YangQwQ/Stm32VisionSenseCar/Mobile-RemoteCtrl/res/bg.jpg

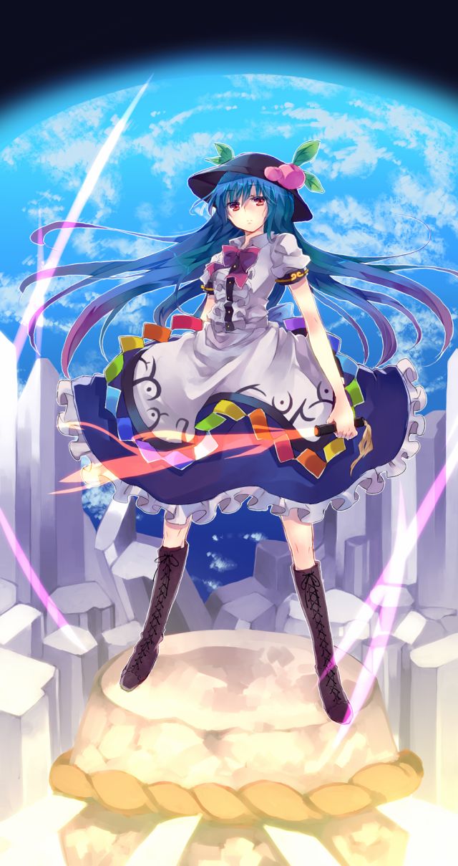
Mobile-RemoteCtrl/res/bg.jpg
