YangQwQ/Stm32VisionSenseCar/Stm32-Vision/src/exec/direct_exec.cpp

#include "src/exec/direct_exec.h"
#include "src/exec/nezha_direct.h"
#include "src/exec/bivar.h"
#include "src/core/board_log.h"   // blog::logf（临时调试 armdbg 用）
#include "Calibration.h"   // 集中式校准数据（舵机限位/移动表/标定点）
#include <math.h>
#include <string.h>

// 机械臂夹心坐标（车头系）：末端夹心 = f(移爪pwm, 抬落pwm)，两连杆+曲柄非线性，
// 用实测散点反距离加权插值(IDW)（数据在 Calibration.h 的 kArmPts），FK/IK 由 bivar 查插。

// 分段线性插值（查表），横轴需升序。仍被 move/spin 时长表复用。
static float plerp(const float* xs, const float* ys, int n, float x) {
  if (x <= xs[0]) return ys[0];
  for (int i = 1; i < n; i++) {
    if (x <= xs[i]) {
      float t = (x - xs[i-1]) / (xs[i] - xs[i-1]);
      return ys[i-1] + t * (ys[i] - ys[i-1]);
    }
  }
  return ys[n-1];
}

// 机械臂末夹心坐标（车头系：x=前方cm / h=离地cm）→ bivar 散点插值；失败时置 0，由调用方限位提示兜底。
static void arm_fk(int16_t reach_pwm, int16_t lift_pwm, float* x_out, float* h_out) {
  if (!bivar::arm_fk((float)reach_pwm, (float)lift_pwm, x_out, h_out)) { *x_out = 0; *h_out = 0; }
}

// ================= 内部状态 =================
// 当前各舵机 PWM（写板前跟踪，随指令/步进更新）
static int16_t s_steer = STEER_CENTER;
static int16_t s_reach = REACH_CENTER;
static int16_t s_lift  = LIFT_CENTER;
static int16_t s_grip  = GRIP_CENTER;
// 机械臂当前"姿态模式": 离散动作(low/raise/clip/grasp/release/fold)落地后记录, 移动臂位的动作
// (持续步进/pose/reset)清除回普通。给状态行/AI 明确"当前处于什么动作语义", 避免仅靠坐标/爪态猜。
enum { ARM_NONE = 0, ARM_LOW, ARM_RAISE, ARM_CLIP, ARM_GRASP, ARM_RELEASE, ARM_FOLD };
static uint8_t s_arm_mode = ARM_NONE;   // 是否处于折叠位: fold 置位, 移动臂位的动作清除

// 缓动分离：s_reach/s_lift = 目标(逻辑/状态读取用)，s_reach_w/s_lift_w = 实际写入板的 PWM。
// 离散定位(fold/arm_pose/reset/init)在 update_tick 里用 S 形曲线把 s_*_w 追向 s_*；
// 持续动作仍逐拍小步、不经缓动。t0 为缓动曲线行程锚点（新指令跳远时重置）。夹爪不参与。
static int16_t s_reach_w = REACH_CENTER;
static int16_t s_lift_w  = LIFT_CENTER;
static int32_t s_reach_t0 = 0;
static int32_t s_lift_t0  = 0;

// 小车行驶状态（本地合成用）：0 停 / 1 前 / 2 后
static int s_car_motion = 0;
static int s_spin = 0;        // 原地旋转：0 无 / 1 左进右退(右转/顺时针) / -1 左退右进(左转/逆时针)

// 夹心逻辑位置（车头系：x 前方cm / h 离地cm）。持续按钮在它之上步进后经 arm_pose 单点定位，
// 不再依赖 FK→微步→反解的连续闭环（散点 IDW 下该闭环会卡住）。由 每次臂指令 同步重置。
static float s_claw_x = 0, s_claw_h = 0;

// 最近一次 arm_pose 的位姿诊断：记录请求位姿与实际落点，供 read_state 反馈。
// 撞边界已被 arm_clamp 夹到盒内最近合法点并继续移动（reason=1），不再拒绝。
// 只在产生后 ARM_DIAG_FRESH_MS 内挂到状态行：诊断要跟着"刚下的那条指令"出现，过期就不再
// 重复挂（否则旧诊断会一轮轮粘在状态行上，让 AI 以为本轮的位姿又失败了）。
#define ARM_DIAG_FRESH_MS 8000
// 到位容差：正运动学回读的实际落点与请求相差超过它就认定"这个位姿做不到"。
// 可达域是条弯带而反查只按散点外接矩形判可达，弯带外的位姿会反解出"最接近"的 pwm、迭代
// 不收敛就停在半路（既不撞舵机限位也无报错），表现为"爪降不下去/卡住"——必须显式报出来。
#define ARM_POSE_TOL_CM 0.6f
static struct {
  bool armed;     // 本轮有诊断
  int  reason;    // 1=撞边界已夹紧到最近合法点 / 2=移爪越限 / 3=抬落越限 / 4=位姿没到位
  float x, h;     // 请求的目标夹心坐标（未夹紧前）
  float cx, ch;   // reason=1 时夹紧后的实际落点
  int rr, ll;     // 反解出的 target pwm
  float ax, ah;   // 正运动学回读的实际落点（reason=4 的判据与报数）
  unsigned long t_ms;   // 诊断产生时刻
} s_arm_rej = { false, -1, 0, 0, 0, 0, 0, 0, 0, 0, 0 };

// 灯状态记忆（供 get_state 查询同步手机按钮）：仅记录是否开，开关动作由 nezha::led 落地。
static bool s_light_front = false;
static bool s_light_vibe  = false;
static bool s_light_back  = false;

// 连续机械臂动作（联动模式）：axis=-1 表示无活跃动作。
// 前伸/缩回、抬/落都按"保持另一维"的末端位姿轨迹联动双舵机，而非单舵机步进。
static struct {
  int8_t axis;     // -1 无 / 0 联动前伸(x) / 1 联动抬落(h)
  int16_t dir;     // 每拍目标位姿增量方向（+/-）
  int16_t budget;  // 剩余拍数，0=持续
} s_active = { -1, 0, 0 };

// arm grasp 的第二步（合爪后自动抬臂）：时间到就发起定量的 lift_up。
// 拆成两拍是因为舵机合爪要时间 —— 同拍抬臂会在方块还没被夹住时就把它带飞。0=无待办。
static unsigned long s_grasp_lift_at = 0;
static int16_t s_grasp_lift_cm = (int16_t)GRASP_LIFT_CM;

// AI 持续 move 的行驶截止时刻（ms），0=不限时。到期 update_tick 里自动停轮，
// 兜底 AI 两次决策间的长时间盲走；任何新轮动作/手动接管会刷新或关闭它。
// volatile：worker 任务 / loop(update_tick) / 命令回调跨核读写，防寄存器缓存读到旧值。
static volatile unsigned long s_move_cap_until = 0;

static void drive_motors(int spd) {
  int16_t u = spd < 0 ? (uint16_t)-spd : (uint16_t)spd;
  bool rev = spd < 0;
  // 轮map：M1左后 M2右后 M3右前 M4左前；左轮 a 正前，右轮 b 正前。
  nezha::set_motor(1, rev ? 0u : u, rev ? u : 0u);
  nezha::set_motor(2, rev ? u : 0u, rev ? 0u : u);
  nezha::set_motor(3, rev ? u : 0u, rev ? 0u : u);
  nezha::set_motor(4, rev ? 0u : u, rev ? u : 0u);
}

static void set_steer_pwm(int16_t p);  // 前向声明：send_spin 在回正转向轮时会调用

// 原地旋转：目标角(deg) → 通电时长(ms)，查 SPIN_TBL_* 表线性插值（角升序，0 点隐含 (0,0)）。
// 实测曲线启动段与稳态每度 ms 差异大，单斜率公式拟合不了，查表才跟得上（见 Calibration.h）。
static long spin_ms_for(float deg) {
  if (deg <= 0) return 0;
  for (int i = 1; i < SPIN_TBL_N; i++) {
    if (deg <= SPIN_TBL_DEG[i]) {
      float t = (deg - SPIN_TBL_DEG[i-1]) / (SPIN_TBL_DEG[i] - SPIN_TBL_DEG[i-1]);
      return SPIN_TBL_MS[i-1] + (long)(t * (SPIN_TBL_MS[i] - SPIN_TBL_MS[i-1]));
    }
  }
  // 超出末点: 用末段斜率外推(大角度少见, 粗给即可)
  float k = (float)(SPIN_TBL_MS[SPIN_TBL_N-1] - SPIN_TBL_MS[SPIN_TBL_N-2]) /
            (SPIN_TBL_DEG[SPIN_TBL_N-1] - SPIN_TBL_DEG[SPIN_TBL_N-2]);
  return SPIN_TBL_MS[SPIN_TBL_N-1] + (long)((deg - SPIN_TBL_DEG[SPIN_TBL_N-1]) * k);
}

// 原地旋转（普通四轮滑移式，无需特殊轮子）：左/右侧轮反向拖胎绕中心旋转。
// dir=+1 左进右退=右转(顺时针) / -1 左退右进=左转(逆时针) / 0 停；speed=单车轮 pwm 0..1000。
// 车轮映射与 drive_motors 一致：左轮 a 正前、右轮 b 正前，故 dir>0 统一写 (a,0)、dir<0 统一写 (0,b)。
static void send_spin(const JsonObjectConst& p) {
  int dir = p["dir"] | 0;
  int spd = p["speed"] | 500;
  // 原地旋转前必须回正转向轮（前轮直行位），否则拖胎方向不纯、转不正（Bug6）。
  // dir=0（停车）不动舵机，避免每次停转都无谓地 reset 转向。
  if (dir != 0 && s_steer != STEER_CENTER) {
    set_steer_pwm(STEER_CENTER);
  }
  if (dir == 0) spd = 0;  // dir=0 = 停车，speed 必须连同归零，否则默认 500 会让轮子继续转
  if (spd < 0) spd = 0;
  if (spd > 1000) spd = 1000;
  if (dir != 0 && spd < SPIN_MIN_SPEED) spd = SPIN_MIN_SPEED;  // 低于拖得动线则抬升
  s_spin = dir == 0 ? 0 : (dir > 0 ? 1 : -1);
  uint16_t u = (uint16_t)spd;
  if (dir > 0) {
    nezha::set_motor(1, u, 0); nezha::set_motor(2, u, 0);
    nezha::set_motor(3, u, 0); nezha::set_motor(4, u, 0);
  } else {
    nezha::set_motor(1, 0, u); nezha::set_motor(2, 0, u);
    nezha::set_motor(3, 0, u); nezha::set_motor(4, 0, u);
  }
  s_car_motion = 0;  // 原地旋转不算前进/后退
  // 带 angle_deg = 定角微操：按时长近似自停（无里程计，不闭环）。
  int ang = p["angle_deg"] | 0;
  if (ang > 720) ang = 720;  // 粗钳防超长时限（手机/AI 已限 0..500，仅兜底裸前端）
  if (dir != 0) {
    // 显式 ms(调试/标定口)优先: 直接指定通电毫秒自停, 不做角度换算与滑行角补偿 —— 标定"真实每度ms"用。
    // angle_deg 可为 0(持续旋转口), 但带了 ms 就按定长精确到点自停, 不再落进"持续兜底"。
    long msv = p["ms"].is<int>() ? (long)(p["ms"] | 0) : 0;
    if (msv > 0) {
      exec::set_move_cap_ms((int)msv);
      return;
    }
  }
  if (dir != 0 && ang > 0) {
    // 目标角 → 通电时长：查表插值（见 spin_ms_for）。实测启动段与稳态速率差异大，查表最准。
    long ms = spin_ms_for((float)ang);
    exec::set_move_cap_ms(ms > 0 ? (int)ms : 1);
  } else if (dir != 0) {
    // 持续旋转（无 angle_deg / 无 ms）：摇杆 SpinMode 的主入口(捏杆转、松手 spin(0) 停)。
    // 不带任何"自动到点自停"的兜底: 一是它会骗人(用户以为只转一点、实际转 2.6s 半天)，
    // 二是持续旋转本就不累积车向底座(car_update_pose 只在带 angle_deg 时 +转角)，转了也不进入
    // 姿态基准，自动停毫无价值。靠显式 stop 或 spin(0) 收尾 —— 这是摇杆天然语义。
    // AI 侧 spin 一律带 angle_deg(见 ai_client 补默认角)，走的是上面定角分支，不会进这里。
  }
}

static void clear_active(void) { s_active.axis = -1; s_active.budget = 0; }

// 撤销"合爪后待抬臂"（任何新的臂指令/停车/回正都作废它，避免隔了几拍突然自己抬一下）。
static void clear_grasp_pending(void) { s_grasp_lift_at = 0; }

// 前置声明：grasp 的第二步（合爪后自动抬臂）在 update_tick 里发起，而定义在它之后。
static void setup_active(int8_t axis, int16_t dir, bool has_dist, int16_t dist);

// S 形缓动一步：把"已写 cur"平滑追向"目标 tgt"。速度按正弦分布（两端 0=缓出缓入、中段峰值），
// 目标显著跳远(新指令)会重新锚定行程并本拍不动作为缓入；到位直接落定，避免往返抖动。
static void advance_smooth(int16_t* cur, int16_t tgt, int32_t* t0) {
  int32_t gap = (int32_t)tgt - (int32_t)*cur;
  if (gap == 0) { *t0 = 0; return; }
  int32_t rem = gap < 0 ? -gap : gap;
  if (rem > *t0) { *t0 = rem; return; }             // 目标跳远 → 缓入起点，本拍不动
  float p = (float)(*t0 - rem) / (float)*t0;        // 已完成比例 0..1
  if (p > 1.0f) p = 1.0f;
  int16_t step = (int16_t)(ARM_SMOOTH_PEAK * sinf((float)PI * p) + 0.5f);
  if (step < 1) step = 1;                           // 保底，确保最终必到
  if (rem <= step) { *cur = tgt; *t0 = 0; return; }
  *cur += (gap > 0 ? step : -step);
}

static void write_steer(void) { nezha::set_servo(1, (uint16_t)s_steer); }
static void write_reach(void) { nezha::set_servo(2, (uint16_t)s_reach_w); }
static void write_grip(void)  { nezha::set_servo(3, (uint16_t)s_grip); }
static void write_lift(void)  { nezha::set_servo(4, (uint16_t)s_lift_w); }

static void set_steer_pwm(int16_t p) {
  if (p < STEER_LO) p = STEER_LO;
  if (p > STEER_HI) p = STEER_HI;
  s_steer = p; write_steer();
}

void exec::init(void) {
  // 惰性：nezha::init 幂等。回中四个舵机 + 电机 0。
  bivar::arm_init();   // 校验机械臂夹心标定散点并置 ready（setup 期调用一次，幂等）
  set_steer_pwm(STEER_CENTER);
  s_reach = REACH_CENTER;  write_reach();
  s_lift  = LIFT_CENTER;   write_lift();
  s_grip  = GRIP_CENTER;   write_grip();
  drive_motors(0);
  // 灯复位: 哪吒扩展板的灯由**它自己的硬件寄存器**保持(不经本 MCU GPIO), MCU 重启/重新烧录后,
  // 灯在上一次的状态里**仍然亮着**, 而本板 s_light_* 记忆在重启后是不会自己变 false 的 —— 于是"灯
  // 实际亮着、状态却记成灭", 手机/状态位跟灯对不上(烧录后发现灯亮着但状态不同步, 就是这个)。
  // 这里主动关三盏灯并清记忆: 重启/回正 = 回到"灯灭 + 状态灭"的一致初始态(清晰直观, 符合直觉)。
  nezha::led("front", false); nezha::led("vibe", false); nezha::led("back", false);
  s_light_front = false; s_light_vibe = false; s_light_back = false;
}

void exec::reset(void) {
  s_car_motion = 0;
  s_spin = 0;
  s_move_cap_until = 0;
  clear_active();
  clear_grasp_pending();
  s_arm_rej.armed = false;  // 回正清掉旧的"目标不可达"诊断，避免状态残留误导
  exec::init();
}

void exec::update_tick(void) {
  // AI 持续/微操动作的行驶时限兜底：到期自动停轮（转向/机械臂不干预），状态复位便于 AI 看到"停止"。
  if (s_move_cap_until != 0 && (long)(millis() - s_move_cap_until) >= 0) {
    s_move_cap_until = 0;
    drive_motors(0);
    s_car_motion = 0;
    s_spin = 0;  // 原地旋转定角到点也一并复位，避免状态误报"仍在原地转"
  }
  // arm grasp 第二步：合爪等够时间后自动定量抬臂（起点锚在舵机真实位置，见 setup_active）。
  if (s_grasp_lift_at != 0 && (long)(millis() - s_grasp_lift_at) >= 0) {
    s_grasp_lift_at = 0;
    setup_active(1, +1, true, s_grasp_lift_cm);
    blog::logf(blog::EXEC, "grasp: 合爪完成, 抬臂 %dcm", s_grasp_lift_cm);
  }
  if (s_active.axis < 0) {
    // 无活跃持续动作：离散定位（fold / arm_pose / reset / init）经 S 形缓动把已写值追向目标，
    // 避免一次性跳舵机把整车带震。夹爪不参与，仍即时到位。
    int16_t nr = s_reach_w, nl = s_lift_w;
    advance_smooth(&nr, s_reach, &s_reach_t0);
    advance_smooth(&nl, s_lift,  &s_lift_t0);
    if (nr != s_reach_w || nl != s_lift_w) { s_reach_w = nr; s_lift_w = nl; write_reach(); write_lift(); }
    return;
  }
  // 夹心持续平动：在逻辑位置 s_claw 上沿目标轴步进、保持另一维，再 arm_pose 单点定位。
  // 连续步进需节流帧率：伺服跟不上会产生滞后，FK 反馈读到滞后位置再回拽 → 极限环。
  // 约 50ms 落一步，伺服跟得上、反馈才稳。
  static uint32_t s_arm_step_ms = 0;
  uint32_t now_ms = millis();
  if (s_arm_step_ms != 0 && now_ms - s_arm_step_ms < 50) return;
  s_arm_step_ms = now_ms;
  if (s_claw_x < 1.f && s_claw_h < 1.f) {   // 逻辑位置未初始化（reset 后首动）：从当前舵机反算
    arm_fk(s_reach, s_lift, &s_claw_x, &s_claw_h);
  }
  float tx = s_claw_x, th = s_claw_h;
  if (s_active.axis == 0) tx += ARM_STEP_CM * s_active.dir;   // 前伸/缩回：x 变，h 不变
  else                    th += ARM_STEP_CM * s_active.dir;   // 抬/落：h 变，x 不变
  // 撞边界先夹到盒内合法点（继续移动，不拒绝）
  bivar::arm_clamp(&tx, &th);
  if (!exec::arm_pose(tx, th)) { clear_active(); return; }    // 夹紧后仍不可达（物理限位）：到边即停
  s_reach_w = s_reach; s_lift_w = s_lift; write_reach(); write_lift();
  // 回授协调：只把"被步进的轴"锚到真实 FK，保持轴维持命令值——避免 fk 噪声把保持轴带入
  // 极限环 / 按住后反向漂移。臂到真实物理极限时 FK 停进，s_claw 随之停，命令不再空推。
  float rxx = 0, rhh = 0;
  if (bivar::arm_fk((float)s_reach, (float)s_lift, &rxx, &rhh)) {
    if (s_active.axis == 0) { s_claw_x = rxx; s_claw_h = th; }   // 移爪：x 跟回授，h 保持命令
    else                    { s_claw_h = rhh; s_claw_x = tx; }   // 抬落：h 跟回授，x 保持命令
  } else {
    s_claw_x = tx; s_claw_h = th;     // 反算越数据范围读不到：回退用目标（夹紧后仍 push）
  }
  // 到边界即停：连续 N 拍"被步进的那一轴"FK 回读几乎不动，说明已顶到机械/可达域边界，再推只是让
  // arm_pose 反复重解同一个位姿 —— 最高位附近散点稀疏，IDW 会在两个解之间来回跳，舵机就嗡嗡抽搐
  // (实测只在抬到最高位时出现)。这里主动停，和"收到 stop(scope=arm)/新离散动作"是同一条清场路径。
  // ⚠️ 判定只看**被步进的那一轴**(抬升=这拍 s_claw_h 变 → 看 h；移爪=看 x)，**不看保持轴**：
  //   保持轴维持命令值、但 arm_pose 每次反解写入的 PWM 在可达域边界附近外插抖动会让 FK 回读跟着微动
  //   (实测 ±0.03~0.08cm)，若把两轴做成"且"关系，保持轴的噪声会把 stall 计数屡屡清零 → 到顶永远判不出来，
  //   持续步进就抽插。分轴判据让"动的那轴到位" 独立成立。
  {
    static float s_last_fk_x = -999, s_last_fk_h = -999;
    static int s_fk_stall = 0;
    bool moving_h = (s_active.axis == 1);   // 被步进的是抬落(h)轴(否则是移爪 x 轴)
    float dv = moving_h ? fabsf(rhh - s_last_fk_h) : fabsf(rxx - s_last_fk_x);
    if (dv < ARM_STALL_EPS_CM) {
      if (++s_fk_stall >= ARM_STEP_STALL_N) {
        blog::logf(blog::EXEC, "连续动作已到边界(FK 连续 %d 拍停在 (%.1f,%.1f)), 停止步进",
                   s_fk_stall, rxx, rhh);
        s_fk_stall = 0;
        clear_active();
        return;
      }
    } else {
      s_fk_stall = 0;
    }
    s_last_fk_x = rxx; s_last_fk_h = rhh;
  }
  if (s_active.budget > 0) {
    if (--s_active.budget <= 0) clear_active();
  }
}

static void setup_active(int8_t axis, int16_t dir, bool has_dist, int16_t dist) {
  s_active.axis = axis;
  s_active.dir = dir;
  s_active.budget = has_dist ? (int16_t)(dist * ARM_CNT_PER_CM) : 0;
  // 每次持续移动起点：把逻辑坐标重新锚到舵机真实当前位置（FK）。否则 reset/fold/离散
  // arm_pose 后残留旧逻辑值，首拍会从旧坐标起步、朝反方向先补一枪。
  float fx = 0, fh = 0;
  if (bivar::arm_fk((float)s_reach_w, (float)s_lift_w, &fx, &fh)) { s_claw_x = fx; s_claw_h = fh; }
}

static void send_arm(const JsonObjectConst& p) {
  // 每次手臂指令先清掉可能残留的旧联动步进（s_active）：防止上次持续动作因 button_up/限位
  // 等原因未清干净，导致本次新指令被上次残留干扰而"点了没反应"（回正=全清后即恢复）。
  clear_active();
  clear_grasp_pending();   // 新臂指令作废上一条 grasp 未执行的抬臂（grasp 分支自己会重新置上）
  const char* act_ = p["act"] | "";
  bool has_dist = p["dist_cm"].is<int>();
  int16_t dist = (int16_t)((int)(p["dist_cm"] | 0));

  if (!strcmp(act_, "lift_up") || !strcmp(act_, "lift_down")) {
    // 抬落（联动 h 轴）：lift_up = 末端升高（h+）；lift_down = 降低（h-），保持 x 不变。
    int16_t dir = !strcmp(act_, "lift_up") ? +1 : -1;
    s_arm_mode = ARM_NONE;   // 移动臂位即脱离固定姿态
    setup_active(1, dir, has_dist, dist);
  } else if (!strcmp(act_, "reach_forward") || !strcmp(act_, "reach_backward")) {
    // 移爪（联动 x 轴）：forward = 前伸（x+）；backward = 缩回（x-），保持高度 h 不变。
    int16_t dir = !strcmp(act_, "reach_forward") ? +1 : -1;
    s_arm_mode = ARM_NONE;
    setup_active(0, dir, has_dist, dist);
  } else if (!strcmp(act_, "low")) {
    // 低姿夹取准备位（一次性离散，落点见 Calibration.h ARM_LOW_*）：降到标定过的固定低姿，之后靠
    // 车的前后移动把目标送进两指之间。不夹爪、不动轮子。
    exec::arm_low();
  } else if (!strcmp(act_, "clip")) {
    clear_active();
    s_grip = GRIP_CLOSE; write_grip();
    s_arm_mode = ARM_CLIP;   // 已合上夹爪(未抬臂)
  } else if (!strcmp(act_, "grasp")) {
    // 夹取+抬臂组合（合爪 → 等舵机合到位 → 定量抬升）：一步到位省一轮云端往返。
    // 抬升量固定（GRASP_LIFT_CM），不会像持续 lift_up 那样顶到机械止点抽搐。
    clear_active();
    s_grip = GRIP_CLOSE; write_grip();
    s_arm_mode = ARM_GRASP;   // 合爪并已请求抬臂(抬升在 update_tick 异步完成, 被打断会清回普通)
    s_grasp_lift_cm = (int16_t)GRASP_LIFT_CM;
    s_grasp_lift_at = millis() + (unsigned long)GRASP_SETTLE_MS;
  } else if (!strcmp(act_, "release")) {
    clear_active();
    s_grip = GRIP_HI; write_grip();
    s_arm_mode = ARM_RELEASE;   // 已松开夹爪
  } else if (!strcmp(act_, "fold")) {
    // 收臂折叠回平台（一次性离散）：抬落 + 移爪都收到 130、夹爪回中；摄像头到最高位扩大视野、避开盲区。
    // 不动车轮（区别于 reset 的全停）。
    clear_active();
    s_lift  = FOLD_LIFT_PWM;  write_lift();
    s_reach = FOLD_REACH_PWM; write_reach();
    s_grip  = GRIP_CENTER;    write_grip();
    s_arm_mode = ARM_FOLD;
  }
}

// 定距指令的油门要**先于写电机**定下来，且写电机与算时长必须用**同一个**油门，否则模型不自洽。
// 为什么必须按距离降档：`plerp` 在首档以下整段钳位，而各档的起停余量 c 相差很大（0.5 档 c=3.45cm）。
// cm ≤ c(a) 时 target 被算成 0 ⇒ 脉冲塌成 MV_MIN_PULSE_MS 的**满油门一冲** —— 那已经不是"走 2cm"了，
// 而 AI 仍以为自己在做厘米级微调。降档后取 c 小于本次距离的最低已标定档，距离才真的对得上。
// 档位只在标定表内取；请求油门低于最低档（AI 偶发 0.1）时抬到最低档 —— 低于它的速度没有实测值，
// 照原样发等于把"指令走了、车没动"重新引入一遍（表外不外推）。
static float pick_throttle_for(float a, int cm) {
  for (int i = MV_N - 1; i >= 0; i--) {
    if (MV_SPEED_X[i] > a + 1e-4f) continue;   // 只降不升（除下面的兜底）
    if (MV_COAST_Y[i] < (float)cm) return MV_SPEED_X[i];
  }
  return MV_SPEED_X[0];
}

static void send_move(const JsonObjectConst& p) {
  float th = p["throttle"] | 0.0f;
  float st = p["steering"] | 0.0f;
  int cm = p["distance_cm"] | 0;

  float a = fabsf(th); if (a > 1.0f) a = 1.0f;
  if (cm > 0 && a > 0.001f) {
    a = pick_throttle_for(a, cm);
    th = th < 0 ? -a : a;   // 写回，使 PWM 与下面计时的油门是同一个值
  }

  if (fabsf(th) > 0.001f) {
    int16_t spd = (int16_t)(a * 1000.0f + 0.5f);
    if (th < 0) spd = -spd;
    drive_motors(spd);
    s_car_motion = th > 0 ? 1 : 2;
  } else {
    drive_motors(0);
    s_car_motion = 0;
  }
  if (fabsf(st) > 0.001f) {
    float s = st; if (s > 1.0f) s = 1.0f; if (s < -1.0f) s = -1.0f;
    set_steer_pwm((int16_t)(STEER_CENTER + s * 30.0f));
  } else {
    set_steer_pwm(STEER_CENTER);   // 直行时回正：上一次带转向的 move 若不回正, 之后所有 move 都在画弧
  }
  s_spin = 0;  // 常规行驶（move）接管后清除原地旋转
  // 带 distance_cm = 定距微操：本板无里程计，按时长近似自停。实测 actual≈v·(t−死区)+c，
  // v/c 随油门插值标定表，时长 = MV_START_MS + (cm−c)/v。
  // ⚠️ 两处都别省：v/c 表拟合自长脉冲，短脉冲会整段落在起步死区里 —— 车一动不动，而
  // car_update_pose 照样按 distance_cm 累加 → AI 记忆与实际分家（空夹的主要来路）。
  // 油门 a 已在上面按距离定过档，这里直接用同一个值。
  if (cm > 0 && a > 0.001f) {
    float v = plerp(MV_SPEED_X, MV_SPEED_Y, MV_N, a);
    float c = plerp(MV_COAST_X, MV_COAST_Y, MV_N, a);
    float target = cm > c ? cm - c : 0.0f;
    long ms = MV_START_MS + (long)(target / v * 1000.0f);
    if (ms < MV_MIN_PULSE_MS) ms = MV_MIN_PULSE_MS;
    exec::set_move_cap_ms((int)ms);
  }
}

static void send_stop(const JsonObjectConst& p) {
  const char* scope = p["scope"] | "all";
  if (!strcmp(scope, "arm")) {
    clear_active();
    clear_grasp_pending();
  } else {
    drive_motors(0);
    s_car_motion = 0;
    s_spin = 0;
  }
}

bool exec::set_servo(uint8_t logical, uint16_t pwm) {
  // 调试直驱：直接写原始 pwm（50..250），不过标定限位——用于探机械极限/标定。
  if (pwm < 50 || pwm > 250) return false;
  switch (logical) {
    case 0:  // 转向
      s_steer = (int16_t)pwm; write_steer();
      return true;
    case 1:  // 左 = 前后移爪
      s_reach = (int16_t)pwm; write_reach();
      return true;
    case 2:  // 右 = 抬落
      s_lift = (int16_t)pwm; write_lift();
      return true;
    case 3:  // 前 = 夹爪
      s_grip = (int16_t)pwm; write_grip();
      return true;
    default:
      return false;
  }
}

// 迭代反解：以 IDW 反查询为初值，用正演 FK 走牛顿迭代校正，使 FK(pwm)→目标精确，
// 消除 IDW FK∘IK 不互逆（否则持续相控时每步被 FK 打回 / 或边界空推）。到物理限位自动饱和停滞。
static bool ik_refine(float x, float h, float* r, float* l) {
  if (!bivar::arm_ik(x, h, r, l)) return false;   // 反查初值；越标定盒返回 false
  float rp = *r, lp = *l;
  for (int it = 0; it < 7; it++) {
    float fx, fh;
    if (!bivar::arm_fk(rp, lp, &fx, &fh)) break;             // 出标定数据区：没法校正，用当前值
    float ex = x - fx, eh = h - fh;
    if (fabsf(ex) < 0.02f && fabsf(eh) < 0.02f) break;        // 已收敛
    const float d = 1.0f;                                     // 数值雅可比：reach/lift 各偏 d
    float fxr, fhr, fxl, fhl;
    if (!bivar::arm_fk(rp + d, lp, &fxr, &fhr)) break;
    if (!bivar::arm_fk(rp, lp + d, &fxl, &fhl)) break;
    float J00 = (fxr - fx) / d, J01 = (fxl - fx) / d;
    float J10 = (fhr - fh) / d, J11 = (fhl - fh) / d;
    float det = J00 * J11 - J01 * J10;
    if (fabsf(det) < 1e-6f) break;                            // 奇异（饱和区雅可比退化）
    float dr = (ex * J11 - J01 * eh) / det;
    float dl = (-J10 * ex + J00 * eh) / det;
    dr = fmaxf(-6.f, fminf(6.f, dr));                         // 阻尼防发散
    dl = fmaxf(-6.f, fminf(6.f, dl));
    rp += dr; lp += dl;
    rp = fmaxf((float)REACH_LO, fminf((float)REACH_HI, rp));
    lp = fmaxf((float)LIFT_LO, fminf((float)LIFT_HI, lp));
  }
  *r = rp; *l = lp;
  return true;
}

bool exec::arm_pose(float x, float h) {
  // 给末端目标位姿：x=夹心车头前方 cm，h=夹心离地高度 cm。反解：IDW 反查初值 + FK 迭代校正
  // （使反解出的 PWM 的实际 FK 回读≈目标，收敛到物理饱和为止）。超出盒先夹到盒内最近的
  // 合法点再反解——不拒绝，移到最接近的合法位姿；反解落在物理舵机限位外也夹到限位继续。
  s_arm_rej.x = x; s_arm_rej.h = h;
  s_arm_rej.armed = false;   // 诊断只反映"最近这一次 arm_pose"：先清，下面按本轮结果重新置位
  s_arm_rej.reason = 0;      // 原因同清：否则下面判 armed 时会沿用上一轮的原因(如上次的 4)而误报
  bool clamped = bivar::arm_clamp(&x, &h);
  // 夹到盒内后戳地(h<0)已不可达（盒 h 最小>0），这里仅兜底负高度竖直挤压情形。
  float reach = 0, lift = 0;
  if (!ik_refine(x, h, &reach, &lift)) return false;  // 反查初值即出盒→不可达
  int rr = (int)roundf(reach), ll = (int)roundf(lift);     // 左=移爪 reach / 右=抬落 lift
  // 反解在稀疏角区外插可能越物理限位：夹到舵机限位继续执行而非拒绝，让标定盒内的位姿总能
  // 尽力移到组件物理边界（否则 IDW 一外插超限就被当"不可达"卡住）。撞物理限位也算夹紧记进诊断。
  bool phy_r = false, phy_l = false;
  if (rr < REACH_LO) { rr = REACH_LO; phy_r = true; }
  else if (rr > REACH_HI) { rr = REACH_HI; phy_r = true; }
  if (ll < LIFT_LO) { ll = LIFT_LO; phy_l = true; }
  else if (ll > LIFT_HI) { ll = LIFT_HI; phy_l = true; }
  // 联动：一次同时给左右两舵机目标。set_servo 内部会限 pwm 并同步状态。
  bool ok = set_servo(1, (uint16_t)rr) & set_servo(2, (uint16_t)ll);
  // 到位校验：反解只在物理限位处才会失败，弯带外的位姿则会"尽力挪一下"就停住（见 ARM_POSE_TOL_CM
  // 注释）。这里用正运动学回读实际落点，偏离请求即记为诊断，让 AI 知道"这条位姿做不到"而不是
  // 只看状态行的绝对位置、反复重发同一条够不着的指令。
  bivar::arm_fk((float)rr, (float)ll, &s_arm_rej.ax, &s_arm_rej.ah);
  s_arm_rej.rr = rr; s_arm_rej.ll = ll;
  s_arm_rej.t_ms = millis();
  // reason 必须与本轮 armed 一起判定（曾漏写：仅 phy 命中时不更新 reason，于是报告沿用上一次的
  // 原因甚至初值 -1，AI 拿到的是错误的解释）。
  if (clamped) { s_arm_rej.reason = 1; s_arm_rej.cx = x; s_arm_rej.ch = h; }
  else if (phy_r) s_arm_rej.reason = 2;
  else if (phy_l) s_arm_rej.reason = 3;
  else if (fabsf(s_arm_rej.ax - x) > ARM_POSE_TOL_CM || fabsf(s_arm_rej.ah - h) > ARM_POSE_TOL_CM)
    s_arm_rej.reason = 4;
  s_arm_rej.armed = clamped || phy_r || phy_l || s_arm_rej.reason == 4;
  return ok;
}

bool exec::arm_low(void) {
  // 低姿夹取准备位：固定落到标定过的低姿（Calibration.h ARM_LOW_*），不夹爪、不动轮子。
  // 存在意义：低处可达域很窄，让上层凭坐标猜 (x,h) 会猜到够不着的地方、空夹且无报错；改成一个
  // 保证够得着的固定位，再用车的前后移动把目标送进两指之间（机械臂不能左右移动）。
  clear_active();   // 与其它 arm 指令一致：先清残留持续步进，否则首拍会朝旧方向补一枪
  s_arm_mode = ARM_LOW;   // 已降入低姿夹取位(后续移动臂位/pose 会清回普通)
  bool ok = exec::arm_pose(ARM_LOW_X_CM, ARM_LOW_H_CM);
  // 逻辑坐标锚到实际落点（连续步进起点/后续 diagnose 的基准），别沿用上一动作的旧值。
  float rx = 0, rh = 0;
  if (exec::arm_pos(&rx, &rh)) { s_claw_x = rx; s_claw_h = rh; }
  else { s_claw_x = ARM_LOW_X_CM; s_claw_h = ARM_LOW_H_CM; }
  return ok;
}

bool exec::arm_raise(void) {
  // 固定抬臂位：一次离散定位到标定过的固定高位（Calibration.h ARM_RAISE_*）。
  // 与持续 lift_up 的区别：arm_pose 是单发目标（update_tick 里 S 形缓动追到位），
  // 不会像连续步进那样在边界 IDW 反解两解间来回跳、舵机抽搐。
  clear_active();   // 与其它臂指令一致：先清残留持续步进
  clear_grasp_pending();
  s_arm_mode = ARM_RAISE;   // 已抬到固定高位(后续移动臂位/pose 会清回普通)
  bool ok = exec::arm_pose(ARM_RAISE_X_CM, ARM_RAISE_H_CM);
  float rx = 0, rh = 0;
  if (exec::arm_pos(&rx, &rh)) { s_claw_x = rx; s_claw_h = rh; }
  else { s_claw_x = ARM_RAISE_X_CM; s_claw_h = ARM_RAISE_H_CM; }
  return ok;
}

bool exec::arm_pos(float* x, float* h) {
  // 与 read_state 同源：报"当前命令的 pwm"的 FK（不是缓动途中的中间值），上层据此判"爪是否真的
  // 停在目标身上"时，看到的和自己读状态行是同一个数。标定未就绪返回 false（调用方按未知处理）。
  float fx = 0, fh = 0;
  if (!bivar::arm_fk((float)s_reach, (float)s_lift, &fx, &fh)) return false;
  if (x) *x = fx < 0 ? 0.0f : fx;
  if (h) *h = fh;
  return true;
}

bool exec::act(const char* type, const JsonObjectConst& params) {
  // 任何显式轮子/原地旋转指令都刷新或关闭 AI 的 move 时限，避免旧兜底在新指令后误停。
  if (!strcmp(type, "move") || !strcmp(type, "spin") || !strcmp(type, "stop")) s_move_cap_until = 0;
  if (!strcmp(type, "move"))   { send_move(params); return true; }
  if (!strcmp(type, "spin"))   { send_spin(params); return true; }
  if (!strcmp(type, "stop"))   { send_stop(params); return true; }
  if (!strcmp(type, "arm"))    { send_arm(params);  return true; }
  if (!strcmp(type, "arm_pose")) {
    // AI/手动指定位姿：x=夹心车头前方 cm，h=夹心离地高度 cm；不可达返回 false（不动）。
    s_arm_mode = ARM_NONE;   // 指定位姿脱离固定姿态(通用定位, 不再表达 low/raise/夹取等语义)
    clear_grasp_pending();
    return arm_pose(params["x"] | 0.0f, params["h"] | 0.0f);
  }
  if (!strcmp(type, "light")) {
    const char* kind = params["kind"] | "";
    bool on = params["on"] | false;
    bool ok = nezha::led(kind, on);
    if (ok) {
      if (!strcmp(kind, "front")) s_light_front = on;
      else if (!strcmp(kind, "vibe")) s_light_vibe = on;
      else if (!strcmp(kind, "back")) s_light_back = on;
    }
    return ok;
  }
  if (!strcmp(type, "reset"))  { exec::reset(); s_arm_mode = ARM_NONE; return true; }
  return false;
}

bool exec::is_continuous(const char* type, const JsonObjectConst& p) {
  if (!strcmp(type, "move")) {
    float th = p["throttle"] | 0.0f;
    float st = p["steering"] | 0.0f;
    return (fabsf(th) > 0.001f && !p["distance_cm"].is<int>()) ||
           (fabsf(st) > 0.001f && !p["angle_deg"].is<int>());
  }
  if (!strcmp(type, "spin")) {
    int d = p["dir"] | 0;
    return d != 0 && !p["angle_deg"].is<int>();  // 带 angle 的定角=有界，不需持续收尾
  }
  if (!strcmp(type, "arm")) {
    const char* act_ = p["act"] | "";
    bool cont = !strcmp(act_, "lift_up") || !strcmp(act_, "lift_down") ||
                !strcmp(act_, "reach_forward") || !strcmp(act_, "reach_backward");
    return cont && !p["dist_cm"].is<int>();
  }
  return false;
}

bool exec::wheels_moving() { return s_car_motion != 0 || s_spin != 0; }

bool exec::arm_moving() {
  // 机械臂还在动的情形有三类，各自与 wheels_moving()（只盯轮子 PWM）完全无关，缺一不可：
  // ① s_active.axis >= 0：持续步进（lift_up/down、reach_fwd/bwd）进行中，逐拍 arm_pose 定位。
  // ② s_grasp_lift_at != 0：grasp 合爪后正等待定时抬臂（第二步还没发起），画面仍在"夹起过程"中。
  // ③ S 形缓动未收敛：离散定位（fold/arm_pose/reset/init）在 update_tick 里把已写值 s_reach_w /
  //    s_lift_w 缓动追向目标 s_reach / s_lift，未追到就说明臂还没停。grasp 第二步的 lift 也走这路。
  // 只要有一类存在，臂就在动 —— AI 出帧若不等它会拍到"夹起过程"的中间态画面。
  if (s_active.axis >= 0) return true;
  if (s_grasp_lift_at != 0) return true;
  return (s_reach_w != s_reach) || (s_lift_w != s_lift);
}

bool exec::grip_closing() { return s_grip == GRIP_CLOSE; }

void exec::set_move_cap_ms(int ms) {
  s_move_cap_until = ms > 0 ? millis() + (unsigned long)ms : 0;
}

bool exec::light_on(const char* kind) {
  if (!strcmp(kind, "front")) return s_light_front;
  if (!strcmp(kind, "vibe"))  return s_light_vibe;
  if (!strcmp(kind, "back"))  return s_light_back;
  return false;
}

bool exec::read_state(char* buf, size_t cap) {
  const char* car = s_spin != 0 ? (s_spin > 0 ? "原地右转" : "原地左转")
                                : (s_car_motion == 1 ? "前进" : (s_car_motion == 2 ? "后退" : "停止"));
  const char* grip = s_grip <= GRIP_CLOSE + 5 ? "clip" : "release";
  // 机械臂到限位提示：告诉 AI 继续同向动作不会再有变化（需反向或调整姿态）。
  const char* reach_lim = s_reach >= REACH_HI - 2 ? " 已伸最远"
                        : (s_reach <= REACH_LO + 2 ? " 已缩最近" : "");
  const char* lift_lim  = s_lift >= LIFT_HI - 2 ? " 已触底"
                        : (s_lift <= LIFT_LO + 2 ? " 已触顶" : "");
  // 末端前端坐标（前向运动学）：让 AI 知道夹爪现在伸到多前、多高，判断还能往哪移/当前高度。
  // 括号内为左右舵机 PWM（Servo2=移爪 s_reach / Servo4=抬落 s_lift），供 exec_log 校准机械臂坐标。
  float fk_x = 0, fk_h = 0;
  arm_fk(s_reach, s_lift, &fk_x, &fk_h);
  if (fk_x < 0) fk_x = 0;
  // 臂态语义：当前处于哪个固定姿态（low/raise/grasp/fold），移动臂位的动作后回到"自由"。
  // 给 AI 明确反馈，避免"已折叠仍反复 fold / 已夹取却不知处于何态"。爪态(开/合)单独看 s_grip。
  const char* arm_stat = "自由";
  switch (s_arm_mode) {
    case ARM_LOW:     arm_stat = "low"; break;
    case ARM_RAISE:   arm_stat = "raise"; break;
    case ARM_GRASP:   arm_stat = "grasp"; break;
    case ARM_FOLD:    arm_stat = "fold"; break;
    default: break;
  }
  // 调试时才使用带pwm的
  // snprintf(buf, cap, "小车: %s | 夹爪: %s 姿态: %s 位置: (%.0f, %.0f)(%d,%d) %s%s", car, grip, arm_stat, fk_x, fk_h, (int)s_reach, (int)s_lift, reach_lim, lift_lim);
  snprintf(buf, cap, "小车: %s | 夹爪: %s 姿态: %s 位置: (%.0f, %.0f)%s%s",
           car, grip, arm_stat, fk_x, fk_h, reach_lim, lift_lim);
  // 撞边界/不可达诊断：反馈"想去哪、实际落到哪/反解成多少"，帮用户/AI 判断机械臂边界
  // （exec_log 推给手机）。reason=1 表示撞边界但已夹到最近合法点继续移动，非错误。
  // 只在诊断新鲜时挂（见 ARM_DIAG_FRESH_MS）：它是"刚下的那条指令的结果"，过期的别重复报。
  if (s_arm_rej.armed && millis() - s_arm_rej.t_ms <= ARM_DIAG_FRESH_MS) {
    char d[160];
    if (s_arm_rej.reason == 1) {
      snprintf(d, sizeof(d), " | 撞边界[已移至最近点(%.1f,%.1f)]", s_arm_rej.cx, s_arm_rej.ch);
    } else if (s_arm_rej.reason == 4) {
      snprintf(d, sizeof(d), " | 位姿没到位[请求(%.1f,%.1f)只到(%.1f,%.1f): 该位姿够不着, 换位姿或挪车]",
               s_arm_rej.x, s_arm_rej.h, s_arm_rej.ax, s_arm_rej.ah);
    } else {
      const char* rc = s_arm_rej.reason == 2 ? "移爪越限" : "抬落越限";
      snprintf(d, sizeof(d), " | 目标(%.1f,%.1f)不可达[%s] 反解reach=%d lift=%d",
        s_arm_rej.x, s_arm_rej.h, rc, s_arm_rej.rr, s_arm_rej.ll);
    }
    if (strlen(buf) + strlen(d) + 1 < cap) strcat(buf, d);
  }
  return buf[0] != '\0';
}
