YangQwQ/Stm32VisionSenseCar/Stm32-Vision/ai_client.cpp

#include "ai_client.h"
#include "config.h"
#include "camera.h"
#include "direct_exec.h"
#include "wifi_net.h"
#include "ground_proj.h"
#include "board_log.h"

#include <WiFi.h>
#include <WiFiClientSecure.h>
#include <HTTPClient.h>   // 统一处理 TLS/content-length/chunked，替代手写 http_exchange
#include <esp_timer.h>
#include <stdlib.h>  // malloc/free/strtol
#include <math.h>    // fabsf
#include "freertos/FreeRTOS.h"
#include "freertos/task.h"
#include "freertos/queue.h"
#include "freertos/semphr.h"
#include <ArduinoJson.h>
#include <esp_heap_caps.h>  // MALLOC_CAP_SPIRAM
#include <mbedtls/platform.h>  // mbedtls_platform_set_calloc_free（TLS 内存搬到 PSRAM）
#include <string.h>         // memset/strncpy（空间记忆表）
#include <stdarg.h>         // vsnprintf（ai::logf）

// 决策频率 / 步数上限
#define AI_INTERVAL_MS 1500
#define AI_MAX_STEPS_PER_GOAL 120
#define AI_EDITED_IMG_MAX (128 * 1024)
#define AI_EDITED_IMG_TTL_MS 60000
#define AI_CONNECT_TIMEOUT_MS 10000
#define AI_HTTP_TIMEOUT_MS 30000
#define AI_WAIT_FB_MIN_MS 10000   // wait 反馈节流：同一动作少于此间隔只回一条
#define AI_MOVE_CAP_MS 2000       // AI 持续 move 单次行驶时限（无里程计兜底，防决策间隔内盲走撞墙）
#define AI_MAX_NET_FAIL 4         // 连续"无有效输出"轮数上限：超过即中止任务并回报（防云端持续无响应时无限空转）
#define AI_HIST_N 8               // 历史环条数（AI 决策 + 插话共用，满员淘汰最旧）

// 本地巡航（approach / /move to）参数：定距段长、初对齐阈值、单次转向上限等。
#define AI_APPROACH_STOP_CM 15   // AI 自动靠近的到位距离（之后交给 AI 微操）
#define NAV_STOP_CM_GOTO 6       // /move to 的到位容差 cm（无里程计开环，留一点松量）
#define NAV_ALIGN_DEG 25         // 目标偏角超过此值先原地转向对齐，否则直行推进
#define NAV_MAX_SPIN_DEG 60      // 单次原地转向的角度上限（分步收敛）
#define NAV_MAX_SEG_CM 25        // 单次定距推进上限 cm（分步收敛、防冲）
#define NAV_MAX_ITERS 200        // 巡航最大迭代步数（防死循环）
#define NAV_WAIT_LOOPS 120       // 每段等待轮子停下的检测循环数（约 50ms 一拍）

// ArduinoJson 内存池改用 PSRAM，避免其小分配每轮在内部堆上反复申请/释放，
// 与 TLS 缓冲交错把内部堆切成碎块（导致握手 -17040/-32512 失败）。
struct PsramAllocator : public ArduinoJson::Allocator {
  void* allocate(size_t n) override { return heap_caps_malloc(n, MALLOC_CAP_SPIRAM); }
  void deallocate(void* p) override { if (p) heap_caps_free(p); }
  void* reallocate(void* p, size_t n) override { return heap_caps_realloc(p, n, MALLOC_CAP_SPIRAM); }
};
static PsramAllocator g_js_alloc;

// ---------------- worker / 槽 / 队列 ----------------

struct TaskLocal {
  char* text = nullptr;   // 目标文本（堆）
  char* ann = nullptr;    // 标注 JSON 或 {x,y,w,h,label}（堆）
  bool use_image = false;
  bool one_shot = false;  // 单轮模式：只执行一轮决策即收尾（/ai oneshot）
  long id = 0;            // 对应 ai_goal 的词表 id（回填 ai_result）
  unsigned long generation = 0;
  cmd::ReplyFn fn = nullptr;
  void* ctx = nullptr;    // 任务期 sink ctx（WS=堆 int*，BLE=nullptr）
  bool active = false;    // 槽是否已被 set_goal 激活
  float nav_x = 0, nav_y = 0;  // goto_target 目标坐标 / frame
  bool nav = false;             // 纯导航任务（/move to），不走 AI 闭环
  bool nav_global = false;      // true=沿用全局系；false=以当前车位姿为新原点
};

// 结果队列项：每项独立持有消息文本与恢复用的（fn, 本次堆拷贝 ctx）。
struct ResultItem {
  char* text = nullptr;
  cmd::ReplyFn fn = nullptr;
  void* ctx = nullptr;    // 每次入队新建的 int*（WS）；BLE nullptr
};

static TaskLocal g_slot;
static SemaphoreHandle_t g_mtx = nullptr;   // 保护 g_slot / m_generation
static SemaphoreHandle_t g_notify = nullptr; // 唤醒 worker 的二进制信号量
static QueueHandle_t g_result_q = nullptr;
static volatile unsigned long m_generation = 0;  // 代际号：每次 set_goal/cancel 自增
static volatile bool m_busy = false;
static TaskHandle_t g_worker = nullptr;

// 编辑图暂存（PSRAM）+ 时间戳；worker 内只读快照由 set_edited_image/取图互斥。
static uint8_t* g_edited = nullptr;
static size_t g_edited_len = 0;
static uint64_t g_edited_ts = 0;
static SemaphoreHandle_t g_img_mtx = nullptr;

// AI 任务进行中"插话"缓冲（ai_chat 写入、worker 每轮消费一次，受 g_mtx 保护）。
// 一次性消费：喂进下一轮 prompt 后清空，避免重复塞给 AI。
static char g_chat[256] = {0};
static bool g_chat_has = false;

// TLS 客户端（worker 唯一实例）：cancel/set_goal 可从其他任务 stop() 中止在途请求。
static WiFiClientSecure g_client;

// 最近一次响应的 HTTP 状态码（HTTPClient 写入，供上层 4xx 快速失败判定；0=未知）。
static int g_last_status = 0;

// ============ 全局坐标系 + 物体记忆（空间记忆） ============
// 车自身位姿：全局坐标 (x,y) cm + 车向角 heading。坐标系：任务开始车位置=原点，
// 初始车头=Y 正方向=0°，逆时针为正（x 向右）；右转(顺时针) heading 减小。
// 无里程计，位姿靠 move 定距 / spin 定角标定近似累积；AI 每次视觉观测会刷新物体
// 坐标，故里程漂移只在两次观测之间短暂存在，不累积误导。
static float s_car_x = 0, s_car_y = 0;
static int16_t s_car_heading = 0;

// 物体记忆表（通用：AI 觉得值得记的都记）。程序存全局坐标，喂给 AI 时一律换算成
// "当前车头局部系"（相对车头角度+距离），AI 零换算。stale=每轮未观测+1（过期不清空）。
// 每条保留最近 AI_OBS_N 次观测，取中位数融合——DeepSeek 单次报的像素/角度方差大
// （轮间跳变、reason 与 observe 字段不一致），中位数对单次离谱值鲁棒，防记忆被污染。
#define AI_MEM_MAX 8
#define AI_OBS_N 5
static struct {
  char name[16];
  float gx, gy;        // 全局坐标 cm（由观测中位数合成）
  uint32_t t_ms;       // 最近观测时刻
  int16_t stale;       // 0=新鲜；每轮未观测 +1；>20 时不再喂回
  bool valid;
  float hx[AI_OBS_N], hy[AI_OBS_N];  // 各次观测的全局坐标环形缓冲（入表时已按当时车位姿转换）
  uint8_t hn, hi;                    // 已存数量 / 写指针
} g_mem[AI_MEM_MAX];
static const float AI_PI = 3.14159265358979f;

// 角度归一化到 (-180,180]（方向计算统一口径）。
static float wrap180f(float a) {
  a = fmodf(a, 360.0f);
  if (a > 180.0f) a -= 360.0f;
  else if (a < -180.0f) a += 360.0f;
  return a;
}

// 取数组前 n 个元素的中位数（n≤AI_OBS_N，插入排序后取中间，仅用于观测融合）
static float median_n(const float* a, int n) {
  float t[AI_OBS_N];
  memcpy(t, a, n * sizeof(float));
  for (int i = 1; i < n; i++) {
    float v = t[i]; int j = i - 1;
    while (j >= 0 && t[j] > v) { t[j + 1] = t[j]; j--; }
    t[j + 1] = v;
  }
  return t[n / 2];
}

// 最近一条下发执行板的是否持续型（sink：stop 兜底判定）。任务起点复位。
static volatile bool g_last_continuous = false;

// 最近一条持续指令的类型（0=无/1=move/2=arm）。兜底 stop 时 Wheels 模式只适用于轮子残留。
static volatile int g_last_cont_type = 0;

// 本轮任务终结时的兜底 stop 模式，由打断方写入；worker 出口统一解析一次。
static volatile int g_stop_mode = (int)ai::StopMode::All;
static volatile uint64_t g_last_wait_fb_ms = 0;  // wait 反馈节流时间戳

static void enqueue_result(const char* text, cmd::ReplyFn fn, void* ctx);

// ---------------- 结果队列（worker → loop） ----------------

// 就地把一条 WS 文本转为合法 UTF-8（RFC6455 文本帧必须为 UTF-8）。
// 云端 AI 响应/日志偶发混入残缺 UTF-8 序列或非法字节，若原样塞进 WS TEXT 帧，
// 手机 Godot 会以关闭码 1007（Invalid frame payload data）断链。此时整条链路
// 的中文保持不变，仅把控制字符与非法/残缺序列替换为 '?'（1:1，不扩容）。
static void sanitize_ws_utf8(char* s) {
  char* w = s;
  const unsigned char* p = (const unsigned char*)s;
  while (*p) {
    unsigned char c = *p;
    int need = 0;
    if (c < 0x20 || c == 0x7f) { *w++ = '?'; p++; continue; }   // 控制字符
    if (c < 0x80) { *w++ = (char)c; p++; continue; }             // 合法 ASCII
    if (c >= 0xC2 && c <= 0xDF) need = 1;
    else if (c >= 0xE0 && c <= 0xEF) need = 2;
    else if (c >= 0xF0 && c <= 0xF4) need = 3;                   // 其余字节非法
    bool ok = need > 0;
    for (int i = 1; ok && i <= need; i++) {
      unsigned char cc = p[i];
      if (!cc || !(cc >= 0x80 && cc <= 0xBF)) ok = false;        // continuation 缺失/越界（含被截断的串尾）
    }
    if (ok) { for (int i = 0; i <= need; i++) *w++ = (char)p[i]; p += need + 1; }
    else { *w++ = '?'; p += 1; }                                 // 非法首字节/残缺序列：单字节替换
  }
  *w = 0;
}

void enqueue_result(const char* text, cmd::ReplyFn fn, void* ctx) {
  ResultItem* it = (ResultItem*)malloc(sizeof(ResultItem));
  if (!it) return;
  size_t n = strlen(text);
  it->text = (char*)malloc(n + 1);
  if (!it->text) { free(it); return; }
  memcpy(it->text, text, n + 1);
  sanitize_ws_utf8(it->text);   // 统一 WS 文本消毒：任何 enqueue 出口都走这里，防 1007 断链
  // WS：为本次结果单独堆拷贝 fd（loop 发送后释放）；BLE ctx 已为 nullptr。
  it->fn = fn;
  it->ctx = ctx ? new int(*(int*)ctx) : nullptr;
  if (xQueueSend(g_result_q, &it, 0) != pdTRUE) { free(it->text); free(it->ctx); free(it); }
}

// AI 调试日志：经 board_log（blog::AI）统一输出；/log ai（或 all）时转发手机。
void ai::logf(const char* fmt, ...) {
  char buf[256];
  va_list ap;
  va_start(ap, fmt);
  vsnprintf(buf, sizeof(buf), fmt, ap);
  buf[sizeof(buf) - 1] = 0;  // 截断防越界
  va_end(ap);
  // 统一走板端日志模块：始终写串口（带 [ai] 前缀）；/log ai on 时经日志队列转发手机。
  blog::logf(blog::AI, "%s", buf);
}

void ai::update() {
  ResultItem* it = nullptr;
  while (g_result_q && xQueueReceive(g_result_q, &it, 0) == pdTRUE) {
    if (it) {
      if (it->fn) it->fn(it->ctx, it->text);
      free(it->text);
      if (it->ctx) delete (int*)it->ctx;
      free(it);
    }
  }
}

// ---------------- 编辑图暂存 ----------------

void ai::set_edited_image(const uint8_t* data, size_t len) {
  if (!data || len == 0 || len > AI_EDITED_IMG_MAX) return;
  xSemaphoreTake(g_img_mtx, portMAX_DELAY);
  if (!g_edited) g_edited = (uint8_t*)heap_caps_malloc(AI_EDITED_IMG_MAX, MALLOC_CAP_SPIRAM);
  if (g_edited) {
    memcpy(g_edited, data, len);
    g_edited_len = len;
    g_edited_ts = esp_timer_get_time();
  }
  xSemaphoreGive(g_img_mtx);
  blog::logf(blog::AI, "收到编辑图 %u B", (unsigned)len);
}

static bool take_edited(uint8_t* buf, size_t cap, size_t* out_len) {
  bool ok = false;
  xSemaphoreTake(g_img_mtx, portMAX_DELAY);
  if (g_edited && g_edited_len > 0 &&
      (esp_timer_get_time() - g_edited_ts) < (uint64_t)AI_EDITED_IMG_TTL_MS * 1000 &&
      g_edited_len <= cap) {
    memcpy(buf, g_edited, g_edited_len);
    *out_len = g_edited_len;
    ok = true;
  }
  xSemaphoreGive(g_img_mtx);
  return ok;
}

// ---------------- PSRAM 增长缓冲 ----------------

struct PsaBuf {
  char* p = nullptr;
  size_t len = 0, cap = 0;
  bool ok = true;
  ~PsaBuf() { if (p) free(p); }
  bool ensure(size_t need) {
    if (len + need + 1 <= cap) return true;
    size_t nc = cap ? cap * 2 : 1024 * 1024;
    while (nc < len + need + 1) nc *= 2;
    char* np = (char*)heap_caps_realloc(p, nc, MALLOC_CAP_SPIRAM);
    if (!np) { ok = false; return false; }
    p = np; cap = nc; return true;
  }
  void put(const char* s) { if (!ok || !ensure(strlen(s)) ) { ok = false; return; } memcpy(p + len, s, strlen(s)); len += strlen(s); p[len] = 0; }
  void put(char c) { if (!ok || !ensure(1)) { ok = false; return; } p[len++] = c; p[len] = 0; }
};

// JSON 字符串转义：引号/反斜杠 + 控制字符（\n \r \t 等）。模型 reason 可能含换行，裸发会让云端
// 400 "invalid unicode/character"；中文等多字节字节序原样透传（UTF-8 合法）。
static void esc_append(PsaBuf& b, const char* s) {
  b.put('"');
  for (const char* c = s; *c; c++) {
    unsigned char ch = (unsigned char)*c;
    if (ch == '"' || ch == '\\') { b.put('\\'); b.put((char)ch); }
    else if (ch == '\n') { b.put('\\'); b.put('n'); }
    else if (ch == '\r') { b.put('\\'); b.put('r'); }
    else if (ch == '\t') { b.put('\\'); b.put('t'); }
    else if (ch < 0x20) { char h[7]; snprintf(h, sizeof(h), "\\u%04X", ch); b.put(h); }
    else b.put((char)ch);
  }
  b.put('"');
}

// 裁剪字符串尾部的残缺 UTF-8 序列：固定缓冲截断常切在汉字中间，残留半个字节会让云端判
// "invalid unicode code point" 400。原地修改；合法 UTF-8 输入不受影响。
static void utf8_clamp_tail(char* buf) {
  size_t n = strlen(buf), e = n, ncont = 0;
  while (e > 0) {
    unsigned char ch = (unsigned char)buf[e - 1];
    if ((ch & 0xC0) == 0x80) { e--; ncont++; continue; }        // 续字节：继续回退
    int need;
    if (ch < 0x80) break;                                       // ASCII 结尾：完整
    else if ((ch & 0xE0) == 0xC0) need = 1;
    else if ((ch & 0xF0) == 0xE0) need = 2;
    else if ((ch & 0xF8) == 0xF0) need = 3;
    else break;                                                 // 非法引导字节：不动
    if (ncont < need) e--;                                      // 续字节不足：连同引导字节一起删
    break;
  }
  if (e != n) buf[e] = 0;
}

static void b64_append(PsaBuf& b, const uint8_t* in, size_t inlen) {
  static const char T[] = "ABCDEFGHIJKLMNOPQRSTUVWXYZabcdefghijklmnopqrstuvwxyz0123456789+/";
  size_t i = 0;
  while (i + 2 < inlen) {
    uint32_t v = (in[i] << 16) | (in[i+1] << 8) | in[i+2];
    b.put(T[(v >> 18) & 63]); b.put(T[(v >> 12) & 63]); b.put(T[(v >> 6) & 63]); b.put(T[v & 63]);
    i += 3;
  }
  if (i + 1 == inlen) {
    uint32_t v = in[i] << 16;
    b.put(T[(v >> 18) & 63]); b.put(T[(v >> 12) & 63]); b.put('='); b.put('=');
  } else if (i + 2 == inlen) {
    uint32_t v = (in[i] << 16) | (in[i+1] << 8);
    b.put(T[(v >> 18) & 63]); b.put(T[(v >> 12) & 63]); b.put(T[(v >> 6) & 63]); b.put('=');
  }
}

// ---------------- AI 请求构建 ----------------

static void img_block(PsaBuf& b, const uint8_t* data, size_t len) {
  b.put("{\"type\":\"image_url\",\"image_url\":{\"url\":\"data:image/jpeg;base64,");
  b64_append(b, data, len);
  b.put("\",\"detail\":\"medium\"}}");
}

// 屏幕像素 → 地面坐标（单应投影）由独立模块 ground_proj 负责：ground::screen_to_world。

// ============ 空间记忆辅助（全局位姿 + 物体记忆表） ============
// AI 每步执行 move/spin 后调用：按定距/定角近似累积车姿态。持续(无定距/定角)移动
// 位移未知，不改姿态（记忆会随每轮 stale++ 表不可靠）。
static void car_update_pose(const char* type, const JsonObjectConst& p) {
  if (!strcmp(type, "move")) {
    float th = p["throttle"] | 0.0f;
    int cm = p["distance_cm"] | 0;
    if (cm > 0 && fabsf(th) > 0.001f) {
      float d = cm * (th < 0 ? -1.0f : 1.0f);        // 后退反向
      float h = s_car_heading * AI_PI / 180.0f;
      s_car_x += sinf(h) * d;                        // heading=0 → 朝 Y+
      s_car_y += cosf(h) * d;
      ai::logf("[ai] 车位置(%.0f,%.0f) 车向%d°", s_car_x, s_car_y, (int)s_car_heading);
    }
  } else if (!strcmp(type, "spin")) {
    int dir = p["dir"] | 0;
    int ang = p["angle_deg"] | 0;
    if (dir != 0 && ang > 0) {
      int d = dir > 0 ? -ang : ang;                  // 右转=顺时针=heading 减小
      s_car_heading += d;
      if (s_car_heading > 180) s_car_heading -= 360;
      else if (s_car_heading < -180) s_car_heading += 360;
      ai::logf("[ai] 车向%d°", (int)s_car_heading);
    }
  }
}

// 同一物体判定：精确同名，或首字相同且长度差≤3。
static bool name_same_obj(const char* a, const char* b) {
  int la = (int)strlen(a), lb = (int)strlen(b);
  if (la == 0 || lb == 0) return false;
  if (!strcmp(a, b)) return true;
  return a[0] == b[0] && abs(la - lb) <= 3;
}
// 把一次"车头系坐标"观测写入物体记忆表：入表时立即用**观测时刻**的车位姿转成全局坐标，
// 历史观测各自已是全局坐标，融合直接取中位数。不再依赖"当前"车位姿，避免随车移动漂移。
static void mem_store(const char* name, float wx, float wy) {
  int slot = -1, oldest = 0;
  for (int i = 0; i < AI_MEM_MAX; i++) {
    if (g_mem[i].valid && g_mem[i].name[0] && name_same_obj(g_mem[i].name, name)) { slot = i; break; }
    if (!g_mem[i].valid) { slot = i; break; }
    if (g_mem[i].t_ms < g_mem[oldest].t_ms) oldest = i;
  }
  if (slot < 0) slot = oldest;                        // 满：覆盖最旧
  strncpy(g_mem[slot].name, name, 15); g_mem[slot].name[15] = 0;
  // 车头系 (wx右+, wy前+) → 全局：heading 逆时针正（左转+），前=(-sin,cos)、右=(cos,sin)
  float h = s_car_heading * AI_PI / 180.0f, ch = cosf(h), sh = sinf(h);
  float gx0 = s_car_x + wx * ch - wy * sh;
  float gy0 = s_car_y + wx * sh + wy * ch;
  // 压入本次观测（全局坐标）
  g_mem[slot].hx[g_mem[slot].hi] = gx0;
  g_mem[slot].hy[g_mem[slot].hi] = gy0;
  g_mem[slot].hi = (g_mem[slot].hi + 1) % AI_OBS_N;
  if (g_mem[slot].hn < AI_OBS_N) g_mem[slot].hn++;
  // 历史观测（已是全局）直接取中位数
  float gxl[AI_OBS_N], gyl[AI_OBS_N];
  for (int i = 0; i < g_mem[slot].hn; i++) {
    int idx = (g_mem[slot].hi - g_mem[slot].hn + i + AI_OBS_N) % AI_OBS_N;  // 最旧→最新
    gxl[i] = g_mem[slot].hx[idx];
    gyl[i] = g_mem[slot].hy[idx];
  }
  g_mem[slot].gx = median_n(gxl, g_mem[slot].hn);
  g_mem[slot].gy = median_n(gyl, g_mem[slot].hn);
  g_mem[slot].t_ms = millis();
  g_mem[slot].stale = 0;
  g_mem[slot].valid = true;
  ai::logf("[ai] 观测 %s 车头系(%.0f,%.0f) 融合n=%d → 全局(%.0f,%.0f)", name, wx, wy,
           g_mem[slot].hn, g_mem[slot].gx, g_mem[slot].gy);
}

// AI 观测（rel_deg 相对车头，正=右、负=左）：换算车头系后入表。
static void mem_observe(const char* name, bool visible, float rel_deg, float dist_cm) {
  if (!visible || !name[0] || dist_cm <= 0) {   // 未见：由 mem_tick_stale 每轮 +1
    if (name[0]) ai::logf("[ai] 观测 %s 不可见", name);
    return;
  }
  float r = rel_deg * AI_PI / 180.0f;
  mem_store(name, sinf(r) * dist_cm, cosf(r) * dist_cm);   // rel 正=右 → wx 右+
}

// AI 观测（屏幕归一化像素 px,py）：单应解算车头系坐标后入表（精度远高于目测距离）。
// 返回 false = 像素越界/解算失败，调用方应回退 rel_deg 路径。
static bool mem_observe_xy(const char* name, bool visible, float px, float py) {
  if (!visible || !name[0]) {   // 未见：由 mem_tick_stale 每轮 +1
    if (name[0]) ai::logf("[ai] 观测 %s 不可见", name);
    return true;
  }
  float wx, wy;
  if (!ground::screen_to_world(px, py, &wx, &wy)) {
    ai::logf("[ai] 观测 %s 像素(%.2f,%.2f) 越界/解算失败", name, px, py);
    return false;
  }
  mem_store(name, wx, wy);
  return true;
}

// 每轮结束：所有物体未观测则过期轮数 +1（过期不清空，仅标记）。
static void mem_tick_stale(void) {
  for (int i = 0; i < AI_MEM_MAX; i++)
    if (g_mem[i].valid) g_mem[i].stale++;
}

// 生成喂给 AI 的空间记忆文本：一律当前车头局部系（相对角度+距离），AI 零换算。
static void mem_feed(char* buf, size_t cap) {
  int n = snprintf(buf, cap, "车向:%d°", (int)s_car_heading);
  for (int i = 0; i < AI_MEM_MAX && n < (int)cap - 64; i++) {
    if (!g_mem[i].valid || g_mem[i].stale > 20) continue;   // 太久(>20轮)才不喂，避免环视中记忆过早消失
    float dx = g_mem[i].gx - s_car_x, dy = g_mem[i].gy - s_car_y;
    float dist = sqrtf(dx * dx + dy * dy);
    float thg = atan2f(dx, dy) * 180.0f / AI_PI;      // 目标方位（相对 Y+，右转正）
    int rel = (int)roundf(s_car_heading + thg);        // heading 逆时针正(左转+)；rel 正=右
    rel = (rel + 540) % 360 - 180;                     // wrap -180..180
    n += snprintf(buf + n, cap - n, "；%s %s%u°约%.0fcm",
                  g_mem[i].name, rel >= 0 ? "右偏" : "左偏", (unsigned)abs(rel), dist);
    if (g_mem[i].stale > 0)
      n += snprintf(buf + n, cap - n, "（%d轮前）", (int)g_mem[i].stale);
  }
  ai::logf("[ai] 记忆 %s", buf);   // 喂回内容同步到 ai_log，便于观察 AI 看到的物体位置理解
}

// 在物体记忆表里定位目标全局坐标：name 非空=精确/近似名匹配（找不到返回 false）；
// name 空=取当前最近的合法记忆。均跳过过期(>20轮)。
static bool mem_find(const char* name, float* tx, float* ty) {
  int best = -1; float bd = 0.0f;
  for (int i = 0; i < AI_MEM_MAX; i++) {
    if (!g_mem[i].valid || g_mem[i].stale > 20) continue;
    if (name && name[0]) {
      if (name_same_obj(g_mem[i].name, name)) { *tx = g_mem[i].gx; *ty = g_mem[i].gy; return true; }
      continue;
    }
    float dx = g_mem[i].gx - s_car_x, dy = g_mem[i].gy - s_car_y;
    float d = dx * dx + dy * dy;
    if (best < 0 || d < bd) { bd = d; best = i; }
  }
  if (name && name[0]) return false;   // 指定的名字不在记忆里
  if (best < 0) return false;          // 无任何可用记忆
  *tx = g_mem[best].gx; *ty = g_mem[best].gy;
  return true;
}

// 等待本轮定距/定角到段自停（loop 的 update_tick 会按时长停轮）；中断或超时即退出。
static void wait_wheels(unsigned long gen) {
  for (int i = 0; i < NAV_WAIT_LOOPS; i++) {
    if (gen != m_generation) return;
    if (!exec::wheels_moving()) return;
    vTaskDelay(pdMS_TO_TICKS(50));
  }
}

// 本地巡航核心（纯本地，不调云端）：把车从当前位姿导航到全局目标 (tx,ty)，距目标 ≤stop_cm 停。
// 无里程计：按定距/定角时长近似 + 姿态累积做开环死航；到位后剩余误差交给 AI 视觉微操兜底。
// 返回 Reached（到位）/ Interrupted（被新任务/手动打断）/ TimedOut（迭代超限收敛）。
enum class NavR : uint8_t { Reached, Interrupted, TimedOut };
static NavR navigate_to(unsigned long gen, float tx, float ty, float stop_cm) {
  const float throttle = 0.5f;   // 巡航推进油门（中速）
  for (int it = 0; it < NAV_MAX_ITERS; it++) {
    if (gen != m_generation) return NavR::Interrupted;
    float dx = tx - s_car_x, dy = ty - s_car_y;
    float dist = sqrtf(dx * dx + dy * dy);
    if (dist <= stop_cm) { JsonDocument s(&g_js_alloc); s["scope"] = "all"; exec::act("stop", s.as<JsonObjectConst>()); return NavR::Reached; }
    float thg = atan2f(dx, dy) * 180.0f / AI_PI;        // 目标全局方位（heading=0 时朝 Y+）
    float rel = wrap180f(s_car_heading + thg);          // 目标相对车头偏角，正=右
    if (fabsf(rel) > NAV_ALIGN_DEG) {                   // 偏太多先原地转向对齐
      int ang = (int)fminf(fabsf(rel), (float)NAV_MAX_SPIN_DEG);
      JsonDocument p(&g_js_alloc); p["dir"] = rel > 0 ? 1 : -1; p["speed"] = 850; p["angle_deg"] = ang;
      exec::act("spin", p.as<JsonObjectConst>()); car_update_pose("spin", p.as<JsonObjectConst>());
      wait_wheels(gen);
    } else {                                            // 否则定距直行一段（分步收敛）
      float seg = fminf(dist - stop_cm, (float)NAV_MAX_SEG_CM);
      if (seg < 1.0f) seg = 1.0f;
      JsonDocument p(&g_js_alloc); p["throttle"] = throttle; p["steering"] = 0; p["distance_cm"] = (int)seg;
      exec::act("move", p.as<JsonObjectConst>()); car_update_pose("move", p.as<JsonObjectConst>());
      wait_wheels(gen);
    }
  }
  JsonDocument s(&g_js_alloc); s["scope"] = "all"; exec::act("stop", s.as<JsonObjectConst>());   // 迭代超限：停稳收敛
  return NavR::TimedOut;
}

// 构建请求 body 的结构说明：
// goal 当前任务目标（可被插话/ task_goal 热替换）；hrole/htext/hn = 历史环条目（角色+文本，
// 同时含 assistant=AI 决策 与 user=插话），逐条作为独立消息回喂，构成真多轮对话记录；
// exec_state 执行板状态一行文本（无数据为空串）及"距上次执行"秒数喂当前 user。
// 系统提示词？（角色+规则+JSON格式+标定，不含目标）+ 独立 user(目标) 消息先组进 PSRAM。
// 图预算 ≤2：carry_prev 双帧优先（放弃参考图），否则 参考图(首轮)+当前帧。
static void build_body(PsaBuf& b, const char* goal, const char* ann, const char* hint,
                       const char* const* hrole, const char* const* htext, int hn,
                       const char* exec_state, unsigned last_age_s,
                       const char* note, const char* prog,
                       const uint8_t* frame, size_t frame_len,
                       const uint8_t* prev, size_t prev_len,
                       bool use_prev, bool use_edited, const uint8_t* edited, size_t edited_len) {
  PsaBuf sys;
  sys.put("你是「小车+机械臂」视觉控制大脑。画面中若有红色标注（方框/圆圈）需根据要求优先遵循。");
  sys.put("每次只输出一个合法 JSON：");
  sys.put("{\"type\":\"move\",\"params\":{\"throttle\":0.3,\"steering\":0,\"distance_cm\":30},\"reason\":\"..\"} 移动/转向：离目标距离明确时务必加 distance_cm 定距，幅度宜小防过冲；低速优先 throttle/steering≤0.5；");
  sys.put("或 {\"type\":\"spin\",\"params\":{\"dir\":1,\"angle_deg\":90},\"reason\":\"..\"} 原地旋转(dir: +1右转(顺时针)/-1左转(逆时针)/0停)：保持车头朝向不变原地转动视角，是观察环境/环视四周的推荐转弯方式，须配合前轮保持直行；可选 angle_deg 定角转指定度数，小幅微调或转够观察角度用；");
  sys.put("或 {\"type\":\"arm\",\"params\":{\"act\":\"lift_up\",\"dist_cm\":15},\"reason\":\"..\"} act 取 lift_up/lift_down/reach_forward/reach_backward/clip/release/home（home=收臂折叠回平台，避免遮挡小型物体）");
  sys.put("或 {\"type\":\"arm_pose\",\"params\":{\"x\":10,\"h\":4},\"reason\":\"..\"} 直接把夹爪末端移动到指定位姿：x=车头前方 cm（可达约4..15），h=夹爪中心离地高度 cm（越高夹爪越抬、越低越贴近地面）。夹取前最推荐用它把夹爪调到与目标高度匹配；不可达时不会移动，请改 x/h 重试；");
  sys.put("或 {\"type\":\"stop\",\"params\":{\"scope\":\"all\"},\"reason\":\"..\",\"done\":true} 立即停车并结束当前任务：任务完成/目标达成/需完全收手时带 done:true；仅临时停车继续观察则不带 done：");
  sys.put("或 {\"type\":\"wait\",\"reason\":\"..\"} 空操作，用于不执行移动操作跳过本轮，不会停止正在进行的移动；");
  sys.put("或 {\"type\":\"approach\",\"params\":{\"target\":\"对象名或空\"},\"reason\":\"..\"} 自动靠近已锁定目标到约15cm再交还你微操：target=已用 observe 记下的对象名（空=就近目标）；只有确定记忆里那物且需长距离直行时才用，否则仍用 move/spin 自行逼近；目标不在记忆里时不要用，先 observe 或直接靠近；");
  sys.put("可选附加字段（可加在任意指令 JSON 里）：\"carry_prev\":true（下轮带上本帧做前后对比，用于锁定/追踪）；\"task_goal\":\"新目标文字\"（把插话/新意图提升为当前任务目标，程序会把该文字更新到目标位置并每轮喂回）；\"observe\":{\"name\":\"物体名字\",\"px\":0.36,\"py\":0.62,\"visible\":true} 记录物体位置：name=物体名（同一物体务必保持同名），px/py=物体在画面上的归一化坐标 左上(0,0)右下(1,1)，visible=false=当前不在画面；优先用 px/py（坐标口径见规则12），无法给出像素时用 \"rel_deg\":-20,\"dist_cm\":25 兜底；\"task_note\":\"目标外观/备注\"（任务开始写一次，程序每轮喂回）；\"tasks\":[{\"name\":\"出门\",\"done\":true},{\"name\":\"右转\",\"done\":false}]（新建/重写整个任务列表，低频）；\"task_done\":{\"index\":1,\"done\":true}（标记第N项完成/未完成，index从1起，高频轻量、不用重写列表）；");
  sys.put("规则: \
	1. 只输出 JSON, 每次只规划一步，若任务不要求实际行动可以 stop; 回复务必简短——思考放在 reason。\
	2. reason 一句中文简要解释, 需包含目标方位: 相对小车的左/中/右 + 是否已贴近/被夹爪遮挡; 若目标消失, 写明最后已知方位与推断(如“最后在偏左处, 现在应在车头右前方, 右转找回”), 供下轮决定转向或后退, 避免走过头后盲目环视。\
	3. 旋转时使用 原地旋转(spin) ，需要观察环境/还没锁定目标时优先用小幅环视探索视角。\
	4. 若有障碍物挡路或有明显高低差的区域则尝试绕行，若绕行多轮仍无进展或人持续挡在车前, 做出示意停止的手势，则可以 stop 并说明原因。\
	5. 记录物体位置用 observe (格式见上方指令区): 同一物体务必保持同名, 看到就刷新、看不到报 visible=fals; 记忆仅供参考, 画面所见永远为准——画面与记忆不符说明物体被移动或车已转向, 一律以画面为准更新。目标不在画面时, 用记忆里的位置结合当前车向推断方位。\
	6. 目标先前可见且在近处、随后画面中消失(尤其上一步是前进靠近)。可以尝试回退操作或根据空间记忆转向找回目标，若空间记忆推断目标方位十分接近, 可能被阻挡，则应选择先前的移动，确认方位后再靠近。当确认目标被机械臂本体遮挡可用 收臂 home。\
	7. 画面右下角为小车的夹爪，其朝向为小车朝向。状态里“抓手:前Xcm 高Ycm”是夹爪中心与离地高度, 画面不好判断时据此判断能否夹住及抓手高度是否合适; 继续朝受限方向动作不再改变位置时(到顶/缩到底), 应换方向或调整姿态。\
	8. 发现目标在左前方/右前方时, 先原地转向对准目标, 正对目标且距离小于10时可以尝试使用arm_pose控制夹子移动到目标距离和高度尝试夹取, 高度应选择目标高度的一半或者明显适合夹取的高度, 无法确认合适高度时选择较低的高度, 夹爪松开时宽度3cm, 可以用来大致推测长度\
	9. 夹爪是两片平行夹板, 装机在高位侧俯视时可看到夹爪; “爪:合”只代表夹爪伺服已闭合到位, 绝不代表夹住了物体。判断是否夹住必须执行 arm lift_up 抬臂, 检查目标是否随夹爪抬起; 目标仍在地面或夹爪空合则未夹住, 应 release 后调整高度或重新对准。\
	10. 需要下一轮同时收到本轮画面做前后对比时，输出额外字段 \"carry_prev\":true。例如发现目标、或即将移动担心目标进盲区需要对比判定时。下轮你会同时收到上一帧与当前帧, 据此判断目标是否移动/进入盲区。\
	11. 多步任务用 tasks 新建/重写任务列表、task_done 标记第N项完成(index从1起, 完成后及时标记, 不必重写列表); task_note 记录目标外观/备注（低频）。程序每轮喂回当前任务列表与笔记, 据此推进下一步即可, 勿重复推断进度。若操作者插话构成新任务/需改目标，用 task_goal 更新当前任务目标即可。\
	12. 坐标系与距离口径(统一约定, 沿用此说法):以小车为基准, 前方=画面中心方向、屏幕越往下越近、右/左=小车右/左; observe 的 px/py 由程序换算成车头局部系喂回（形如\"车向:35°; 沙漏 右偏20°约25cm\", 车向 0°=任务开始车头方向、右正左负; 无像素时 rel_deg 兜底), 你只需相对小车判断方位、距离以程序喂回值为准。该标定只在目标与小车同处水平地面时成立, 若目标与小车不在同一水平地面, 勿依靠此功能。近距夹取时夹爪高低以抓手状态为准。");

  b.put("{\"model\":");
  esc_append(b, cfg::ai_model().c_str());
  b.put(",\"messages\":[{\"role\":\"system\",\"content\":");
  esc_append(b, sys.p ? sys.p : "");
  // user(目标)：独立持久消息；目标被 task_goal 热替换时只换这条、不碰 system（保前缀缓存）
  b.put("},{\"role\":\"user\",\"content\":");
  {
    PsaBuf gt;
    gt.put("任务目标："); gt.put(goal ? goal : "");
    if (ann && ann[0]) { gt.put("（操作者标注："); gt.put(ann); gt.put("）"); }
    esc_append(b, gt.p ? gt.p : "");
  }
  b.put("}");
  // 历史环：逐条独立消息（assistant=自己之前的决策 / user=操作者插话），构成真多轮对话记录。
  // 角色交替保护：若末条是 user 插话，把它并入当前 user 文本，避免"连续两条 user"被严格端点拒。
  const char* merge_tail = (hn > 0 && !strcmp(hrole[hn - 1], "user")) ? htext[hn - 1] : nullptr;
  int hn_out = merge_tail ? hn - 1 : hn;
  for (int i = 0; i < hn_out; i++) {
    b.put(",{\"role\":");
    esc_append(b, hrole[i]);
    b.put(",\"content\":");
    esc_append(b, htext[i]);
    b.put("}");
  }
  // 当前 user：状态 + 画面（整体转义一次），作为本轮模型的输入
  b.put(",{\"role\":\"user\",\"content\":[{\"type\":\"text\",\"text\":");
  PsaBuf ut;
  if (exec_state && exec_state[0]) { ut.put(exec_state); ut.put("；"); }
  if (last_age_s > 0) {
    char age[32]; snprintf(age, sizeof(age), "上一指令约%us前执行；", last_age_s);
    ut.put(age);
  }
  if (merge_tail) { ut.put("（操作者前一条插话：" ); ut.put(merge_tail); ut.put("）"); }
  // 任务笔记/任务列表：AI 自己写入并持续喂回（目标外观/计划/各任务状态），无需每轮重新推断。
  if (note && note[0]) { ut.put("任务笔记："); ut.put(note); ut.put("；"); }
  if (prog && prog[0]) { ut.put(prog); ut.put("；"); }  // prog 为已渲染的"任务列表：..."文本
  if (hint && hint[0]) { ut.put("注意："); ut.put(hint); ut.put("。"); }
  { // 空间记忆喂回（车向 + 已记物体，当前车头局部系）
    char mem_s[192];
    mem_feed(mem_s, sizeof(mem_s));
    if (mem_s[0]) { ut.put(mem_s); ut.put("；"); }
  }
  if (frame) {
    if (use_prev && prev && prev_len > 0) {
      ut.put("下面按顺序给出：上一帧、当前帧。请对比两帧，判断画面中移动的人手/物体大致朝哪个方向移动；若上一步动作已让目标消失，据两帧差异推断目标方位与盲区。");
    } else if (use_edited && edited) {
      ut.put("下面按顺序给出：操作者参考图、当前帧。参考图用于辨识目标外观/位置，请在当前帧中寻找匹配的目标。");
    } else {
      ut.put("当前画面如下：");
    }
  } else {
    // 无摄像头降级：不让 AI 编造画面，只凭目标与状态规划保守指令
    ut.put("注意：摄像头不可用，当前无实时画面可分析，请勿假设或编造画面内容。只依据上述目标与执行板状态，稳妥地规划一步指令（优先短距离 move 或直接 stop）。");
  }
  esc_append(b, ut.p ? ut.p : "");
  b.put("}");
  if (frame) {
    // 图片块间需逗号分隔；首个（text 之后）不加。修 multi-image 缺逗号导致的 400。
    b.put(",");
    bool first = true;
    auto img = [&](const uint8_t* d, size_t n) {
      if (!first) b.put(',');
      img_block(b, d, n);
      first = false;
    };
    // 图预算 ≤2：carry_prev 双帧优先（此时放弃参考图）；否则 参考图(首轮)+当前帧
    if (use_prev && prev && prev_len > 0) img(prev, prev_len);
    else if (use_edited && edited) img(edited, edited_len);
    img(frame, frame_len);
  }
  b.put("]}],\"temperature\":0.3,\"max_tokens\":8192,\"reasoning_effort\":\"low\",\"response_format\":{\"type\":\"json_object\"}}");
}

// 指令短描述（供"上一步已下发"拼接与死循环判定；含运动数值，便于识别"相同指令"）。
static void fmt_last(char* buf, size_t cap, const char* type, const JsonObjectConst& p) {
  if (!strcmp(type, "move")) {
    float th = p["throttle"] | 0.0f;
    float st = p["steering"] | 0.0f;
    int dc = p["distance_cm"] | 0;
    int ad = p["angle_deg"] | 0;
    if (dc) snprintf(buf, cap, "move %dcm th=%.1f", dc, th);
    else if (ad) snprintf(buf, cap, "move %d度 th=%.1f", ad, th);
    else snprintf(buf, cap, "move 持续 th=%.1f st=%.1f", th, st);
  } else if (!strcmp(type, "arm")) {
    const char* act = p["act"] | "";
    int pd = p["dist_cm"] | 0;
    if (pd) snprintf(buf, cap, "arm %s %dcm", act, pd);
    else snprintf(buf, cap, "arm %s 持续", act);
  } else if (!strcmp(type, "arm_pose")) {
    float px = p["x"] | 0.0f;
    float ph = p["h"] | 0.0f;
    snprintf(buf, cap, "arm_pose x=%.0f h=%.0f", px, ph);
  } else if (!strcmp(type, "spin")) {
    int dd = p["dir"] | 0;
    snprintf(buf, cap, "spin %d", dd);
  } else {
    snprintf(buf, cap, "stop");
  }
}

// ---------------- 输出校验（防误动作） ----------------
// 校验并规范化 AI 输出到 out{type,params,reason}。返回 nullptr 通过；否则返回错误字符串。
static const char* validate_cmd(const char* content, JsonDocument& out, char* err_buf, size_t err_cap) {
  // 剥代码块/首尾空白（Arduino String 无 find/left，用 indexOf/substring）
  String c = content;
  c.trim();
  if (c.startsWith("```")) {
    int e = c.indexOf('\n');
    if (e >= 0) c = c.substring(e + 1);
    c.trim();
    if (c.endsWith("```")) c = c.substring(0, c.length() - 3);
    c.trim();
  }

  JsonDocument doc(&g_js_alloc);  // PSRAM 池，避免内部堆碎片
  if (deserializeJson(doc, c)) {
    snprintf(err_buf, err_cap, "AI 返回非 JSON：%s", c.substring(0, 80).c_str());
    return err_buf;
  }
  const char* type = doc["type"] | "";
  if (strcmp(type, "move") && strcmp(type, "stop") && strcmp(type, "arm") &&
      strcmp(type, "wait") && strcmp(type, "spin") && strcmp(type, "arm_pose") &&
      strcmp(type, "approach")) {
    return "AI 输出非法 type";
  }
  if (!doc["params"].is<JsonObject>() && strcmp(type, "stop") && strcmp(type, "wait") &&
      strcmp(type, "approach")) {
    return "AI 输出缺 params";
  }
  if (!strcmp(type, "arm")) {
    const char* act = doc["params"]["act"] | "";
    static const char* acts[] = {"lift_up","lift_down","reach_forward","reach_backward","clip","release","fold", nullptr};
    bool good = false;
    for (int i = 0; acts[i]; i++) if (!strcmp(act, acts[i])) { good = true; break; }
    if (!good) { snprintf(err_buf, err_cap, "AI arm 非法 act=%s", act); return err_buf; }
  }

  out["type"] = type;
  JsonObject p = out["params"].to<JsonObject>();
  if (doc["params"].is<JsonObject>()) {
    JsonVariantConst src = doc["params"];
    // 数值钳制
    float th = doc["params"]["throttle"] | 0.0f;
    float st = doc["params"]["steering"] | 0.0f;
    p["throttle"] = constrain(th, -1.0f, 1.0f);
    p["steering"] = constrain(st, -1.0f, 1.0f);
    int dc = doc["params"]["distance_cm"] | 0;
    int ad = doc["params"]["angle_deg"] | 0;
    int pd = doc["params"]["dist_cm"] | 0;
    if (src["distance_cm"].is<int>() && dc) p["distance_cm"] = constrain(dc, 0, 500);
    if (src["angle_deg"].is<int>() && ad) p["angle_deg"] = constrain(ad, 0, 500);
    if (src["dist_cm"].is<int>() && pd) p["dist_cm"] = constrain(pd, 0, 500);
    int sd = doc["params"]["dir"] | 0;
    int ss = doc["params"]["speed"] | 900;  // 原地旋转默认转速（实测 <700 拖不动，须给足）
    int sa = doc["params"]["angle_deg"] | 0;
    p["dir"] = constrain(sd, -1, 1);     // 原地旋转方向：±1/0
    p["speed"] = constrain(ss, 0, 1000); // 原地旋转单轮 pwm
    if (src["angle_deg"].is<int>() && sa) p["angle_deg"] = constrain(sa, 0, 500); // 定角微操
    const char* act = doc["params"]["act"] | "";
    if (act[0]) p["act"] = act;
    const char* scope = doc["params"]["scope"] | "all";
    p["scope"] = !strcmp(scope, "wheels") ? "wheels" : (!strcmp(scope, "arm") ? "arm" : "all");
    // arm_pose 指定位姿：x=轴前方 cm（可达 4..15），h=夹爪中心离地高度 cm。arm_pose 内部还有可达域检查。
    float px = doc["params"]["x"] | 0.0f;
    float ph = doc["params"]["h"] | 0.0f;
    if (src["x"].is<float>() || src["x"].is<int>()) p["x"] = constrain(px, 0.0f, 20.0f);
    if (src["h"].is<float>() || src["h"].is<int>()) p["h"] = constrain(ph, -2.0f, 25.0f);
    const char* tgt = doc["params"]["target"] | "";
    if (tgt[0]) p["target"] = tgt;
  }
  const char* reason = doc["reason"] | "";
  if (reason[0]) out["reason"] = reason;
  const char* tg = doc["task_goal"] | "";
  if (tg[0]) out["task_goal"] = tg;   // 选项：把插话/新意图提升为当前任务目标（AI 显式标记）
  if (doc["done"].is<bool>() && doc["done"].as<bool>()) out["done"] = true;  // 任务完结标记
  // carry_prev:true = 下一轮希望同时收到本轮画面做对比（目标锁定/追踪、判断移动后目标方位）。
  // 本字段不进 params，仅作 worker 决策是否带 prev 的信号。
  if (doc["carry_prev"].is<bool>() && doc["carry_prev"].as<bool>()) out["carry_prev"] = true;
  // observe:true = AI 的空间观测（name/rel_deg/dist_cm/visible），透传给 worker 更新物体记忆表。
  if (doc["observe"].is<JsonObject>()) out["observe"] = doc["observe"].as<JsonObjectConst>();
  return nullptr;
}

// ---------------- HTTPS POST（keep-alive 复用连接） ----------------
// 直接走 TLS socket 裸写 HTTP/1.1，绕开 HTTPClient 库——其 cookie/Date 解析
// 会引入 libc time/gmtime/mktime/strptime 等函数（被链接脚本强制放 IRAM，
// 实测导致 iram0 溢出）。DeepSeek 边缘响应为 chunked（无 Content-Length），
// 见下方按 CL / chunked 两种分支读取。
// 连接策略：同一 host 复用 TLS 连接（Connection: keep-alive），省掉每轮 ~500ms
// 握手；复用连接被服务端空闲断开/半开时，http_post 检测后重建一次立即重发。
// 响应按块严格消费（chunked 终止块后吞 trailer 到空行），保证流干净可复用。

#if 0  // 手写传输层已废弃：其 chunked 投机容错曾把响应体读错位成散文。改用 HTTPClient（见 http_post）。
// 单次请求-响应交换（连接须已就绪）。成功返回 true 且保持连接供下次复用；
// 任何协议/IO 异常返回 false（http_post 决定重建或弃连）。
static bool http_exchange(const String& host_s, const char* key, const char* path_s,
                          const char* body, String& resp, bool* reusable) {
  resp = "";
  *reusable = true;   // 默认可复用；响应头明确 Connection: close 则置 false（下轮直接新建）
  g_last_status = 0;  // 每次交换重置，避免沿用上次状态
  g_client.printf("POST %s HTTP/1.1\r\n", path_s);
  g_client.printf("Host: %s\r\n", host_s.c_str());
  g_client.printf("Authorization: Bearer %s\r\n", key);
  g_client.print("Content-Type: application/json\r\n");
  g_client.print("Accept: application/json\r\n");
  g_client.print("User-Agent: VisionS3/1.0\r\n");
  g_client.printf("Content-Length: %d\r\n", (int)strlen(body));
  g_client.print("Connection: keep-alive\r\n\r\n");

  // 诊断：body 可能达数十 KB，一次 write 成败难定位。分段发，打印每段进度与耗时。
  size_t blen = strlen(body);
  ai::logf("[ai] body %u B", (unsigned)blen);
  const uint8_t* bp = (const uint8_t*)body;
  const size_t SEG = 4096;
  size_t sent = 0;
  unsigned long t_start = millis();
  size_t seg = 0;
  unsigned long t_last_write = millis();  // 连续无进展起点（防复用死连接傻等 30s）
  while (sent < blen) {
    size_t n = (blen - sent < SEG) ? (blen - sent) : SEG;
    unsigned long ts = millis();
    size_t w = g_client.write(bp + sent, n);
    unsigned long dt = millis() - ts;
    if (w > 0) { seg++; sent += w; t_last_write = millis(); if (dt > 100) blog::logf(blog::AI, "seg %u sent=%u ~%u ms", seg, (unsigned)sent, (unsigned)dt); continue; }
    // 返回 0 或负：发送卡住/失败。连续 3s 无进展即视为连接已死，弃连让上层重建。
    if (millis() - t_last_write > 3000) {
      blog::logf(blog::AI, "发送停滞 sent=%u/%u，弃连", (unsigned)sent, (unsigned)blen);
      return false;
    }
    if (millis() - t_start > AI_HTTP_TIMEOUT_MS) break;
    delay(10);
  }
  ai::logf("[ai] body 发送完成 %u/%u ~%u ms", (unsigned)sent, (unsigned)blen,
                (unsigned)(millis() - t_start));
  if (sent < blen) return false;

  // 读响应头（上限 4KB；复用连接被服务端关闭时 connected()=false，快速失败）
  String hdr;
  unsigned long t0 = millis();
  while (hdr.length() < 4096 && millis() - t0 < AI_HTTP_TIMEOUT_MS) {
    while (g_client.available()) {
      int c = g_client.read();
      if (c < 0) break;
      hdr += (char)c;
      if (hdr.endsWith("\r\n\r\n")) break;
    }
    if (hdr.endsWith("\r\n\r\n")) break;
    if (!g_client.connected()) { ai::logf("[ai] 响应头读取中连接关闭（云端主动断开）"); return false; }
    delay(5);
  }
  if (!hdr.endsWith("\r\n\r\n")) { ai::logf("[ai] HTTP 响应头超时/不完整"); return false; }
  // 去掉状态行前残留的空白（前一响应/复用连接遗留的换行），保证 startsWith 判断准确
  while (hdr.length() > 0 && (hdr[0] == '\r' || hdr[0] == '\n')) hdr = hdr.substring(1);
  // 记录状态码，供上层 4xx 快速失败（400 重试无意义）
  int st_sp = hdr.indexOf(' ');
  if (st_sp >= 0 && hdr.length() >= st_sp + 4) g_last_status = hdr.substring(st_sp + 1, st_sp + 4).toInt();
  // 服务端明确 Connection: close（大小写不敏感）：本连接不可复用，下轮直接新建
  String hlc = hdr; hlc.toLowerCase();
  if (hlc.indexOf("connection: close") >= 0) *reusable = false;
  // 提前解析 Content-Length / 传输编码 / 内容类型，按实际帧格式读取响应体
  int cl = 0;
  int idx = hdr.indexOf("Content-Length:");
  if (idx >= 0) { String v = hdr.substring(idx + 15); v.trim(); cl = v.toInt(); }
  bool chunked = hlc.indexOf("transfer-encoding: chunked") >= 0;
  bool sse = hlc.indexOf("content-type: text/event-stream") >= 0;
  if (!hdr.startsWith("HTTP/1.1 200") && !hdr.startsWith("HTTP/1.0 200")) {
    // 非 2xx：把状态行与错误响应体（前 100B）推到手机，便于定位 429 限流 / 400 参数等
    String errbody;
    int want = cl > 0 ? (cl < 512 ? cl : 512) : 0;
    long te = millis();
    while (want > 0 && (int)errbody.length() < want && millis() - te < 2000) {
      while (want > 0 && g_client.available() && (int)errbody.length() < want) errbody += (char)g_client.read();
      delay(3);
    }
    int cr = hdr.indexOf('\r');
    String status = cr > 0 ? hdr.substring(0, cr) : hdr;
    ai::logf("[ai] HTTP 非200 %s 响应体:%.100s", status.c_str(), errbody.c_str());
    blog::logf(blog::AI, "HTTP %s body=%s", hdr.c_str(), errbody.c_str());
    return false;
  }
  // 响应体用 PsaBuf（PSRAM）累积，避免逐字符 String grow 在内部堆反复 realloc 制造碎片。
  PsaBuf pb;
  if (cl > 0) {
    unsigned long tr = millis();
    while ((int)pb.len < cl && millis() - tr < AI_HTTP_TIMEOUT_MS) {
      while (g_client.available() && (int)pb.len < cl) {
        int c = g_client.read();
        if (c < 0) break;
        pb.put((char)c);
      }
      if ((int)pb.len >= cl) break;
      if (!g_client.connected()) break;  // 服务端提前关连接
      delay(5);
    }
    if ((int)pb.len < cl) { blog::logf(blog::AI, "HTTP body 未读完 got=%d cl=%d", (int)pb.len, cl); return false; }
  } else if (chunked) {
    // chunked 解码（严格、无投机）：每个字节/行按独立空闲超时读取，逐字节精确计数。
    // 上一版用「全局 30s 时钟 + 块尾字节压回(pend) + size 行前向重同步」做容错，但这些
    // 投机在大响应慢流时会误读块边界——只吞到半截 size 行、按错误块长读取，导致响应体被
    // 裁剪/错位成散文（`{"id":xxx` 后接错位文本），deserializeJson 必然失败。这里改为：
    // 严格按块边界逐字节计数，块尾必须 \r\n（或 \n），任何不完整一律判失败并返回 false，
    // 由上层丢弃该连接、换新连接重试。宁可多次失败重试，也绝不再产出错位响应体。
    const unsigned long idle_ms = 2500;   // 单个读操作空闲超时：无新字节即判断流
    auto read_byte_idle = [&]() -> int {
      unsigned long t0 = millis();
      while (millis() - t0 < idle_ms) {
        if (g_client.available() > 0) { int c = g_client.read(); if (c >= 0) return c; }
        if (!g_client.connected()) return -1;
        delay(1);
      }
      return -1;
    };
    // 读一行（忽略 \r，遇 \n 停并消费）。返回 0=正常、-1=超时/断流；超时绝不返回半截。
    auto read_line_strict = [&](String& out, size_t cap) -> int {
      out = "";
      for (;;) {
        int c = read_byte_idle();
        if (c < 0) return -1;
        if (c == '\r') continue;
        if (c == '\n') return 0;
        if (out.length() < cap) out += (char)c;
      }
    };
    // 严格十六进制 chunk-size 解析（支持 ";ext" 扩展与首尾空白；垃圾行直接报错）
    auto parse_size = [](String line, int* out) -> bool {
      line.trim();
      int semi = line.indexOf(';');          // chunk 扩展：忽略其后内容
      if (semi >= 0) line = line.substring(0, semi);
      if (line.length() == 0 || line.length() > 8) return false;
      long v = 0;
      for (int i = 0; i < (int)line.length(); i++) {
        char c = line[i];
        int d;
        if (c >= '0' && c <= '9') d = c - '0';
        else if (c >= 'a' && c <= 'f') d = c - 'a' + 10;
        else if (c >= 'A' && c <= 'F') d = c - 'A' + 10;
        else return false;
        v = (v << 4) | d;
      }
      *out = (int)v;
      return true;
    };
    for (;;) {                        // 循环解析各块
      String line;
      if (read_line_strict(line, 64) < 0) { blog::logf(blog::AI, "chunked size 行读取失败"); return false; }
      int sz = 0;
      if (!parse_size(line, &sz)) {
        blog::logf(blog::AI, "chunked size 行异常: '%.32s'", line.c_str());
        return false;
      }
      if (sz == 0) {
        // 终止块 0：吞 trailer 到空行（单请求后即重建连接，清不清流都无碍）
        for (;;) { String t; if (read_line_strict(t, 256) < 0) break; if (t.length() == 0) break; }
        break;
      }
      if (sz < 0 || sz > 262144) { blog::logf(blog::AI, "chunked 块过大"); return false; }
      for (int i = 0; i < sz; i++) {        // 逐字节精确读块数据，缺一字节即失败
        int c = read_byte_idle();
        if (c < 0) { blog::logf(blog::AI, "HTTP chunked 中断 got=%d", (int)pb.len); return false; }
        pb.put((char)c);
      }
      // 块尾：严格 \r\n（或仅 \n）。不完整即失败，不猜字节、不压回。
      int t1 = read_byte_idle();
      if (t1 < 0) { blog::logf(blog::AI, "chunked 块尾缺失"); return false; }
      if (t1 == '\r') {
        int t2 = read_byte_idle();
        if (t2 < 0 || t2 != '\n') { blog::logf(blog::AI, "chunked 块尾缺失"); return false; }
      } else if (t1 != '\n') {
        blog::logf(blog::AI, "chunked 块尾错位"); return false;
      }
    }
    ai::logf("[ai] HTTP chunked 解码 %d B", (int)pb.len);
  } else if (sse) {
    // SSE（text/event-stream，未走 chunked 帧）：按行读，累积 data: 负载；
    // [DONE] 事件或连接关闭即结束。产物为拼接后的 JSON 文本，交 extract_content 解析。
    unsigned long ts2 = millis();
    String ln;
    bool sse_end = false;
    while (!sse_end && millis() - ts2 < AI_HTTP_TIMEOUT_MS && g_client.connected()) {
      while (g_client.available() && !sse_end) {
        int c = g_client.read();
        if (c < 0) break;
        if (c == '\n') {
          String d = ln; ln = "";
          d.trim();
          if (d.startsWith("data:")) {
            String payload = d.substring(5); payload.trim();
            if (payload == "[DONE]") { sse_end = true; break; }
            pb.put(payload.c_str());
            pb.put('\n');   // 多条 data 负载间保留换行，便于 JSON 拼接/调试
          }
        } else if (c != '\r') {
          ln += (char)c;
        }
      }
      if (!g_client.connected()) break;
      delay(2);
    }
    ai::logf("[ai] SSE 解码 %d B", (int)pb.len);
  } else {
    // 无 CL、无 chunked、无 SSE：裸读直到连接关闭或超时（10s 封顶），尽量救回响应体。
    unsigned long tr3 = millis();
    while (millis() - tr3 < 10000) {
      while (g_client.available()) {
        int c = g_client.read();
        if (c < 0) break;
        pb.put((char)c);
      }
      if (!g_client.connected()) break;
      delay(5);
    }
    blog::logf(blog::AI, "原始读取 %d B", (int)pb.len);
  }
  resp = pb.p ? pb.p : "";
  return pb.len > 0;
}
#endif  // http_exchange 已废弃，改用 HTTPClient

// 手动读取 chunked 响应体。HTTPClient 的 chunked 解码在 TLS 明文空窗期（响应跨多个 TCP 段、
// 段间隙数据未到）会因 readBytes 遇 read()==-1 立即判死 → READ_TIMEOUT → 断连，实测正文只
// 剩一个 TCP 段（1448B）被截断。这里改用"读不到就短延时重试"直到超时/连接关闭，根除截断。
static bool read_chunked_body(WiFiClientSecure& c, String& body, unsigned long timeout_ms) {
  unsigned long t0 = millis();
  auto rd = [&]() -> int {                    // 读 1 字节；无明文则等待（-1 = 超时/断连）
    while (millis() - t0 < timeout_ms) {
      if (c.available()) {
        int b = c.read();
        if (b >= 0) return b;
      }
      if (!c.connected()) return -1;
      delay(2);
    }
    return -1;
  };
  for (;;) {
    String hdr;                               // chunk size 行（可能带 ";扩展"）
    int ch;
    while ((ch = rd()) >= 0 && ch != '\n') hdr += (char)ch;
    if (ch < 0) return false;
    hdr.trim();
    long sz = strtol(hdr.c_str(), nullptr, 16);
    if (sz <= 0) return true;                 // 末块；忽略可能存在的 trailer
    for (long i = 0; i < sz; i++) {
      ch = rd();
      if (ch < 0) return false;
      body += (char)ch;
    }
    if (rd() < 0 || rd() < 0) return false;   // 块尾 \r\n
  }
}

static bool http_post(const char* url, const char* key, const char* body, String& resp,
                      unsigned long gen) {
  (void)gen;  // 代际/中断判断由调用方（worker 循环）负责；cancel 走 g_client.stop()
  g_last_status = 0;  // 入口重置，避免沿用上一轮 4xx/429 误判
//   ai::logf("[ai] TLS前 freeHeap=%u maxBlock=%u freePsram=%u",
//            ESP.getFreeHeap(), ESP.getMaxAllocHeap(), ESP.getFreePsram());
  unsigned long t0 = millis();
  // 连接策略：尽量复用同一条 TLS 连接（省握手、降延迟）。复用的风险是上一次成功响应在
  // ssl_ctx/HTTPClient 留下未读尽的残留，或连接在决策间隙被服务端/半开关掉，导致下一次
  // mbedtls_ssl_write 报 -0x7100 BAD_INPUT_DATA（→-3）。处理：pass0 直接复用当前 g_client；
  // 一旦发送失败立刻 stop 掉，pass1 用全新握手重发同一 body（只多这一轮），把多轮 -3 阵发
  // 收敛成"一次复用失败 + 一次新握手成功"。success 时保留连接供下轮复用。
  static bool s_tls_cfg = false;
  if (!s_tls_cfg) {
    g_client.setInsecure();                 // 开发期信任自签；上线建议改 CA 校验
    g_client.setConnectionTimeout(AI_CONNECT_TIMEOUT_MS);
    g_client.setTimeout(AI_HTTP_TIMEOUT_MS);
    s_tls_cfg = true;
  }
  for (int pass = 0; pass < 2; pass++) {
    resp = "";                                              // 清残留：失败重试时防上次部分字节叠加
    if (pass == 1 && g_client.connected()) { g_client.stop(); }  // 复用失败：彻底断开，全新握手
    HTTPClient http;
    http.setReuse(true);                    // 成功即保留连接供下轮复用
    http.collectAllHeaders(true);           // 保存响应头，供判断 Transfer-Encoding（默认不收集）
    if (!http.begin(g_client, url)) { blog::logf(blog::AI, "HTTPClient begin 失败"); return false; }
    http.addHeader("Content-Type", "application/json");
    http.addHeader("Authorization", String("Bearer ") + String(key));
    int code = http.POST(body);             // body 为 PSRAM C 串；流式发送、不整体拷内部堆
    g_last_status = code;
    // ai::logf("[ai] POST 完成 code=%d ~%u ms rssi=%d", code, (unsigned)(millis() - t0), (int)WiFi.RSSI());
    if (code <= 0) {
      ai::logf("[ai] HTTP POST 失败 code=%d pass%d rssi=%d", code, pass + 1, (int)WiFi.RSSI());
      if (pass == 0) { g_client.stop(); http.end(); continue; }   // 复用失败：断开，pass1 全新握手
      g_client.stop(); http.end();
      return false;
    }
    if (code != 200) {
      String eb = http.getString();
      if (eb.length() > 128) eb = eb.substring(0, 128);
      ai::logf("[ai] HTTP 非200 %d 响应体:%.100s", code, eb.c_str());
      http.end();
      return false;
    }
    // 读响应体：chunked 走手动解码（规避上述 TLS 明文空窗截断）；Content-Length 路径
    // writeToStreamDataBlock 外层循环会重试短读，getString 安全。
    if (http.header("Transfer-Encoding").indexOf("chunked") >= 0) {
      if (!read_chunked_body(g_client, resp, AI_HTTP_TIMEOUT_MS)) {
        g_client.stop();                      // 截断/超时：弃用复用连接
        http.end();
        if (pass == 0) continue;              // pass1 全新握手重发同 body
        return false;
      }
    } else {
      resp = http.getString();                // CL 路径：模型简短，落堆可接受
    }
    http.end();                               // 成功即保留连接，下轮复用
    return resp.length() > 0;
  }
  return false;
}

// 从响应提取 choices[0].message.content；同时打印 reasoning_content（思考过程，截断防刷屏）。
// broken: 解析失败时置 true（多半是传输层截断/复用残留，调用方应弃用复用连接）
static bool extract_content(const String& resp, String& content, bool* broken = nullptr) {
  // 若响应是 SSE 文本（chunked-SSE 解码产物）：按行取 data: 负载拼成最终 JSON
  String payload = resp;
  if (resp.startsWith("data:") || resp.indexOf("\ndata:") >= 0) {
    payload = "";
    int i = 0, n = resp.length();
    while (i <= n) {
      int j = resp.indexOf('\n', i);
      if (j < 0) j = n;
      String ln = resp.substring(i, j);
      i = j + 1;
      ln.trim();
      if (ln.startsWith("data:")) {
        String d = ln.substring(5); d.trim();
        if (d == "[DONE]") break;
        payload += d;
      }
    }
  }
  // 剥离开头泄漏的 chunked size 行（形如 "XX\r\n{" / "XX\n{"，XX 为 1-8 位十六进制长度）。
  // 复用连接偶发把某次响应的 size 行错位拼进下一条响应体顶部，deserializeJson 直接失败；
  // JSON 响应永远以 '{' 起始、永不始于 hex，故只在"hex+换行+{" 时剥离，绝不误伤正文。
  {
    auto ishex = [](char c){ return (c>='0'&&c<='9')||(c>='a'&&c<='f')||(c>='A'&&c<='F'); };
    for (int s = 0; s < 4; s++) {              // 最多剥 4 段（防多块错位叠加）
      const char* q = payload.c_str();
      int i = 0;
      while (i < 8 && ishex(q[i])) i++;        // 扫描十六进制前缀
      if (i == 0) break;                       // 开头非 hex，非泄漏
      int j = i;
      if (q[j] == '\r') j++;
      if (q[j] == '\n') j++;
      if (q[j] != '{') break;                  // 后随非 '{'，按正文处理
      payload = payload.substring(j);          // 剥掉这段 size 行
    }
  }
  JsonDocument doc(&g_js_alloc);
  if (deserializeJson(doc, payload)) {
    if (broken) *broken = true;  // 解析失败即视为连接可疑：截断/残留污染，调用方弃用复用连接
    // 解析失败诊断：打印完整 payload + 结构判据（判断是状体被拼断/chunked 泄漏/SSE 多段拼接）。
    auto sanitize = [](String s) {
      for (int i = 0; i < s.length(); i++) {
        unsigned char ch = (unsigned char)s[i];
        if (ch < 0x20 || ch == '\x7f') s[i] = '?';
      }
      return s;
    };
    // 结构判据：是否含 "\ndata:"(SSE 多帧)、是否含多个 "{"id"..."}(多 JSON 拼接)、是否含 chunk 大小泄漏前缀。
    bool sse = payload.indexOf("\ndata:") >= 0 || payload.startsWith("data:");
    int multi_json = 0;
    for (int i = payload.indexOf("{\"id\""); i >= 0 && i < payload.length(); i = payload.indexOf("{\"id\"", i + 1)) multi_json++;
    String full = sanitize(payload);
    ai::logf("[ai] JSON失败 len=%d sse=%d 多json=%d 截断=%d 全文:%s",
             (int)payload.length(), sse ? 1 : 0, multi_json,
             (payload.length() > 0 && payload[payload.length() - 1] != '}' && payload[payload.length() - 1] != ']') ? 1 : 0,
             full.c_str());
    return false;
  }
  const char* rc = doc["choices"][0]["message"]["reasoning_content"] | "";
  if (rc[0]) {
    String r = rc;
    if (r.length() > 120) r = r.substring(0, 120);
    ai::logf("[ai] 思考: %s", r.c_str());   // 仅调试展示，不回投（决策由完整 reason 承接）
  }
  const char* c = doc["choices"][0]["message"]["content"] | "";
  // 注意：content 为空但 reasoning 有值 = 模型只给了思考没给正式回答（安全终止/条件触达）
  if (!c[0] && rc[0]) {
    String rr = rc;
    if (rr.length() > 120) rr = rr.substring(0, 120);
    ai::logf("[ai] content为空但reasoning有值(%u字节): %s", (unsigned)strlen(rc), rr.c_str());
  }
  content = c;
  return content.length() > 0;
}

// ---------------- 结果文本构建 ----------------

static String build_feedback(unsigned long id, const JsonDocument& cmd) {
  JsonDocument out(&g_js_alloc);
  out["type"] = "ai_result";
  if (id) out["id"] = (long)id;
  JsonObject p = out["params"].to<JsonObject>();
  const char* reason = cmd["reason"] | "";
  p["reason"] = reason;
  if (cmd["error"]) p["error"] = cmd["error"].as<const char*>();
  if (cmd["done"].is<bool>()) p["done"] = cmd["done"].as<bool>();
  // 内嵌词表指令（供 Godot 显示）
  if (cmd["type"] ) {
    JsonObject inner = p["command"].to<JsonObject>();
    inner["type"] = cmd["type"].as<const char*>();
    if (cmd["params"].is<JsonObject>()) inner["params"] = cmd["params"].as<JsonObjectConst>();
    const char* rs = cmd["reason"] | "";
    if (rs[0]) inner["reason"] = rs;
  }
  String s;
  serializeJson(out, s);
  return s;
}

// ---------------- worker 任务 ----------------

static void ai_worker(void*) {
  for (;;) {
    xSemaphoreTake(g_notify, portMAX_DELAY);

    TaskLocal t;
    xSemaphoreTake(g_mtx, portMAX_DELAY);
    if (g_slot.active) {
      t = g_slot;
      g_slot.text = nullptr; g_slot.ann = nullptr; g_slot.ctx = nullptr; g_slot.active = false;
    }
    xSemaphoreGive(g_mtx);
    if (!t.text && !t.nav) continue;

    // 纯导航任务（/move to）：不调云端，直接本地巡航到目标坐标即回报。
    if (t.nav) {
      m_busy = true;
      if (!t.nav_global) { s_car_x = 0; s_car_y = 0; s_car_heading = 0; }  // local=以当前位姿为新原点
      NavR r = navigate_to(t.generation, t.nav_x, t.nav_y, NAV_STOP_CM_GOTO);
      JsonDocument f(&g_js_alloc);
      f["type"] = "ai_result";
      if (t.id) f["id"] = (long)t.id;
      f["params"]["reason"] = r == NavR::Reached ? "已到达目标坐标" : "导航被中断";
      f["params"]["done"] = (r == NavR::Reached);
      String s; serializeJson(f, s);
      enqueue_result(s.c_str(), t.fn, t.ctx);
      blog::logf(blog::AI, "导航结束 rel=%d", (int)r);
      if (t.ctx) delete (int*)t.ctx;
      m_busy = false;
      continue;
    }

    g_last_continuous = false;  // 本任务尚未下发过持续指令（防上一任务残留标志误判）
    g_last_cont_type = 0;
    m_busy = true;
    // 新任务 = 新坐标系：车位置=原点、初始车头=0°，清空上一任务的空间记忆。
    s_car_x = 0; s_car_y = 0; s_car_heading = 0;
    memset(g_mem, 0, sizeof(g_mem));
    // 摄像头可用性在任务起点判定（init 后即定）：不可用则整轮走无画面降级
    bool cam_ok = cam::available();
    ai::logf("[ai] 任务开始 gen=%lu text=%s%s", t.generation, t.text, cam_ok ? "" : "（无摄像头→无画面模式）");
    // 单应状态诊断：若未就绪，所有 px/py 观测都会被拒，直接可看出问题
    if (!ground::ready()) ai::logf("[ai] 警告：单应未就绪（像素观测将全部被拒绝）");
    else {
      float ex, ey;
      ground::screen_to_world(0.5f, 0.5f, &ex, &ey);
      ai::logf("[ai] 单应OK 中心→(%.0f,%.0f)", ex, ey);
    }
    // 打印实际端点/模型，便于排查 404/401 等云端拒绝（配错路径是常见原因）
    ai::logf("[ai] 端点=%s 模型=%s key=%s", cfg::ai_url().c_str(), cfg::ai_model().c_str(),
                  cfg::ai_key().isEmpty() ? "空" : "已配置");

    unsigned long steps = 0;
    bool done = false;
    bool sent_done = false;      // 是否已确报过终态 done（正常/单轮/超步数/超连续失败）
    bool interrupted = false;    // 是否因新目标/手动中断退出（代际变更），此时不发补发 done
    const char* fail = nullptr;
    char err_buf[160];
    // 死循环防线状态：上一步指令短描述 / 连续相同指令计数 / 已注入引导标记。
    char last_cmd[48] = {0}, cur_cmd[48] = {0};
    unsigned long last_act_ms = 0;  // 上次真正下执行/微操指令的时刻（ms），供给 AI 算"距上次决策多久"
    int net_fail = 0;           // 连续"无有效输出"轮数（网络/解析失败），用于退避与上限收尾
    int stall = 0;
    bool stall_hint = false;
    bool want_prev = false;     // AI 上轮 carry_prev=true → 本轮带上 prev 帧做对比
    char task_note[192] = {0};  // AI 写入的任务笔记（目标外观/计划），每轮喂回
    struct { char name[48]; bool done; } s_tasks[8] = {{0}};  // AI 维护的任务列表（JSON 更新）
    int s_task_n = 0;
    // 当前任务目标（独立 user 消息展示；可被 task_goal 热替换）
    char goal_now[256];
    snprintf(goal_now, sizeof(goal_now), "%s", t.text ? t.text : "");
    // 历史环（PSRAM 动态分配）：AI 决策(assistant) + 插话(user) 共用一条管理，满员淘汰最旧。
    char* hist_text[AI_HIST_N] = {nullptr};
    const char* hist_role[AI_HIST_N] = {nullptr};   // "assistant" / "user"
    int hist_n = 0;
    char task_remind[160] = {0};  // 插话即将被冲掉前的提醒（提示补 task_goal 更新目标），一次性消费
    auto ps_dup = [](const char* s) -> char* {   // 拷贝到 PSRAM（供历史条用）
      size_t n = strlen(s);
      char* p = (char*)heap_caps_malloc(n + 1, MALLOC_CAP_SPIRAM);
      if (p) memcpy(p, s, n + 1);
      return p;
    };
    auto hist_add = [&](const char* role, const char* text) {   // 推入历史环（满则冲掉最旧）
      char* dup = ps_dup(text);
      if (!dup) return;
      if (hist_n < AI_HIST_N) { hist_role[hist_n] = role; hist_text[hist_n] = dup; hist_n++; }
      else {
        if (hist_role[0] && !strcmp(hist_role[0], "user"))   // 被冲掉的恰是插话：提醒先 task_goal 更新目标
          snprintf(task_remind, sizeof(task_remind),
                   "较早的一条操作者插话即将被历史丢弃；若它表达了新任务/新目标而你还未用 task_goal 更新，请现在更新。");
        free(hist_text[0]);
        memmove(hist_text, hist_text + 1, (AI_HIST_N - 1) * sizeof(hist_text[0]));
        memmove(hist_role, hist_role + 1, (AI_HIST_N - 1) * sizeof(hist_role[0]));
        hist_text[AI_HIST_N - 1] = dup; hist_role[AI_HIST_N - 1] = role;
      }
    };

    // 编辑图一次性取快照（供整轮任务复用，避免中途被覆盖）。
    uint8_t* edited = nullptr; size_t edited_len = 0;
    if (t.use_image) {
      edited = (uint8_t*)heap_caps_malloc(AI_EDITED_IMG_MAX, MALLOC_CAP_SPIRAM);
      if (edited && !take_edited(edited, AI_EDITED_IMG_MAX, &edited_len)) { free(edited); edited = nullptr; }
    }
    // 本轮帧的 PSRAM 副本（任务期复用）：抓帧后立即把字节拷进来并归还相机缓冲，
    // 避免 AI 在做慢速 TLS 请求期间长时间占用 fb_count=2 的缓冲池把推流饿死。
    uint8_t* cur = nullptr; size_t cur_len = 0;
    // 上一帧 PSRAM 副本（周期性双帧运动对比用；任务期复用）。
    uint8_t* prev = nullptr; size_t prev_len = 0;

    // 兜底 stop（任务终结出口统一解析一次）。g_stop_mode 由打断方写入：
    // None=手动 move/stop 接管（用户指令已覆盖，不补停）；Wheels=手动 arm（只停轮子）；All=其余。
    // 仅当存在持续指令残留才补。
    auto resolve_stop = [&]() {
      if (g_stop_mode == (int)ai::StopMode::None) return;
      if (!g_last_continuous) return;
      // Wheels 模式只对轮子持续残留停轮子；臂持续残留（或未知）必须全停。
      const char* scope = (g_stop_mode == (int)ai::StopMode::Wheels && g_last_cont_type == 1) ? "wheels" : "all";
      JsonDocument d; d["scope"] = scope;   // d 即 stop 的 params 对象
      exec::act("stop", d.as<JsonObjectConst>());
      blog::logf(blog::AI, "兜底 stop scope=%s", scope);
      g_last_continuous = false;
    };

    while (!done) {
      uint64_t step_ts = esp_timer_get_time();  // 本轮起点（周期控制基准）
      fail = nullptr;  // 每轮重置，避免沿用上轮错误文本误导日志/回报
      // 中止检查（代际号变化即本任务作废）；兜底停统一在任务出口解析。
      if (t.generation != m_generation) { blog::logf(blog::AI, "被新目标/手动中断"); interrupted = true; break; }
      if (!net::is_connected()) { snprintf(err_buf, sizeof(err_buf), "WiFi 掉线"); fail = err_buf; break; }
      if (cfg::ai_key().isEmpty()) { snprintf(err_buf, sizeof(err_buf), "未配置 AI Key"); fail = err_buf; break; }

      // 取当前帧（失败重试，避免推流占缓冲时一次失败即判死）；无摄像头则跳过，走无画面降级
      camera_fb_t* fb = nullptr;
      if (cam_ok) {
        for (int fr = 0; fr < 3 && !fb; fr++) {
          fb = cam::grab();
          if (!fb && fr < 2) vTaskDelay(pdMS_TO_TICKS(50));
        }
        if (!fb) { snprintf(err_buf, sizeof(err_buf), "取帧失败"); fail = err_buf; break; }
      }
      const uint8_t* frame = fb ? fb->buf : nullptr;
      size_t frame_len = fb ? fb->len : 0;

      // 抓帧后立即拷入 PSRAM 副本并归还相机缓冲：AI 的 HTTPS（TLS 握手+请求）
      // 慢则数秒，期间一直占着 fb 会把 fb_count=2 的缓冲池耗尽，饿死并行推流。
      // 帧数据后续（body 组装）一律用这份副本。
      if (fb && frame_len > 0 && frame_len <= AI_EDITED_IMG_MAX) {
        if (!cur) cur = (uint8_t*)heap_caps_malloc(AI_EDITED_IMG_MAX, MALLOC_CAP_SPIRAM);
        if (cur) { memcpy(cur, frame, frame_len); cur_len = frame_len; }
        else cur_len = 0;
      }
      cam::return_frame(fb);
      // 副本就绪才认本帧（fb 已归还，直接指向裸 fb->buf 即为悬垂）：过大或拷入失败则按无画面处理。
      if (cur_len > 0) { frame = cur; frame_len = cur_len; }
      else { frame = nullptr; frame_len = 0; }

      bool got = false;
      for (int attempt = 0; attempt < 2 && !done; attempt++) {
        // 引导语：重试纠正 / 死循环打断（连续多轮相同指令，带重复指令名便于 AI 自我纠正）
        char hint_buf[192];
        const char* hint;
        if (attempt) {
          hint = "上次输出非法，请只输出合法 JSON 词表指令。";
        } else if (stall_hint) {
          snprintf(hint_buf, sizeof(hint_buf),
                   "连续多轮重复「%s」无进展：先改变观察角度重新确认目标（抬/落机械臂、后退或环视），若夹爪已夹紧或无法达成则输出 stop。", last_cmd);
          hint = hint_buf;
        } else {
          hint = "";
        }
        PsaBuf body;
        char st[192];  // exec 状态缓冲（含不可达诊断，需足量避免截断）
        const char* stp = exec::read_state(st, sizeof(st)) ? st : "";  // 本地直驱状态（无执行板，状态本地合成）
        // 每轮取一次插话（一次性消费，读完清空）：推入历史环作 user 消息，随环一起保留/冲掉。
        char chat_now[256] = {0};
        xSemaphoreTake(g_mtx, portMAX_DELAY);
        if (g_chat_has) { strncpy(chat_now, g_chat, sizeof(chat_now) - 1); utf8_clamp_tail(chat_now); g_chat_has = false; }
        xSemaphoreGive(g_mtx);
        if (chat_now[0]) { hist_add("user", chat_now); }   // 插话进入共享历史（操作者话语）
        // 上一帧是否带上：仅由 AI 上轮 carry_prev=true 决定（锁定/追踪意图），其余保持单帧省开销。
        bool use_prev = want_prev && prev_len > 0;
        // 操作者参考图：仅首轮带一次（初始目标外观参考）；之后不续带（已去掉 carry_user）。
        bool use_edited_now = (steps == 0) && edited != nullptr;
        // 渲染任务列表喂回：任务列表：1.出门[完成] 2.右转[未完成] ...
        char task_s[320] = {0};
        if (s_task_n > 0) {
          int tp2 = snprintf(task_s, sizeof(task_s), "任务列表：");
          for (int ti = 0; ti < s_task_n && tp2 < (int)sizeof(task_s) - 48; ti++)
            tp2 += snprintf(task_s + tp2, sizeof(task_s) - tp2, "%d.%s[%s] ",
                            ti + 1, s_tasks[ti].name, s_tasks[ti].done ? "完成" : "未完成");
        }
        // 合并本轮提示（在插话 hist_add 之后构建，确保其触发的 task_remind 本轮可见）：
        // 一次性提醒（插话将冲掉→提示补 task_goal）在前，死循环引导在后
        char hint_cb[384] = {0};
        if (task_remind[0]) { snprintf(hint_cb, sizeof(hint_cb), "%s", task_remind); task_remind[0] = 0; }
        if (hint && hint[0]) {
          size_t hl = strlen(hint_cb);
          if (hl) hint_cb[hl++] = '；';
          snprintf(hint_cb + hl, sizeof(hint_cb) - hl, "%s", hint);
        }
        // 历史环逐条喂给 build_body（assistant=AI决策 / user=插话，真多轮对话）
        build_body(body, goal_now, t.ann, hint_cb,
                   (const char* const*)hist_role, (const char* const*)hist_text, hist_n,
                   stp,
                   last_act_ms ? (unsigned)((esp_timer_get_time() / 1000 - last_act_ms) / 1000) : 0u,
                   task_note, task_s,
                   frame, frame_len, prev, use_prev ? prev_len : 0,
                   use_prev, use_edited_now, edited, edited_len);
        if (!body.ok) { fail = "组装请求 body 失败"; break; }

        String resp;
        bool http_ok = false;
        for (int nr = 0; nr < 3 && !http_ok; nr++) {   // 网络失败指数退避重试（任务串行，代价可控）
          if (http_post(cfg::ai_url().c_str(), cfg::ai_key().c_str(), body.p, resp, t.generation)) { http_ok = true; break; }
          if (t.generation != m_generation) { done = true; interrupted = true; break; }  // 被中止，静默作废
          if (g_last_status >= 400 && g_last_status < 500) {  // 4xx 重发同 body 必然再拒，快速失败
            fail = "云端拒绝(4xx)，疑似参数或限流";
            break;
          }
          if (nr < 2) { vTaskDelay(pdMS_TO_TICKS(500 << nr)); blog::logf(blog::AI, "网络失败重试 %d", nr + 1); }
        }
        if (done) break;
        if (!http_ok) { if (!fail) fail = "AI 请求失败"; break; }
        if (t.generation != m_generation) { done = true; interrupted = true; break; }  // 在途结果作废

        String content;
        bool body_broken = false;
        if (!extract_content(resp, content, &body_broken)) {
          // 解码成功但无有效内容（瞬态错误体/空 content 等）：打印原始片段便于定位
          blog::logf(blog::AI, "响应无内容，原始(前120B): %s", resp.substring(0, 120).c_str());
          fail = "AI 响应无内容";
          if (body_broken) g_client.stop();  // 传输层截断/残留：弃用复用连接，下次全新握手防污染
          continue;  // 空内容→重试，不终止
        }

        JsonDocument cmdD(&g_js_alloc);  // PSRAM 池：避免每轮在内部堆分配/释放制造碎片（freeHeap 泄漏嫌疑）
        const char* verr = validate_cmd(content.c_str(), cmdD, err_buf, sizeof(err_buf));
        if (!verr) {
          const char* type = cmdD["type"] | "";
          JsonObjectConst params = cmdD["params"].as<JsonObjectConst>();
          if (!strcmp(type, "approach")) {
            // 本地自动靠近：不点云端，直接按记忆目标巡航到近距，交还 AI 继续微操。
            const char* tgt = params["target"] | "";
            float tx, ty;
            bool found = mem_find(tgt[0] ? tgt : nullptr, &tx, &ty);
            const char* why = nullptr;
            bool arrived = false;
            if (!found) {
              why = tgt[0] ? "approach 目标不在记忆里，请先 observe 锁定" : "approach 无可用目标记忆，请先 observe";
            } else {
              NavR r = navigate_to(t.generation, tx, ty, AI_APPROACH_STOP_CM);
              if (r == NavR::Interrupted) { interrupted = true; done = true; break; }   // 被接管：本任务作废
              arrived = (r == NavR::Reached);
              why = arrived ? "已自动靠近目标，交还你微操" : "靠近收敛结束，由你继续";
              last_act_ms = (unsigned long)(esp_timer_get_time() / 1000);
            }
            JsonDocument cmdF(&g_js_alloc);
            cmdF["type"] = "approach";
            cmdF["reason"] = why;
            cmdF["params"]["target"] = tgt[0] ? tgt : "(最近)";
            String fb = build_feedback(t.id, cmdF);
            enqueue_result(fb.c_str(), t.fn, t.ctx);
            stall = 0; stall_hint = false;    // 本地巡航视为有意推进，不复位死循环判据
            got = true;
            net_fail = 0;
            break;
          }
          if (!strcmp(type, "wait")) {
            // wait=空操作：不下发执行板，保持当前动作，任务继续观察。
            // 视为有意进展：复位死循环计数，避免"等待"被当成无进展注入引导。
            stall = 0; stall_hint = false;
            uint64_t now = (uint64_t)(esp_timer_get_time() / 1000);
            if (now - g_last_wait_fb_ms >= AI_WAIT_FB_MIN_MS) {  // 反馈节流，防每轮刷屏
              g_last_wait_fb_ms = now;
              String fb = build_feedback(t.id, cmdD);
              enqueue_result(fb.c_str(), t.fn, t.ctx);
            }
            got = true;
            break;
          }
          // 校验通过 → 执行 move/arm/stop（本板直驱，不再经执行板），记录时刻供时间感知。
          exec::act(type, params);
          last_act_ms = (unsigned long)(esp_timer_get_time() / 1000);
          // 空间记忆：先解析 AI observe（用**动作前**的车位姿把观测转全局），再按 move/spin 更新车姿态。
          if (cmdD["observe"].is<JsonObject>()) {
            JsonObjectConst ob = cmdD["observe"].as<JsonObjectConst>();
            const char* nm = ob["name"] | "";
            bool vis = ob["visible"] | true;
            if (nm[0]) {
              // 优先用屏幕像素 px/py（单应解算，精度高）；越界/解算失败或没报像素则回退 rel_deg/dist。
              bool has_px = ob["px"].is<float>() || ob["px"].is<int>();
              bool has_py = ob["py"].is<float>() || ob["py"].is<int>();
              if (has_px && has_py) {
                if (!mem_observe_xy(nm, vis, ob["px"] | 0.0f, ob["py"] | 0.0f))
                  mem_observe(nm, vis, ob["rel_deg"] | 0.0f, ob["dist_cm"] | 0.0f);
              } else {
                mem_observe(nm, vis, ob["rel_deg"] | 0.0f, ob["dist_cm"] | 0.0f);
              }
            }
          }
          car_update_pose(type, params);
          // 无里程计兜底：AI 无定距的持续 move 单次最多行驶 AI_MOVE_CAP_MS，到期由 exec 自动停轮；
          // 带 distance_cm 的定距 move 已在 send_move 按时长近似自停，不叠加持续兜底。
          if (!strcmp(type, "move") && !params["distance_cm"].is<int>() &&
              fabsf(params["throttle"] | 0.0f) > 0.001f)
            exec::set_move_cap_ms(AI_MOVE_CAP_MS);
          g_last_continuous = exec::is_continuous(type, params);
          g_last_cont_type = g_last_continuous ? (!strcmp(type, "move") ? 1 : 2) : 0;
          ai::logf("[ai] 执行 %s%s", type, g_last_continuous ? "（持续）" : "");
          String fb = build_feedback(t.id, cmdD);
          enqueue_result(fb.c_str(), t.fn, t.ctx);
          // 死循环防线：连续多轮下发相同指令 → 下轮注入引导语让 AI 主动变化
          fmt_last(cur_cmd, sizeof(cur_cmd), type, params);
          if (strcmp(cur_cmd, last_cmd)) { stall = 0; stall_hint = false; }
          else if (++stall >= 3 && !stall_hint) { stall_hint = true; blog::logf(blog::AI, "多轮无进展，注入引导"); }
          snprintf(last_cmd, sizeof(last_cmd), "%s", cur_cmd);
          // AI 显式要求保留上一帧（锁定/追踪）：下轮带上 prev；否则按兜底节奏走
          want_prev = cmdD["carry_prev"].is<bool>() && cmdD["carry_prev"].as<bool>();
          // 任务笔记/进度：AI 写入并持续喂回（目标外观/计划/进行到哪）
          const char* tn = cmdD["task_note"] | "";
          if (tn[0] && strcmp(tn, task_note)) {
            strncpy(task_note, tn, sizeof(task_note) - 1); task_note[sizeof(task_note) - 1] = 0;
            ai::logf("[ai] 任务笔记: %s", task_note);
          }
          // 任务列表：全量重写（新建/重组时用，低频）；AI 每轮只看到当前状态喂回。
          if (cmdD["tasks"].is<JsonArray>()) {
            JsonArrayConst ta = cmdD["tasks"].as<JsonArrayConst>();
            int n = 0;
            for (JsonObjectConst it : ta) {
              if (n >= 8) break;
              const char* nm = it["name"] | "";
              if (!nm[0]) continue;
              strncpy(s_tasks[n].name, nm, 47); s_tasks[n].name[47] = 0;
              s_tasks[n].done = it["done"] | false;
              n++;
            }
            if (n > 0 || s_task_n > 0) { s_task_n = n; ai::logf("[ai] 任务列表更新(%d项)", s_task_n); }
          }
          // 任务状态标记：增量（第 N 项完成/未完成，index 从 1 起）
          if (cmdD["task_done"].is<JsonObject>()) {
            int idx = (cmdD["task_done"]["index"] | 0) - 1;
            if (idx >= 0 && idx < s_task_n) {
              s_tasks[idx].done = cmdD["task_done"]["done"] | false;
              ai::logf("[ai] 任务%d → %s", idx + 1, s_tasks[idx].done ? "完成" : "未完成");
            }
          }
          // 发给 AI 的"上一步已下发"：指令 + 完整 reason（含目标方位），替代双帧供跨轮衔接。
          // 末尾整字符钳制（utf8_clamp_tail）防半个中文字节被云端判 400，但不做长度截断。
          const char* r = cmdD["reason"] | "";
          {
            PsaBuf ld;   // 指令+完整 reason
            ld.put(cur_cmd); ld.put("，原因："); ld.put(r);
            utf8_clamp_tail(ld.p);
            // AI 决策(assistant) 直接滚入历史环（省去中转拷贝一次）；ld.p 作用域末自动释放
            if (ld.len) hist_add("assistant", ld.p);
          }
          // AI 显式 task_goal：把插话/新意图提升为目标（只替换目标 message，不碰 system → 保缓存）
          const char* tg = cmdD["task_goal"] | "";
          if (tg[0] && strcmp(tg, goal_now)) {
            snprintf(goal_now, sizeof(goal_now), "%s", tg);
            utf8_clamp_tail(goal_now);
            ai::logf("[ai] 目标更新: %s", goal_now);
          }
          // stop + done:true = AI 自判任务完成：停车并结束任务（build_feedback 已带 done 上报手机端）；
          // 不带 done 的 stop 仅临时停车观察，任务继续下一轮。严格按 bool 判定，防模型输出字符串 "true"。
          if (!strcmp(type, "stop") && cmdD["done"].is<bool>() && cmdD["done"].as<bool>()) {
            done = true;
            sent_done = true;   // 已向手机确报终态，任务出口不再补发
            blog::logf(blog::AI, "AI 判定任务完成（stop+done）");
          }
          got = true;
          break;
        } else {
          blog::logf(blog::AI, "校验: %s", verr);
          fail = verr;  // 重试一次前暂存
        }
      }
      if (done) break;
      // 单轮模式（/ai oneshot）：一轮决策即收尾。本轮无有效输出（网络/解码/校验失败）
      // 时把原因作为 error 回报，不跳 3s 继续观察；持续指令残留由任务出口 resolve_stop 补停。
      if (t.one_shot) {
        if (!got && fail) {
          JsonDocument e(&g_js_alloc);
          e["error"] = fail;
          String s = build_feedback(t.id, e);
          enqueue_result(s.c_str(), t.fn, t.ctx);
        }
        // 单轮收尾：补一条带 done 的完成通知，让手机端复位「发送」并显示任务结束。
        JsonDocument e(&g_js_alloc);
        e["done"] = true;
        String s = build_feedback(t.id, e);
        enqueue_result(s.c_str(), t.fn, t.ctx);
        sent_done = true;   // 单轮已确报终态
        done = true;
        break;
      }
      if (!got) {
        // 网络/解析持续失败：逐轮指数退避（3s→6s→12s→24s 封顶），避免每轮狂建连接把云端打得更紧；
        // 429 限流给更长喘息（30s）再继续；失败原因同步推手机。
        if (++net_fail >= AI_MAX_NET_FAIL) {
          const char* reason = "云端持续无响应（疑似限流），任务已中止，请稍后重试";
          JsonDocument e(&g_js_alloc);
          e["error"] = reason;
          e["done"] = true;   // Bug1：终结必带 done，让手机端把「中止」复位为「发送」
          sent_done = true;
          String s = build_feedback(t.id, e);
          enqueue_result(s.c_str(), t.fn, t.ctx);
          blog::logf(blog::AI, "连续网络失败超限，任务中止");
          break;
        }
        int wait = g_last_status == 429 ? 30000 : (3000 << (net_fail > 3 ? 3 : net_fail - 1));
        ai::logf("[ai] 本轮无有效输出（%s），%ds 后重试", fail ? fail : "未知", wait / 1000);
        vTaskDelay(pdMS_TO_TICKS(wait));
      } else {
        net_fail = 0;
      }
      mem_tick_stale();   // 每轮结束：未观测的物体过期轮数 +1

      // 滚动缓存上一帧：仅当 AI 下一轮 carry_prev=true 时才发送作对比（锁定/追踪场景），
      // 其余单帧以节省云端处理开销。AI 不要求即永不发送此帧。
      if (frame) {
        if (!prev) prev = (uint8_t*)heap_caps_malloc(AI_EDITED_IMG_MAX, MALLOC_CAP_SPIRAM);
        if (prev && frame_len <= AI_EDITED_IMG_MAX) { memcpy(prev, frame, frame_len); prev_len = frame_len; }
        else prev_len = 0;
      }

      if (++steps >= AI_MAX_STEPS_PER_GOAL) {
        JsonDocument e(&g_js_alloc); e["done"] = true; String s = build_feedback(t.id, e); enqueue_result(s.c_str(), t.fn, t.ctx);
        sent_done = true;
        break;
      }
      // 周期控制：以 AI_INTERVAL_MS 为下限节奏，扣掉本轮已耗时（含抓帧/HTTP/校验），
      // 服务端快（单帧 ~2s）时立即进入下一轮，慢时由服务端耗时主导。
      uint64_t el = esp_timer_get_time() - step_ts;
      long rem = (long)AI_INTERVAL_MS - (long)(el / 1000);
      if (rem > 0) vTaskDelay(pdMS_TO_TICKS(rem));
    }

    // 任务终结补发 done：覆盖失败/掉线等"只报 error 不带 done"的终态（Bug1），
    // 让手机端把「中止」复位为「发送」。被新目标/手动中断（interrupted）时跳过，
    // 避免把下一任务的按钮状态误复位。正常 stop+done / 单轮 / 超步数已置 sent_done，不再补发。
    if (!interrupted && !sent_done) {
      JsonDocument e(&g_js_alloc);
      e["done"] = true;
      if (fail) e["error"] = fail;
      String s = build_feedback(t.id, e);
      enqueue_result(s.c_str(), t.fn, t.ctx);
    }

    if (edited) free(edited);
    if (cur) free(cur);          // 本轮帧 PSRAM 副本
    if (prev) free(prev);        // 上一帧 PSRAM 副本
    for (int i = 0; i < AI_HIST_N; i++) free(hist_text[i]);   // 历史环 PSRAM
    if (t.ctx) delete (int*)t.ctx;  // 任务期 sink fd
    ai::logf("[ai] 任务结束 gen=%lu", t.generation);
    free(t.text); free(t.ann);
    resolve_stop();   // 统一兜底：持续指令残留即补停
    m_busy = false;
  }
}

// ---------------- 对外 ----------------

// mbedTLS 内存搬到 PSRAM：TLS 握手/传输要连续分配 in+out 缓冲（各 16KB）和 context，
// 内部堆碎片化时（maxBlock<12K 日志频繁 code=-1/-3/-11）握手必败。把 mbedTLS 内部所有
// 分配改为优先 PSRAM（8MB 充足），内部堆只留少量连续块即可握手。PSRAM 满则回退内部堆。
static void* ai_tls_calloc(size_t n, size_t s) {
  void* p = heap_caps_calloc(n, s, MALLOC_CAP_SPIRAM);
  if (!p) p = heap_caps_calloc(n, s, MALLOC_CAP_INTERNAL);
  return p;
}
static void ai_tls_free(void* p) { heap_caps_free(p); }

void ai::init() {
  if (g_worker) return;
  blog::logf(blog::AI, "build=hwaes_int8192_v4  （TLS: 硬件AES/INTERNAL/8192；ws_stream/ping_svc 栈已调大）");
  ground::init();   // 屏幕→地面单应拟合 + 诊断日志（见 ground_proj）
  g_mtx = xSemaphoreCreateMutex();
  g_notify = xSemaphoreCreateBinary();
  g_img_mtx = xSemaphoreCreateMutex();
  g_result_q = xQueueCreate(8, sizeof(ResultItem*));
  xTaskCreatePinnedToCore(ai_worker, "ai_worker", 16384, nullptr, 2, &g_worker, 1);
  blog::logf(blog::AI, "worker 就绪");
}

void ai::set_goal(const char* text, bool use_image, const char* annotation, long id,
                  cmd::ReplyFn reply, void* reply_ctx, bool one_shot) {
  xSemaphoreTake(g_mtx, portMAX_DELAY);
  ++m_generation;
  g_chat_has = false;   // 新目标清除上一任务的残留插话，避免串任务
  // 替换旧槽（旧字符串为空因 worker 已取走；残余则释放）
  if (g_slot.text) free(g_slot.text);
  if (g_slot.ann) free(g_slot.ann);
  if (g_slot.ctx) delete (int*)g_slot.ctx;
  g_slot.text = strdup(text ? text : "");
  g_slot.ann = (annotation && annotation[0]) ? strdup(annotation) : nullptr;
  g_slot.use_image = use_image;
  g_slot.one_shot = one_shot;
  g_slot.id = id;
  g_slot.generation = m_generation;
  g_slot.fn = reply;
  g_slot.ctx = reply_ctx;   // WS: 堆 int*；BLE: nullptr
  g_slot.nav = false;       // 新 AI 目标覆盖可能的纯导航残留
  g_slot.active = true;
  xSemaphoreGive(g_mtx);
  // 尝试掐断在途请求，让 worker 尽快回到循环取新槽
  g_client.stop();
  g_stop_mode = (int)StopMode::All;   // 新目标打断旧任务：残留持续指令在旧任务出口补停
  xSemaphoreGive(g_notify);
}

// /move to x y：板端本地巡航到坐标（不调 AI）。local=以当前位姿为新原点；
// global=沿用当前全局系（可与 AI/历史导航共用坐标系）。手动接管类：打断在途任务。
void ai::goto_target(float x, float y, bool frame_global, long id, cmd::ReplyFn reply, void* reply_ctx) {
  xSemaphoreTake(g_mtx, portMAX_DELAY);
  ++m_generation;               // 新导航接管：在途 AI/导航作废
  g_chat_has = false;           // 清上一任务残留插话
  if (g_slot.text) free(g_slot.text);
  if (g_slot.ann) free(g_slot.ann);
  if (g_slot.ctx) delete (int*)g_slot.ctx;
  g_slot.nav = true;
  g_slot.nav_x = x; g_slot.nav_y = y;
  g_slot.nav_global = frame_global;
  g_slot.text = nullptr; g_slot.ann = nullptr;
  g_slot.use_image = false; g_slot.one_shot = false;
  g_slot.id = id;
  g_slot.generation = m_generation;
  g_slot.fn = reply;
  g_slot.ctx = reply_ctx;   // 直接接管 command.cpp 预建的堆 fd（对齐 set_goal），由 nav 分支释放
  g_slot.active = true;
  xSemaphoreGive(g_mtx);
  g_client.stop();              // 掐断在途 AI 请求，worker 尽快回到循环取导航槽
  g_stop_mode = (int)StopMode::All;
  xSemaphoreGive(g_notify);
}

void ai::cancel(StopMode m) {
  xSemaphoreTake(g_mtx, portMAX_DELAY);
  bool was_active = g_slot.active;  // 仅当确有任务在跑才上报，避免手动指令刷屏
  ++m_generation;         // 使在途结果作废
  if (g_slot.text) { free(g_slot.text); g_slot.text = nullptr; }
  if (g_slot.ann) { free(g_slot.ann); g_slot.ann = nullptr; }
  if (g_slot.ctx) { delete (int*)g_slot.ctx; g_slot.ctx = nullptr; }
  g_slot.nav = false;
  g_slot.active = false;
  xSemaphoreGive(g_mtx);
  g_client.stop();
  g_stop_mode = (int)m;   // 手动 move/stop 接管=None（不补停）；arm=Wheels；ai_cancel=All
  if (was_active) blog::logf(blog::AI, "cancel");
}

bool ai::busy() { return m_busy; }

bool ai::append_chat(const char* text) {
  if (!text || !text[0]) return false;
  xSemaphoreTake(g_mtx, portMAX_DELAY);
  bool fed = m_busy;  // 仅当有任务在跑才接收插话
  if (fed) {
    strncpy(g_chat, text, sizeof(g_chat) - 1);
    g_chat[sizeof(g_chat) - 1] = 0;
    g_chat_has = true;
    blog::logf(blog::AI, "插话入队: %s", text);
  }
  xSemaphoreGive(g_mtx);
  return fed;
}
