YangQwQ/Stm32VisionSenseCar/Stm32-Vision/command.cpp

#include "command.h"
#include "config.h"
#include "wifi_net.h"
#include "ai_client.h"
#include "direct_exec.h"
#include "ping_svc.h"
#include "nezha_direct.h"
#include "board_log.h"

// 应答格式遵循架构 §5.1：板 → 手机文本 = {type:status/pong, params:{...}, id:<回填>}。
// move/stop/arm 是高频手动指令，只在 UART 层记录，不回文本（避免刷屏）。

static bool g_streaming = false;         // 图传开关全局状态（WS 推流任务读取）

static bool has_id(const JsonDocument& doc) {
  return doc["id"].is<int>() || doc["id"].is<long>();
}

// 合成板端状态位字节，供 get_state 与 reply_status 统一附带，手机端按位解析同步按钮。
// bit 布局与 Mobile-RemoteCtrl/Main.gd（_apply_state_bits）逐位 mirror，改一侧必改另一侧：
//   bit0 前灯 / bit1 震灯 / bit2 背灯 / bit3 夹爪夹紧 / bit4 AI busy；bit5-7 留空。
static uint8_t make_state_bits() {
  uint8_t b = 0;
  if (exec::light_on("front")) b |= 1u << 0;
  if (exec::light_on("vibe"))  b |= 1u << 1;
  if (exec::light_on("back"))  b |= 1u << 2;
  if (exec::grip_closing())    b |= 1u << 3;
  if (ai::busy())              b |= 1u << 4;
  return b;
}

// 组一段带原 id 的应答文本并发出（reply 可空）。
static void reply_status(JsonDocument& src, cmd::ReplyFn reply, void* ctx,
                         const char* reason) {
  if (!reply) {
    blog::logf(blog::CMD, "(无回复通道) %s", reason);
    return;
  }
  JsonDocument out;
  out["type"] = "status";
  JsonObject params = out["params"].to<JsonObject>();
  params["reason"] = reason;
  params["bits"] = make_state_bits();  // 附带状态位，让"会触发动作重置"的回执驱动手机端自动同步按钮
  if (has_id(src)) out["id"] = src["id"].as<long>();
  String s;
  serializeJson(out, s);
  reply(ctx, s.c_str());
}

// 与手机 /ping 对齐：回 {type:pong}（手机 WSCarClient 对 pong 直接读文本）。
static void reply_pong(JsonDocument& src, cmd::ReplyFn reply, void* ctx) {
  if (!reply) return;
  JsonDocument out;
  out["type"] = "pong";
  if (has_id(src)) out["id"] = src["id"].as<long>();
  String s;
  serializeJson(out, s);
  reply(ctx, s.c_str());
}

// 手动指令串口日志：只有指令类型切换时才打一行当作"确认收到"；
// 同一类型连续重复（摇杆高频帧）完全不输出，避免刷屏、也避免拖慢后续指令处理。
static void log_manual_throttled(const char* type) {
  static String s_last;
  if (s_last != type) {
    s_last = type;
    blog::logf(blog::CMD, "收到手动指令 %s", type);
  }
}

void cmd::handle(const char* json, bool has_frames, ReplyFn reply, void* reply_ctx) {
  JsonDocument doc;
  if (deserializeJson(doc, json)) {
    blog::logf(blog::CMD, "bad json: %s", json);
    return;
  }
  const char* type = doc["type"] | "";
  JsonObject params = doc["params"].as<JsonObject>();
  // 手动接管类型：move/stop/arm 之外，摇杆/直控面板的直接驱动指令（drive/spin/servo/motor/
  // arm_pose/reset）同样会接管小车运动，必须打断板载 AI 闭环，否则 AI 与手动抢控制权。
  bool manual = !strcmp(type, "move") || !strcmp(type, "stop") || !strcmp(type, "arm") ||
                !strcmp(type, "drive") || !strcmp(type, "spin") || !strcmp(type, "servo") ||
                !strcmp(type, "motor") || !strcmp(type, "arm_pose") || !strcmp(type, "reset");
  if (manual) {
    // 手动高频指令：先立即打断 AI 闭环并直接驱动哪吒扩展板（电机控制优先），
    // 串口日志只在类型切换时打一行，绝不让日志阻塞控制时序。
    // move/stop/arm 由本板直驱，不再经执行板。arm/arm_pose 打断只停轮子（机械臂指令即接管）。
    ai::cancel(!strcmp(type, "arm") || !strcmp(type, "arm_pose") ? ai::StopMode::Wheels : ai::StopMode::None);
    log_manual_throttled(type);
    if (!strcmp(type, "move") || !strcmp(type, "stop") || !strcmp(type, "arm")) {
      exec::act(type, params);
      return;
    }
    // drive/spin/servo/motor/arm_pose/reset 继续走下方各自分支（取消后落各自直驱逻辑）。
  } else {
    blog::logf(blog::CMD, "type=%s has_frames=%u", type, has_frames);
  }

  if (!strcmp(type, "config")) {
    // 配网（BLE 或 WS 同结构）：落 NVS → 在线重建 STA（不重启，BLE 保活）→ 上线后 BLE 上报 IP
    const char* ssid = params["ssid"] | "";
    const char* pass = params["password"] | "";
    if (!ssid[0]) {
      reply_status(doc, reply, reply_ctx, "config: SSID 为空");
      return;
    }
    if (!cfg::set_wifi(ssid, pass)) {
      reply_status(doc, reply, reply_ctx, "WiFi 配置未变化，跳过");
      return;
    }
    apply_network();
    reply_status(doc, reply, reply_ctx, "WiFi 配置已保存，正在连接…");
    return;
  }

  if (!strcmp(type, "ping")) {
    // 无 target = 测小车连通性（回 pong）；带 target（IP/域名）= 板子去 ping 并回报延迟。
    const char* target = params["target"] | "";
    if (target[0]) {
      ping::start(target, 5, reply, reply_ctx);
      String tip = "正在 ping " + String(target) + "…";
      reply_status(doc, reply, reply_ctx, tip.c_str());
    } else {
      reply_pong(doc, reply, reply_ctx);
    }
    return;
  }

  if (!strcmp(type, "pong")) {
    return;  // 板子 WS 活体探测的应答：仅当上行续活用，静默不回复
  }

  if (!strcmp(type, "stream")) {
    // 图传开关：更新全局状态，WS 推流任务读取。BLE 无帧通道也能开/关图传。
    bool on = params["on"] | false;
    set_streaming(on);
    reply_status(doc, reply, reply_ctx, on ? "图传已开启" : "图传已关闭");
    return;
  }

  if (!strcmp(type, "log")) {
    // 统一日志转发开关：/log <exec|ai|all> on|off。
    // 默认全关；exec = 直驱执行日志+周期状态推送，ai = AI 调试日志，
    // all = 板端串口所有输出全部转发手机（经统一日志队列）。
    const char* cat = params["cat"] | "";
    bool on = params["on"] | false;
    const char* cfg = nullptr;
    if (!strcmp(cat, "all")) { blog::set_all(on); cfg = on ? "全部日志转发已开启" : "全部日志转发已关闭"; }
    else if (!strcmp(cat, "exec")) { blog::enable(blog::EXEC, on); cfg = on ? "执行日志转发已开启" : "执行日志转发已关闭"; }
    else if (!strcmp(cat, "ai")) { blog::enable(blog::AI, on); cfg = on ? "AI日志转发已开启" : "AI日志转发已关闭"; }
    else { cfg = "log: cat 需 exec|ai|all"; }
    reply_status(doc, reply, reply_ctx, cfg);
    return;
  }

  if (!strcmp(type, "nz_read")) {
    // I2C 诊断（只读，不下发指令）：探测哪吒从机是否在线。写地址 ACK=从机活着且总线可用；
    // 两项皆无 = 总线/从机掉电或拉死（常见硬件故障，此时回正与控制全无响应）。
    uint8_t lb = 0;
    uint8_t st = nezha::probe(&lb);
    char buf[120];
    const char* core = (st & 1u) ? ((st & 2u) ? "哪吒在线(写ACK✓ 读ACK✓)" : "哪吒在位 读应答✗")
                                 : "哪吒无响应(写地址无ACK)";
    if ((st & 3u) == 3u) snprintf(buf, sizeof(buf), "%s 首字节=0x%02X -> I2C/从机正常", core, lb);
    else snprintf(buf, sizeof(buf), "%s -> 检查I2C连线/从机供电/总线是否被拉死", core);
    reply_status(doc, reply, reply_ctx, buf);
    return;
  }

  if (!strcmp(type, "get_state")) {
    // 主动查询当前状态（供手机重连后同步控制按钮）：回状态位字节，手机端按位解析灯/夹爪/AI 运行态。
    JsonDocument out;
    out["type"] = "state";
    JsonObject params = out["params"].to<JsonObject>();
    params["bits"] = make_state_bits();
    if (has_id(doc)) out["id"] = doc["id"].as<long>();
    String s;
    serializeJson(out, s);
    if (reply) { reply(reply_ctx, s.c_str()); }
    return;
  }

  if (!strcmp(type, "light")) {
    // 直驱灯光（绕过执行板）：/light <front|vibe|back> <0|1>。
    bool on = params["on"] | false;
    if (exec::act("light", params)) {
      reply_status(doc, reply, reply_ctx, on ? "灯已开" : "灯已关");
    } else {
      reply_status(doc, reply, reply_ctx, "light: kind 需 front|vibe|back");
    }
    return;
  }

  if (!strcmp(type, "reset")) {
    // 回正：机械臂四舵机回中 + 电机停（绕过执行板，直驱）。
    exec::reset();
    reply_status(doc, reply, reply_ctx, "已回正");
    return;
  }

  if (!strcmp(type, "ai_goal") || !strcmp(type, "ai_oneshot")) {
    // DIRECT：手机下发目标 → 板载 ai_client 调 AI。ai_goal=迭代闭环；ai_oneshot=只执行一轮收尾。
    if (cfg::ai_key().isEmpty()) {
      reply_status(doc, reply, reply_ctx, "AI 未配置（ai_key 为空），未调用云端");
      return;
    }
    const char* msg = params["message"] | "";
    bool use_image = params["use_image"] | false;
    bool one_shot = !strcmp(type, "ai_oneshot");

    // 组标注字符串（供 AI 观察近似意图区域）
    String ann;
    if (params["annotation"].is<JsonObject>()) {
      serializeJson(params["annotation"].as<JsonObjectConst>(), ann);
    }

    // WS 异步回复需堆拷贝 fd（ai_client 任务结束时释放）；BLE 传 nullptr。
    void* actx = nullptr;
    if (reply_ctx) actx = new int(*(int*)reply_ctx);
    long id = has_id(doc) ? doc["id"].as<long>() : 0;
    ai::set_goal(msg, use_image, ann.length() ? ann.c_str() : nullptr, id, reply, actx, one_shot);
    reply_status(doc, reply, reply_ctx, one_shot ? "已收到单轮 AI 目标" : "已收到目标，AI 处理中");
    return;
  }

  if (!strcmp(type, "ai_cancel")) {
    // 显式取消 AI 任务：残留持续指令会在任务出口补停（≠强制停车）。
    ai::cancel(ai::StopMode::All);
    reply_status(doc, reply, reply_ctx, "AI 任务已取消");
    return;
  }

  if (!strcmp(type, "ai_chat")) {
    // AI 任务进行中"插话"：把用户补充喂给当前任务，不打断（区别于 ai_goal/ai_cancel）。
    // 无任务在跑时忽略，仅回执提示——不当作新目标接管。
    const char* msg = params["message"] | "";
    if (!msg[0]) {
      reply_status(doc, reply, reply_ctx, "ai_chat: message 为空");
      return;
    }
    bool fed = ai::append_chat(msg);
    reply_status(doc, reply, reply_ctx, fed ? "已补充给 AI（任务继续）" : "当前无进行中的 AI 任务，补充被忽略");
    return;
  }

  if (!strcmp(type, "goto")) {
    // /move to x y [global|local]：板端本地巡航到坐标（不调 AI，手动接管类）。
    // 需 x,y；frame=local（默认，原点=当前位姿，y向前 x向右）/global（沿用全局系）。
    bool has_x = params["x"].is<float>() || params["x"].is<int>();
    bool has_y = params["y"].is<float>() || params["y"].is<int>();
    if (!has_x || !has_y) {
      reply_status(doc, reply, reply_ctx, "goto: 需 x,y 坐标（local 原点=当前位姿，y向前 x向右；frame=global 沿用全局系）");
      return;
    }
    float x = params["x"] | 0.f;
    float y = params["y"] | 0.f;
    bool global = !strcmp((const char*)(params["frame"] | "local"), "global");
    void* actx = reply_ctx ? new int(*(int*)reply_ctx) : nullptr;
    long id = has_id(doc) ? doc["id"].as<long>() : 0;
    ai::goto_target(x, y, global, id, reply, actx);
    reply_status(doc, reply, reply_ctx, "开始导航到坐标");
    return;
  }

  if (!strcmp(type, "servo")) {
    // 调试直驱：绕过执行板，本板软件 I2C 直接驱动哪吒舵机（逻辑通道 n=0转向/1左(前后)/2右(抬落)/3前(夹爪)）。
    // 直接写原始 pwm（50..250），不过标定限位，用于探机械极限/标定；走 exec::set_servo 同步内部状态。
    int n = params["n"] | -1;
    int p = params["pwm"] | -1;
    if (n >= 0 && n <= 3 && p >= 50 && p <= 250) {
      exec::set_move_cap_ms(0);  // 手动接管轮子/转向：先清 AI move 兜底，防旧时限在写入窗口误停
      exec::set_servo((uint8_t)n, (uint16_t)p);
      // 成功不回执：摇杆/按钮高频下发，状态看 exec_log 即知。
    } else {
      reply_status(doc, reply, reply_ctx, "servo: n=0转向/1左/2右/3前 pwm=50..250(可超标定限位)");
    }
    return;
  }

  if (!strcmp(type, "arm_pose")) {
    // 二连杆 IK：给末端位姿(x=车头系前方cm, h=离地高度cm)，联动算左右两舵机 pwm 一并下发。
    // 校准用：不限制数值范围（可为负/超界），不可达由 exec::arm_pose 可达域检查拦截并回执。
    bool has_x = params["x"].is<float>() || params["x"].is<int>();
    bool has_h = params["h"].is<float>() || params["h"].is<int>();
    if (has_x && has_h) {
      float x = params["x"] | 0.f;
      float h = params["h"] | 0.f;
      exec::set_move_cap_ms(0);  // 手动接管轮子/转向：先清 AI move 兜底，防旧时限误停
      if (!exec::arm_pose(x, h))
        reply_status(doc, reply, reply_ctx, "arm_pose: 目标不可达(xh 超出机械臂可达范围)");
      // 成功不回执：状态看 exec_log 即知。
    } else {
      reply_status(doc, reply, reply_ctx, "arm_pose: 需要 x=车头系前方cm h=离地高度cm");
    }
    return;
  }

  if (!strcmp(type, "motor")) {
    // 调试直驱：绕过执行板，本板直接驱动哪吒单轮电机（隔离执行板是否异常）。
    // 用法 /motor <n=1..4> <a=0..1000> <b=0..1000>；a=正转 b=反转，都 0 即停。
    int n = params["n"] | -1;
    int a = params["a"] | -1;
    int b = params["b"] | -1;
    if (n >= 1 && n <= 4 && a >= 0 && b >= 0 && a <= 1000 && b <= 1000) {
      exec::set_move_cap_ms(0);  // 手动接管轮子/转向：先清 AI move 兜底，防旧时限在写入窗口误停
      nezha::set_motor((uint8_t)n, (uint16_t)a, (uint16_t)b);
      // 成功不回执：摇杆/按钮高频下发，状态看 exec_log 即知。
    } else {
      reply_status(doc, reply, reply_ctx, "motor: 参数需 n=1..4 a,b=0..1000");
    }
    return;
  }

  if (!strcmp(type, "drive")) {
    // 调试直驱：一键发全车四轮前进/后退/停（单条命令保证四轮同时起转）。
    // 用法 /drive <speed=-1000..1000>；>0 前进 <0 后退 0 停车。
    int spd = params["speed"] | 0;
    if (spd < -1000 || spd > 1000) {
      reply_status(doc, reply, reply_ctx, "drive: speed 需在 -1000..1000");
      return;
    }
    int S = spd < 0 ? -spd : spd;
    uint16_t u = (uint16_t)S;
    bool rev = spd < 0;
    // 手动接管轮子/转向：先清 AI move 兜底，防旧时限在写入窗口误停
    exec::set_move_cap_ms(0);
    // 轮map：M1左后 M2右后 M3右前 M4左前；左轮 a 正前，右轮 b 正前。
    // 前进：M1(S,0) M2(0,S) M3(0,S) M4(S,0)；后退：四轮 a/b 对调。
    nezha::set_motor(1, rev ? 0 : u, rev ? u : 0);
    nezha::set_motor(2, rev ? u : 0, rev ? 0 : u);
    nezha::set_motor(3, rev ? u : 0, rev ? 0 : u);
    nezha::set_motor(4, rev ? 0 : u, rev ? u : 0);
    // 成功不回执：摇杆/按钮高频下发，状态看 exec_log 即知。
    return;
  }

  if (!strcmp(type, "spin")) {
    // 原地转向（普通四轮滑移式，无需特殊轮子）：靠左/右侧轮反向拖胎绕中心旋转。
    // 前提：转向舵回正（steer 居中），前轮保持直行位。
    // dir=+1 左进右退 / -1 左退右进 / 0 停；speed=单车轮 pwm 0..1000（默认 500）。
    // 落地统一走 exec 保持马达映射与内部状态一致（持续判定/回正）。
    int dir = params["dir"] | 0;
    int spd = params["speed"] | 500;
    if (dir < -1 || dir > 1 || spd < 0 || spd > 1000) {
      reply_status(doc, reply, reply_ctx, "spin: dir=±1/0, speed=0..1000");
      return;
    }
    exec::act("spin", params);
    // 成功不回执：摇杆/按钮高频下发，状态看 exec_log 即知。
    return;
  }

  reply_status(doc, reply, reply_ctx, "未知指令类型");
}

void cmd::apply_network() {
  net::reconnect();  // 在线重建 STA，不整板重启（BLE 保活，配网后无需重连）
  blog::logf(blog::NET, "已在线上网生效（未重启）");
}

bool cmd::streaming() { return g_streaming; }

void cmd::set_streaming(bool on) { g_streaming = on; }
