YangQwQ/Stm32VisionSenseCar/Stm32-Vision/src/ai/ai_prompt.cpp

#include "src/ai/ai_prompt.h"
#include "src/net/config.h"      // cfg::ai_model
#include "src/ai/tools/tool.h"   // ai::tools_schema(请求尾的工具声明)
#include <array>                 // 编译期转义(std::array)

// ---------------- AI 请求构建 ----------------

// JSON 字符串转义: 引号/反斜杠 + 控制字符(\n \r \t 等)。模型文本(工具参数/名称)可能含换行, 裸发会让云端
// 400 "invalid unicode/character"; 中文等多字节字节序原样透传(UTF-8 合法)。
static void esc_append(PsaBuf& b, const char* s) {
  b.put('"');
  const unsigned char* p = (const unsigned char*)s;
  while (*p) {
    unsigned char ch = *p;
    if (ch == '"' || ch == '\\') { b.put('\\'); b.put((char)ch); p++; }
    else if (ch == '\n') { b.put('\\'); b.put('n'); p++; }
    else if (ch == '\r') { b.put('\\'); b.put('r'); p++; }
    else if (ch == '\t') { b.put('\\'); b.put('t'); p++; }
    else if (ch < 0x20) { char h[7]; snprintf(h, sizeof(h), "\\u%04X", ch); b.put(h); p++; }
    else if (ch < 0x80) { b.put((char)ch); p++; }
    else {
      // 多字节 UTF-8: 校验续字节, 非法/残缺则替换为 '?'(防云端判 invalid unicode code point, 400)
      int need;
      if (ch >= 0xC2 && ch <= 0xDF) need = 1;
      else if (ch >= 0xE0 && ch <= 0xEF) need = 2;
      else if (ch >= 0xF0 && ch <= 0xF4) need = 3;
      else { b.put('?'); p++; continue; }              // 非法首字节
      bool ok = true;
      for (int i = 1; i <= need; i++)
        if (!(p[i] >= 0x80 && p[i] <= 0xBF)) { ok = false; break; }
      if (ok) { for (int i = 0; i <= need; i++) b.put((char)p[i]); p += need + 1; }
      else { b.put('?'); p++; }                        // 残缺/非法序列: 单字节替换
    }
  }
  b.put('"');
}

// 图块前缀/后缀: base64 数据夹在中间, 故拆成两段静态文本, 数据由 PieceStream 边发边编码。
// 全幅图走 low(只 fit 进一张 512×512=85 token, VGA 下几乎无损且省 prefill); 放大/精判图走 high。
// DeepSeek 只认 low/high/original/auto, medium 会被 422 拒。
static const char IMG_PRE[] = "{\"type\":\"image_url\",\"image_url\":{\"url\":\"data:image/jpeg;base64,";
static const char IMG_SUF_LOW[]  = "\",\"detail\":\"low\"}}";
static const char IMG_SUF_HIGH[] = "\",\"detail\":\"high\"}}";

// base64 第 oi 个输出字符。无状态: 由输入直接算出, 故 rewind 重播的字节必然一致(不需要留编码状态)。
static char b64_at(const uint8_t* in, size_t n, size_t oi) {
  static const char T[] = "ABCDEFGHIJKLMNOPQRSTUVWXYZabcdefghijklmnopqrstuvwxyz0123456789+/";
  size_t i = (oi >> 2) * 3, k = oi & 3;
  uint8_t a = i < n ? in[i] : 0;
  uint8_t b = (i + 1) < n ? in[i + 1] : 0;
  uint8_t c = (i + 2) < n ? in[i + 2] : 0;
  uint32_t v = ((uint32_t)a << 16) | ((uint32_t)b << 8) | c;
  if (k == 0) return T[(v >> 18) & 63];
  if (k == 1) return T[(v >> 12) & 63];
  if (k == 2) return (i + 1) < n ? T[(v >> 6) & 63] : '=';
  return (i + 2) < n ? T[v & 63] : '=';
}

// 屏幕像素 → 地面坐标(单应投影)由独立模块 ground_proj 负责: ground::screen_to_world。

// 请求体尾部的工具声明(agent 循环): `car` 批量动作 / `mem` 物体记忆(记录/删除/查询) / `task` 任务记账 /
// `goal` 目标与收尾 / `look` 取画面 / `say` 对用户说话 / `compact` 压缩历史。
// 与上面的 system 提示词是一套东西的两半: 结构(键名/枚举)在这里, 行为与判据在提示词里;
// 改键名/枚举必须两处同时改(现在同文件, 改起来方便)。
// 取值合法性不靠这里的 schema(没用 strict: DeepSeek 的 strict 要求所有属性 required+additionalProperties,
// 与我们"car 的键基本全可选"冲突), 仍由 registry.cpp 各 parse 兜底校验。
// 放在请求体尾部(messages 之后): 前缀缓存吃的是 system+历史那一段, 工具声明放后面不破坏它。
// ⚠️ 尾巴上的 "tool_choice":"auto" 是风险点: DeepSeek 官方接入说明称 V4 思考模式不接受 tool_choice,
// 严格时会 400。当前实测能过, 故先留着; 若哪天开始 400, 第一件事就是摘掉它。
const char* ai::tools_schema() {
  return R"TOOLS("tools":[
{"type":"function","function":{"name":"car","description":"对小车/机械臂下达一批动作。\n每轮至少调用一个工具, 同一种工具最多一次, 只写本轮要用的即可。","parameters":{"type":"object","properties":{
"move":{"type":"object","description":"轮子, 五选一且每次只用一个, 方向已含在 type 里: forward 前进 / backward 后退 → value 填距离 cm, 前进前先确保目标对准; spin_left 原地左转 / spin_right 原地右转 → value 填角度;\n approach 靠近 → target(observe时使用的名字, 缺省=最近目标, 如果还未observe请先observe); 一般在初次靠近目标时使用, 会在适当距离自动停下, 目标过近时可能会大幅转向","properties":{
"type":{"type":"string","enum":["forward","backward","spin_left","spin_right","approach"]},

"value":{"type":"integer","description":"forward/backward: 移动距离, 单位cm(可省略, 默认8); spin_left/spin_right: 旋转角度(可省略, 默认30)"},
"target":{"type":"string","description":"approach: 记忆里的目标名(可省略, 缺省=最近目标)"}}},

"arm":{"type":"object","description":"机械臂/夹爪, 每次只用一个 type(x/h 仅 pose 有效, 其它时候不写):\nlow 夹爪降到贴地准备位; 目标在画面上不处于[左指]上方时需先后退, 避免压住目标\nraise 抬到高位; 压住物体或物体可能在车头近处时用, 找回目标后应先旋转对准\ngrasp 合爪并抬臂(车不动, 只合爪; 目标已对准且够近时用); 只是合爪, 整套「逼近+对准+夹取」请优先用 auto_grasp 工具\nclip / release 合上 / 松开夹爪; 需要手动控制夹取流程时用\nplace_done 放置收尾一段式: 松爪→抬臂→后退离开放置点→收臂折叠, 一个调用完成最终放置, 需要放置物体时使用, 不必再自己后退和抬臂收臂\nfold 收臂折叠, 避免遮挡; 疑似压住物体或机械臂遮挡视野时用\npose 移动夹爪到指定坐标","properties":{
"type":{"type":"string","enum":["low","raise","fold","grasp","clip","release","pose","place_done"]},"x":{"type":"number","description":"pose: 轴前 cm(7~13)(可省略)"},"h":{"type":"number","description":"pose: 离地 cm(1~12)(可省略)"}}},

"light":{"type":"object","description":"车灯: front=前灯(白色, 照亮/判断颜色用它) / back=尾灯(红) / vibe=氛围灯(深蓝)","properties":{"kind":{"type":"string","enum":["front","back","vibe"]},"on":{"type":"boolean","description":"开启/关闭"}}}
}}}},

{"type":"function","function":{"name":"auto_grasp","description":"自动夹取: 板端自己完成降臂、旋转对准、逼近、合爪整套流程\n目标需要在画面里清晰可见未被遮挡, 如果被夹爪等部分遮挡可先适当后撤; 画框要能够完全包住目标并且不会把夹爪或机械臂结构也框入范围, 同时尽可能小, 控制在0.125宽度以内, 避免使其跟踪到错误目标; 如果提示区域太素无法跟踪, 可以先approach靠近到能看得更清楚的位置; 如果\n回执带结果和原因, 但是提示可能夹住时还是需要你自行确认情况; 仅在夹取物体时使用, 靠近某个位置请用approach","parameters":{"type":"object","properties":{
"x":{"type":"number","description":"目标中心在画面上的px坐标 0~1"},
"y":{"type":"number","description":"目标中心在画面上的py坐标 0~1"},
"w":{"type":"number","description":"目标画面框宽 0~1"},
"h":{"type":"number","description":"目标画面框高 0~1"},
"name":{"type":"string","description":"目标名(可省略)"}}
}}},

{"type":"function","function":{"name":"mem","description":"物体记忆与小车姿态: 记录(observe)/删除(delete)目标位置, 或查询当前记忆。\n只给 observe/delete 时按给的内容返回执行回执; 什么都不给(或空对象)=查询小车朝向与已记忆的物体坐标, 寻找或确认先前记录过的物体的方位时使用","parameters":{"type":"object","properties":{
"observe":{"type":"array","description":"记录/刷新物体记忆的位置(即查询结果里的物体位置), 查看新画面且目标可见时可用用于检查位置, 在检查物体记忆前建议先observe; px/py 统一填物体底部中心在最新画面上的屏幕坐标(放大图也照常填 0~1, 程序会自动换算); 请勿对着用户参考图或回看的旧图使用observe","items":{"type":"object","properties":{"name":{"type":"string"},"px":{"type":"number"},"py":{"type":"number"}}}},
"delete":{"type":"array","description":"删除已记忆的物体; 发现重复记录同一物体、记忆已无用、或本地跟踪锁错了东西时可用, 删掉正在跟踪的目标会顺带停止跟踪","items":{"type":"string"}}
}}}},

{"type":"function","function":{"name":"task","description":"任务记账(纯记录, 不含动作): note 记要点 / todo 重写任务列表 / done 标记已完成项。","parameters":{"type":"object","properties":{
"note":{"type":"string","description":"记录目标特征(如大小、形状), 避免后续误认, 位置尽量不记; 也可备注用户发送图片的内容; 可以作为当前会话的长期记忆"},
"todo":{"type":"array","description":"重写整个任务列表, 需要分步任务时用","items":{"type":"string"}},
"done":{"type":"array","description":"标记第N项完成(首项为1, 可同时标多项; 取消标记需重写任务列表)","items":{"type":"integer"}}
}}}},

{"type":"function","function":{"name":"goal","description":"任务目标与收尾。set 更新最终目标; finish 结束本次任务(结束语或总结先用 say 发送)。","parameters":{"type":"object","properties":{
"set":{"type":"string","description":"更新当前任务的最终目标, 目标需要变更时使用"},
"finish":{"type":"string","enum":["done","fail","wait"],"description":"结束本次任务: done=已完成 / fail=目标已不可能达成 / wait=中止并等待用户输入(用户未回复则继续原任务)"}
}}}},

{"type":"function","function":{"name":"look","description":"查看最多两个画面: 新拍一张当前全幅画面, 或回看先前给过的画面, 最多两张; 可回看的图片会显示在结果里的「当前可查看图片」编号与先前工具调用结果中的占位符对应; 历史消息中的旧图会退化成占位符","parameters":{"type":"object","properties":{
"zoom":{"type":"boolean","description":"新拍一张当前实景画面, 并选择是否为放大版, 放大画面只能看见(0.25,0.25)至(0.75,0.75)的中央区域; 放大画面仅在检查[目标物体]是否可以被夹取时用; 一般情况下用全幅画面即可, 需要确认夹爪附近情况再放大"},
"image":{"type":"array","description":"回看先前给过的画面(含用户发送的参考图), 填编号数组","items":{"type":"integer"}}
}}}},

{"type":"function","function":{"name":"compact","description":"压缩历史上下文: 对话轮数变多时(状态块会提醒)用一段摘要总结此前进展; 调用后更早的对话被清空, 只留这条摘要开始的后续部分。目标/任务列表/任务笔记/物体记忆/车位姿都不受影响, 但可回看的旧画面(含用户参考图)会一并清空, 要看东西需重新 look","parameters":{"type":"object","properties":{
"summary":{"type":"string","description":"用中文写给之后的自己看: 摘要只写已确认事实、后续步骤、需要注意的事或总结出的经验, 不写未证实的猜测; 清空后你只能靠这段文字回忆之前做过什么"}},
"required":["summary"]}}},

{"type":"function","function":{"name":"say","description":"对用户说话, 也可用来回答用户的提问; 有值得汇报的进展、结论或要解释的事时使用; 没什么可说可以不使用, 认为没有必要的话允许不说话, 但是建议在每个任务阶段, 明确接下来执行动作时说一次接下来要干嘛; 执行finish前必须调用, 可以总结也可以回复用户","parameters":{"type":"object","properties":{
"text":{"type":"string","description":"要说的话, 一句话, 用户可见; 执行任务时用于写接下来准备干什么等"}},
"required":["text"]}}}
],"tool_choice":"auto")TOOLS";
}

// ---------------- 编译期 JSON 转义(静态文本如系统提示词) ----------------
// 返回内容字节(不含外层引号); a 按最坏 2 倍预留(每个字符都需转义), len 为实际长度。
// 只覆盖 " \ \n \r \t 五个字符(提示词无其它控制符), 与 esc_append 的处理保持一致。
template <size_t N>
struct Esc { std::array<char, 2 * N> a{}; size_t len = 0; };

template <size_t N>
constexpr Esc<N> esc_make(const char (&s)[N]) {
  Esc<N> e{};
  for (size_t i = 0; s[i]; i++) {
    char c = s[i];
    if (c == '"' || c == '\\') { e.a[e.len++] = '\\'; e.a[e.len++] = c; }
    else if (c == '\n') { e.a[e.len++] = '\\'; e.a[e.len++] = 'n'; }
    else if (c == '\r') { e.a[e.len++] = '\\'; e.a[e.len++] = 'r'; }
    else if (c == '\t') { e.a[e.len++] = '\\'; e.a[e.len++] = 't'; }
    else e.a[e.len++] = c;
  }
  return e;
}

// 系统提示词原文 —— 编译期转义成可直接上线的字节, 省掉每轮全量转义(~2.5KB 的重复工作)。
static constexpr char kSysSrc[] = R"PROMPT(
你是Caris, 一个带猫娘气质的小车驾驶助手。你的首要目标是准确、高效地帮助用户, 猫娘语气只是轻微调味, 不能影响信息传达

# 人设
##【身份】
	- 名字: Caris
	- 自称: 我; 偶尔“本喵”, 每10句不超过1次
	- 称呼用户: 默认用“你”
	- 关系: 亲近但不过度黏人，像熟悉的搭档

##【语气】
	- 默认自然、简洁、直接
	- 猫娘感来自轻微语气词、少量猫相关动作比喻, 而不是每句加"喵"

##【行为】
	- 先给答案，再带语气。信息优先，角色其次
	- 用户认真时保持可靠；用户闲聊时可稍微放松
	- 不因角色扮演拒绝任务或降低质量
	- 使用简体中文发言, 思考的预算有限, 不必过于纠结

# 规则
	- 全程用工具完成任务, 工具的使用方式见工具描述
	- 存在冲突时的遵循优先级: 用户发言 > 系统规则 > 每帧图片画面 > 系统坐标提示
	- 每轮最后一条工具结果的尾部会附小车及机械臂状态与当前的任务目标/任务列表/任务笔记, 据此了解进度与当前姿态
		+ 状态形如"小车: [停止/前进/后退/原地左转/原地右转] | 夹爪: [clip/release] 姿态: [自由/low/raise/grasp/fold] 位置: [(x, h)坐标] [已伸最远/已缩最近/已触底/已触顶]"
		+ 姿态"自由"= 当前为手动控制夹爪位置状态; 已伸最远/已缩最近/已触底/已触顶 = 该方向已到头, 再往同方向动作不会有变化
		+ car 结果开头的指令回显是你上一条动作的原文(forward 10cm / spin_left 45° / arm grasp), 用来核对你下的指令是否真的落地

# 工作流程
	1. 确认目标: 收到用户消息后, 确认当前目标以及是否需要更新任务目标和任务列表
	2. 场景理解: 根据先前情况确认自身当前状态, 选择是否需要查看画面, 以及确认大致行动流程, 图片对比时总以新画面的状态为准
	3. 行为决策: 根据正在执行的任务和当前状态, 选择合理的动作, 注意考虑动作决策是否合理

# 画面相关定义及可见内容
	- 屏幕坐标系: 描述物体在画面上的位置时使用。(px, py)为基于画面的归一化坐标, 左上(0,0), 右下(1,1)。小车朝向在[画面上]表现为从(0.625,1)朝向(0.375,0), 画面中心点约小车正前14cm
	- 车头坐标系: 以车头为原点, 单位为cm的小车局部坐标系。车正前为x轴正向, 车正右为y轴正向, h 为离地高度。系统表示物体记忆坐标用(x,y), 表示夹爪位置用(x,h)
	- 旋转时画面大致以底部中心为圆心旋转, 车及机械臂的部分保持不动, 可以借此判断旋转是否会撞到物体, 物体在[左指]左侧时左转对准, 处于右侧时右转对准
	- 画面上总是可见夹爪左指, 夹爪左前端向左上伸出的黑色细棍的平直段为[左指], 长约2.5cm, 在画面上可视为以其左上角为顶点的0.03x0.06的矩形(尺寸已根据画面归一化), 强调[左指]时, 只考虑其与物体在画面上的上下左右关系, 不考虑其朝向
	- 机械臂和夹爪部分只存在黑色及纸质的暗黄色部分, 以及一些银白色的螺丝, 不存在其它颜色, 除此之外, 车体上的左右各有一个带有紫色标签的部分, 其余你看到的颜色都不来自小车和机械臂
	- [夹爪前端]: 一个画面上大致以[左指]左上角为起点的0.125x0.125的方形(即[夹爪])的上半部分 (尺寸已根据画面归一化)
	- 画面右下可见小车主体的前半部分, 顶部的[机械臂结构]连接至夹爪, 该机械臂结构不属于[夹爪]的一部分
	- [左指]右边的纯黑色立方体是夹爪的舵机, 右指被其遮挡。左右指在松爪时两指间距宽约3cm, 同[夹爪]在画面上的宽度

# 状态判定
	- 物体对准及夹取判定:
		+ if (先前判定为[夹住] && 期间未松爪): 已[夹住]
		+ elif (需要夹取目标 && 目标物体未进入[夹爪前端]): 若夹爪下没有其它物体, 先arm low一次到位方便对准(不要分多次逐步降臂)
		+ else:
			* switch(目标清晰可见 && 目标在画面上处于[左指]的):
				- case 正上方:
					+ if (arm处于low姿态 && 画面上处于[夹爪前端]左半部分的正上方): 已[对准], 继续小幅前进
					+ else: 未[对准], 需要旋转对准
				- case 水平正右方(需要重合部分接近左指一半高):
					+ if ([目标物体]与左指接触 && 目标物体进入[夹爪前端]):
						* if (夹爪高度与[目标物体]所在高度不匹配): 可以先arm low, 然后不断抬高夹爪高度并用一两厘米的前进量尝试宽度是否匹配, 比如从(8, 4)的夹爪高度不断试到(8, 10)
						* elif (夹爪未合): 可以grasp夹取
						* elif (夹爪已合 && (前后画面对比后, 确认物体跟随夹爪移动 || 旋转或抬落机械臂时仍处于当前状态)): 已[夹住][目标物体]
				- case 正下方:
					+ if (arm低于5): (夹爪是否已合)?夹爪[过低]:目标物体[过近]
					+ else: 若已[夹住]物体, 且目标指的是放置点, 那么需要先稍微降低机械臂高度, 若此时机械臂高度已低于5cm, 那么可以放下物体
				- case 下方:
					+ if (前后移动或旋转时目标位置不变): 此时目标大概率被卡住, 需要抬臂并后退
				- default: 可能为 偏左/偏右/过近 , 需要先对准

# 行为建议
	- 夹爪高度低于5cm时, 如果应该固定不动的东西, 如放置点一直跟随移动, 需要注意抬臂并绕开
	- look的使用时机:
		+ 在 grasp或者clip之前先检查物体是否在合适的位置, 同时夹取后也可以方便对比前后帧确认是否夹住, 其它单步动作通常情况下无需带上上一帧
		+ 在观察完一次画面后, 下次查看可以在一系列动作结束后, 比如执行完 前进, 右转, 降臂 后再带上先前帧确认当前位置
	- 观察或搜寻目标时: 
		+ 如果机械臂高度较高造成遮挡可以先arm low或fold, 如果arm low之后物体被遮挡, 此时可能距离太近, 建议适当后退
		+ 可原地旋转搜索目标, 每步旋转不超过60度以免错过, 期间可以用observe标注一些开阔地带的位置, 旋转一周后仍未发现目标可前往开阔地带重新搜索
	- 需要夹取物体时:
		+ 优先使用auto_grasp夹取物体, 手动对准并不可靠
		+ 如果夹爪高度大于2且[左指]正下方无其它物体, 那么先arm low一次到位方便对准和避免遮挡(不要分多次逐步降臂)
		+ 如果上一轮执行了后退, 那么本轮应当旋转对准而不是重新前进, 重新前进不能帮助你对准
		+ 微调对准先用比较接近的角度, 如果过头再逐轮砍半角度反向转
		+ grasp或者clip后必须检查物体是否可见以及被[夹住]
		+ 对准判定只是辅助, 实际需要对准夹爪开口, 但是在arm low状态下对准开口时目标基本处于正上方; 近场夹取循环=先arm low一次到位 → 旋转对准 → 前进与旋转对准交替进行, 直到目标进入[夹爪前端]且距离合适, 最后grasp
	- 需要放置物体时:
		+ 可以在抬高物体的情况下, 到达放置点后再降臂、松爪以及后退收臂, 避免物体掉落后滚远, 同时后退或者右转方便确认结果
		+ 如果放置点的大小距离和方向都不好准确确定, 那么可以不断小步靠近同时微调对准, 机械臂抬得够高的情况下只用考虑会不会撞到车头
		+ 因为相机固定于小车左后方, 因此左侧近处视野较好, 近距离操作对准放置点时先右转将其转到左侧再调整可能会比较轻松
		+ 如果放置区域已经贴近车头但是没有对准, 那么可以根据目标位置在画面左侧还是右侧选择旋转而不是继续前进, 避免压过放置区域的边界, 比如盒子的边框等
		+ 最好把目标放置区域的中心位置视为放置点, 避免对准边界时物体滚出区域
	- 当用户发送图片时: 请注意及时查看, 需要的话注意更新任务备注, 避免图片在 compact 之后无法查看
)PROMPT";
static constexpr auto kSysEsc = esc_make(kSysSrc);

// ---------------- 碎片流实现 ----------------
Piece& PieceList::push() {
  if (n == cap) {
    int nc = cap ? cap * 2 : 32;
    Piece* np = (Piece*)heap_caps_realloc(it, (size_t)nc * sizeof(Piece), MALLOC_CAP_SPIRAM);
    if (!np) { ok = false; return scratch; }
    it = np; cap = nc;
  }
  Piece& pc = it[n++];
  pc.kind = Piece::TEXT; pc.p = nullptr; pc.n = 0; pc.out_n = 0; pc.own = false;
  return pc;
}

void PieceList::add_text(const char* s, size_t len) {
  Piece& pc = push();
  if (!ok) return;
  pc.p = (const uint8_t*)s; pc.n = len; pc.out_n = len;
  total += len;
}

void PieceList::add_b64(const uint8_t* jpg, size_t len) {
  Piece& pc = push();
  if (!ok) return;
  pc.kind = Piece::B64; pc.p = jpg; pc.n = len;
  pc.out_n = ((len + 2) / 3) * 4;
  total += pc.out_n;
}

// 接管 b 的缓冲: 免掉一次拷贝。b 置空后其析构不再释放(否则 double free)。
void PieceList::take(PsaBuf& b) {
  if (!b.ok) { ok = false; return; }
  if (!b.p) return;
  Piece& pc = push();
  if (!ok) return;
  pc.p = (const uint8_t*)b.p; pc.n = b.len; pc.out_n = b.len; pc.own = true;
  total += b.len;
  b.p = nullptr; b.len = 0; b.cap = 0;
}

PieceList::~PieceList() {
  for (int i = 0; i < n; i++) if (it[i].own) free((void*)it[i].p);
  free(it);
}

int PieceStream::read() {
  uint8_t c;
  return readBytes((char*)&c, 1) == 1 ? (int)c : -1;
}

int PieceStream::peek() {
  if (done_ >= l_.total || idx_ >= l_.n) return -1;   // idx_ 越界: 碎片数与 total 不一致时别读野指针
  const Piece& pc = l_.it[idx_];
  return pc.kind == Piece::TEXT ? (int)(uint8_t)pc.p[off_] : (int)(uint8_t)b64_at(pc.p, pc.n, off_);
}

size_t PieceStream::readBytes(char* buf, size_t len) {
  size_t got = 0;
  while (got < len && idx_ < l_.n) {
    const Piece& pc = l_.it[idx_];
    size_t avail = pc.out_n - off_;
    size_t k = (len - got < avail) ? (len - got) : avail;
    if (pc.kind == Piece::TEXT) {
      memcpy(buf + got, pc.p + off_, k);
    } else {
      for (size_t j = 0; j < k; j++) buf[got + j] = b64_at(pc.p, pc.n, off_ + j);
    }
    got += k; off_ += k; done_ += k;
    if (off_ == pc.out_n) { idx_++; off_ = 0; }
  }
  return got;
}

// 请求尾(静态字面量, 直接引用)。
static const char TAIL_CFG[] = R"CFG(],"max_tokens":8192,"reasoning_effort":"low",)CFG";

// 组请求碎片(入参见 BodyReq)。消息通道: system(规则) → 历史环 → 尾部(状态块挂最新工具结果 / user 画面)。
// 一条 JSON message 一块 TEXT 碎片(元素之间夹 "," 分隔碎片); 带图的消息在 base64 处插入 B64 碎片。
// 任务目标/列表/笔记不单独成消息: 由 state_block 每轮现拼后挂到最新一条工具结果尾部(不落历史, 不重复)。
void build_body(PieceList& l, const BodyReq& r) {
  // 头部: 模型名 + messages 开头 + system 消息(提示词直接引用编译期转义好的静态字节)
  PsaBuf head;
  head.put("{\"model\":");
  esc_append(head, cfg::ai_model().c_str());
  head.put(",\"messages\":[{\"role\":\"system\",\"content\":\"");
  l.take(head);
  l.add_text(kSysEsc.a.data(), kSysEsc.len);
  l.add_text("\"}", 2);
  // ---- 历史回合(tool 协议): 每回合 1 条 assistant(tool_calls) + 每个调用 1 条 tool 结果; 用户发言是 user ----
  // "一次性提示"要挂在本回合**最新一条 tool 结果**尾部: 先定位它(没有 tool 结果时才落到尾部画面文本)。
  const HistCall* last_tc = nullptr;
  for (int ti = 0; ti < r.turn_n; ti++) {
    const HistTurn& tn = r.turns[ti];
    if (tn.chat) continue;
    for (int ci = 0; ci < tn.ncall; ci++) last_tc = &tn.calls[ci];
  }
  for (int ti = 0; ti < r.turn_n; ti++) {
    const HistTurn& tn = r.turns[ti];
    if (tn.chat) {   // 用户消息: 独立 user 文本消息, 不参与 tool 配对
      PsaBuf msg;
      msg.put(",{\"role\":\"user\",\"content\":");
      esc_append(msg, tn.text ? tn.text : "");
      msg.put("}");
      l.take(msg);
      continue;
    }
    if (tn.ncall <= 0) continue;
    // assistant: 一条消息带该回合全部 tool_calls(⚠️ arguments 是**字符串**, 必须转义; content 为 null)。
    // id/name 也走 esc_append: 它们原样来自模型(`tool_call_id`/`function.name`), 未知工具的名字可能带引号,
    // 裸拼会让整包 JSON 非法、被云端 400 拒掉(正是本次改造要消灭的那类静默失效)。
    // reasoning_content 必须原样回传(DeepSeek thinking 模式带 tools 时的要求): 缺了模型就看不到自己
    // 上轮怎么想的, 只能每轮从工具结果重新起推。带 tool_calls 的 assistant 消息**恒写**该字段(无思考时空串),
    // 否则某轮恰好没思考时字段缺失, 云端按"回传不全"400。
    {
      PsaBuf msg;
      msg.put(",{\"role\":\"assistant\",\"content\":null,\"reasoning_content\":");
      esc_append(msg, tn.reasoning ? tn.reasoning : "");
      msg.put(",\"tool_calls\":[");
      for (int ci = 0; ci < tn.ncall; ci++) {
        const HistCall& hc = tn.calls[ci];
        if (ci) msg.put(',');
        msg.put("{\"id\":"); esc_append(msg, hc.id ? hc.id : "");
        msg.put(",\"type\":\"function\",\"function\":{\"name\":"); esc_append(msg, hc.name ? hc.name : "");
        msg.put(",\"arguments\":");
        esc_append(msg, hc.args ? hc.args : "{}");
        msg.put("}}");
      }
      msg.put("]}");
      l.take(msg);
    }
    // 每个调用一条 tool 结果。图只对"最新一张实图"注入字节, 更早的按全局编号渲染成占位说明。
    for (int ci = 0; ci < tn.ncall; ci++) {
      const HistCall& hc = tn.calls[ci];
      bool is_last = (&hc == last_tc);
      PsaBuf tt;
      if (hc.img_n > 0) {   // 该结果当时带了图: 标出各图的全局编号(ImageN); 字节没了就明说, 免得据空想画面判位置
        // 先把编号列表拼好再决定要不要输出"画面(...)": 编号可能全为 0(未发号), 那时输出空括号反而误导。
        char ids[64];
        ids[0] = 0;
        int wrote = 0;
        for (int k = 0; k < (int)hc.img_n && k < 2; k++) {
          if (!hc.img_id[k]) continue;
          int used = (int)strlen(ids);
          snprintf(ids + used, sizeof(ids) - used, "%sImage%u", wrote++ ? ", " : "", (unsigned)hc.img_id[k]);
        }
        if (wrote) {
          tt.put("画面(");
          tt.put(ids);
          if (hc.imgs[0].p) tt.put("): ");
          else tt.put("): 字节已省略, 勿据此判位置; ");
        }
      }
      if (hc.result && hc.result[0]) tt.put(hc.result);
      if (is_last && r.state_block && r.state_block[0]) tt.put(r.state_block);
      if (is_last && r.tail_hint && r.tail_hint[0]) { tt.put(" 注意: "); tt.put(r.tail_hint); }
      // 有效图列表(最多两张)
      const ImgRef* vis[2]; int nv = 0;
      for (int k = 0; k < (int)hc.img_n && k < 2; k++)
        if (hc.imgs[k].p && hc.imgs[k].n) vis[nv++] = &hc.imgs[k];
      if (nv == 0) {   // 无图: content 是纯字符串
        PsaBuf msg;
        msg.put(",{\"role\":\"tool\",\"tool_call_id\":");
        esc_append(msg, hc.id ? hc.id : "");
        msg.put(",\"content\":");
        esc_append(msg, tt.p ? tt.p : "");
        msg.put("}");
        l.take(msg);
      } else {         // 带图: content 走内容块数组, 图块在 base64 处切开插入 B64 碎片
        PsaBuf pre;
        pre.put(",{\"role\":\"tool\",\"tool_call_id\":");
        esc_append(pre, hc.id ? hc.id : "");
        pre.put(",\"content\":[{\"type\":\"text\",\"text\":");
        esc_append(pre, tt.p ? tt.p : "");
        pre.put("},");
        pre.put(IMG_PRE);
        l.take(pre);
        for (int k = 0; k < nv; k++) {
          l.add_b64(vis[k]->p, vis[k]->n);
          PsaBuf sep;
          sep.put(vis[k]->hi ? IMG_SUF_HIGH : IMG_SUF_LOW);
          if (k + 1 < nv) { sep.put(","); sep.put(IMG_PRE); }   // 后面还有图
          else sep.put("]}");                                   // 收掉 content 数组与消息对象
          l.take(sep);
        }
      }
    }
  }
  // 尾部 user 画面: 首轮/本回合没有 look 时才由程序注入(有 look 的回合图在那条 tool 结果里)。
  if (r.use_frame) {
    PsaBuf ut;
    if (r.frame_note && r.frame_note[0]) ut.put(r.frame_note);
    ut.put(" ");   // 与图块之间留一个空格, 读起来不粘连
    // 首轮没有 tool 结果: 状态块与一次性提示只能挂在这条画面文本上, 否则会丢
    if (!last_tc && r.state_block && r.state_block[0]) ut.put(r.state_block);
    if (!last_tc && r.tail_hint && r.tail_hint[0]) { ut.put(" 注意: "); ut.put(r.tail_hint); }
    PsaBuf pre;
    pre.put(",{\"role\":\"user\",\"content\":[{\"type\":\"text\",\"text\":");
    esc_append(pre, ut.p ? ut.p : "");
    pre.put("}");
    if (r.frame.p && r.frame.n > 0) {
      pre.put(",");
      pre.put(IMG_PRE);
      l.take(pre);
      l.add_b64(r.frame.p, r.frame.n);
      PsaBuf suf;
      suf.put(r.frame.hi ? IMG_SUF_HIGH : IMG_SUF_LOW);
      suf.put("]}");
      l.take(suf);
    } else {
      pre.put("]}");
      l.take(pre);
    }
  }
  // 请求尾: 关掉 messages 数组 + max_tokens/思考档 + 工具声明(messages 之后, 不破坏前缀缓存)。
  l.add_text(TAIL_CFG, sizeof(TAIL_CFG) - 1);
  l.add_text(ai::tools_schema(), strlen(ai::tools_schema()));
  l.add_text("}", 1);
}
