YangQwQ/Stm32VisionSenseCar/Stm32-Vision/src/ai/track_mask.h

#pragma once
#include <stdint.h>
// ===== 车身 mask：arm low 姿态下车/机械臂/夹爪所占画面区域（由 armLowMask.png 生成）=====
// 响应图在这些格上被**压死**（-1e30），峰值永远落不进去 ⇒ 锁不到随车固定的臂/夹爪上。
// 只保留 **v>=0.63 以下**（第 30 行起）：上面那团臂架与方块的对准路径在画面上重合，压了必丢目标
// （run6 实测：方块在 (0.598,0.438) 被自己人压掉后跟丢）。下面这片是车身本体，方块到不了。
// ⚠️ 这一段**按抠图的真实轮廓**取，不是矩形：车身下沿左边界在 u≈0.58、到最底才到 u≈0.41。
//    早先用 u>=0.36 的矩形，结果种子在 (0.361,0.74) 时被判种子在车身里 → 整场关掉保护 → 空夹。
// 1=车身。坐标系=整幅归一化 (u,v)，左上为原点。改 mask：重新跑生成脚本覆盖本文件。
namespace carmask {
inline constexpr int COLS = 64, ROWS = 48;
inline constexpr uint8_t GRID[ROWS * COLS] = {
  0,0,0,0,0,0,0,0,0,0,0,0,0,0,0,0,0,0,0,0,0,0,0,0,0,0,0,0,0,0,0,0,0,0,0,0,0,0,0,0,0,0,0,0,0,0,0,0,0,0,0,0,0,0,0,0,0,0,0,0,0,0,0,0,
  0,0,0,0,0,0,0,0,0,0,0,0,0,0,0,0,0,0,0,0,0,0,0,0,0,0,0,0,0,0,0,0,0,0,0,0,0,0,0,0,0,0,0,0,0,0,0,0,0,0,0,0,0,0,0,0,0,0,0,0,0,0,0,0,
  0,0,0,0,0,0,0,0,0,0,0,0,0,0,0,0,0,0,0,0,0,0,0,0,0,0,0,0,0,0,0,0,0,0,0,0,0,0,0,0,0,0,0,0,0,0,0,0,0,0,0,0,0,0,0,0,0,0,0,0,0,0,0,0,
  0,0,0,0,0,0,0,0,0,0,0,0,0,0,0,0,0,0,0,0,0,0,0,0,0,0,0,0,0,0,0,0,0,0,0,0,0,0,0,0,0,0,0,0,0,0,0,0,0,0,0,0,0,0,0,0,0,0,0,0,0,0,0,0,
  0,0,0,0,0,0,0,0,0,0,0,0,0,0,0,0,0,0,0,0,0,0,0,0,0,0,0,0,0,0,0,0,0,0,0,0,0,0,0,0,0,0,0,0,0,0,0,0,0,0,0,0,0,0,0,0,0,0,0,0,0,0,0,0,
  0,0,0,0,0,0,0,0,0,0,0,0,0,0,0,0,0,0,0,0,0,0,0,0,0,0,0,0,0,0,0,0,0,0,0,0,0,0,0,0,0,0,0,0,0,0,0,0,0,0,0,0,0,0,0,0,0,0,0,0,0,0,0,0,
  0,0,0,0,0,0,0,0,0,0,0,0,0,0,0,0,0,0,0,0,0,0,0,0,0,0,0,0,0,0,0,0,0,0,0,0,0,0,0,0,0,0,0,0,0,0,0,0,0,0,0,0,0,0,0,0,0,0,0,0,0,0,0,0,
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
  0,0,0,0,0,0,0,0,0,0,0,0,0,0,0,0,0,0,0,0,0,0,0,0,0,0,0,0,0,1,1,1,1,1,1,1,1,1,1,1,1,1,1,1,1,1,1,1,1,1,1,1,1,0,0,0,0,0,0,0,0,0,0,0,
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
};
inline bool in(float u, float v) {
  int c = (int)(u * COLS); if (c < 0) c = 0; else if (c >= COLS) c = COLS - 1;
  int r = (int)(v * ROWS); if (r < 0) r = 0; else if (r >= ROWS) r = ROWS - 1;
  return GRID[r * COLS + c] != 0;
}
}  // namespace carmask
