YangQwQ/Stm32VisionSenseCar/(commit log)

2026-09-05 first commit - 例程
    [partitions.csv]
2026-09-05 first commit - 制作了基本的ui及相关逻辑，但是无法运行
    [export_presets.cfg, plugin.cfg]
2026-09-05 init: 小车执行板固件工程(阿克曼视觉控制架构)
    - car_firmware: 完整可编译的 STM32 执行板固件工程
    - Control: UART帧协议/CRC/指令分发/阿克曼驱动/里程计/到位判定/机械臂/状态上报
    - Hardware: USART(115200+RXNE)/LED/编码器/底盘/机械臂舵机/PID
    - tools: 宿主单测(UartFrame/Dispatch) 与串口联调脚本 uart_test.py
    - 含架构设计文档与联调前检查清单
    - 排除构建产物/Keil私有文件/测试exe
2026-09-05 feat: 核心功能相关代码
2026-09-05 feat: 蓝牙扫描和连接功能已完成
2026-09-05 feat: 无实际测试下的与板子程序的初次功能对接
    [export_presets.cfg]
2026-09-05 feat: 无实际测试下的与手机APP的初次功能对接
2026-09-05 fix: 修复了部分关键文件不被跟踪的问题
    [export_presets.cfg]
2026-09-06 fix: 初步编译验证语法
2026-09-06 feat: UI样式修改及对接部分改进 - 增大了大部分组件的大小 - 调整了图片编辑功能的工具 - 对接了stm32代码的ai和图传相关部分
2026-09-06 feat: 基础的ai控制模块已完成 - 因为板子还没到所以依旧只有编译验证语法没问题
    [Stm32-Vision.ino, ai_client.cpp, ai_client.h, app_httpd.cpp, ble.cpp, command.cpp, command.h, config.cpp]
2026-09-06 feat: AI功能初步迭代
2026-09-06 feat(执行板): 落地协调方案 P1-1/P1-3，扩展 0x0A 状态帧完成标志与夹爪细化
    - P0-2 周期上报已具备，无需改动
    - P1-1: 新增 car_done/arm_done 完成标志(定距/定角/升降/移爪到位时置位，新指令清0)
    - P1-3: 新增 grip_done(夹爪动作完成)/has_load(是否夹到东西)，经 flag 位上报
    - Status: car_flag bit1=DONE、arm_flag bit0=DONE/bit1=GRIP_DONE/bit2=HAS_LOAD
    - Dispatch: 用 arm_pending 区分机械臂定距完成与夹爪完成，stop 时清除
    - 单测: 增 6 项 P1-1/P1-3 校验，uartframe 24 + dispatch 16 全通过
    - 脚本: uart_test.py 状态帧 flag 人类可读解码
    - 附带: Keil 打开工程自动调整的 IDE 元数据(P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
2026-09-06 feat: UI外观调整 - 上了个比较典的AI喜欢用的深蓝色 - 摇杆功能修复
2026-09-06 feat: 重新划分UI界面, 将蓝牙连接部分分离为单独的页面
2026-09-06 chore: 将代码中的信号连接转移至场景中
2026-09-07 fix: 启动崩溃修复 - 修复了程序启动时的崩溃问题 - 摄像头可能存在硬件故障暂时无法使用
    [app_httpd.cpp, camera.h, wifi_net.cpp]
2026-09-07 feat: 连接相关功能优化 - 蓝牙设备现在会边扫描边显示而不是在扫描结束后统一显示 - 配置部分现已支持持久化 - ai配置已加入配置面板内
2026-09-07 feat: 收到重复指令后不再重复输出 - 对于重复的配置指令，现在也不会强制应用，避免每次收到wifi配置就重启
2026-09-07 feat: 添加了指令补全提示 - 同时修复了全角符号显示异常的问题
2026-09-07 fix: 输入框历史消息栈bug修复 - 修复了按上键时的行为异常问题 - 调整了指令提示的样式
2026-09-07 fix: 修复了文本指令解析为图片帧的bug
2026-09-07 feat: 优化了收到指令时的调试输出
2026-09-07 feat: 优化了连接相关功能及虚拟摇杆功能 - 简化虚拟摇杆机制避免短时间大量发包 - ws状态管理优化
2026-09-07 fix: 修复了AI的调用链路中的基本bug
2026-09-07 fix: 优化了ws断开时的部分ui显示及文字提示 - 同时修改了对于本机的称呼
2026-09-07 feat: 添加了关于页面的部分 - 同时添加了新的设置（自动连接设备和关闭自动连接WS） - 添加了关于本程序的说明部分
2026-09-07 feat(视觉+执行板): 纳入大脑板视觉固件源码，集成 st-flash 烧录，完善 gitignore
    - 新增 Stm32-Vision/：大脑板(ESP32-S3)视觉固件源码(相机/命令/BLE/WiFi/AI客户端/UART)
    - 补入 ArduinoJson 三方库真实内容(此前为嵌套git指针，改为直接入库)
    - project.uvprojx: 烧录切换到外部工具 st-flash(--reset --format ihex)，绕开老Keil对ST-Link兼容问题
    - .gitignore: 排除第三方烧录工具包/压缩包/构建日志
    [partitions.csv]
2026-09-07 feat: 添加了一个用于开启执行板输出转发的指令
2026-09-07 feat(执行板): 状态周期上报去重，数据未变化时不再重复发送
    - Status_SendCar/Status_SendArm 记录上次已发送 payload
    - 本轮数据与上次完全相同时跳过发送，仅事件触发/状态变化时才上报
    - 新增 PayloadChanged 比较函数，更新 last_car/last_arm 缓存
2026-09-07 fix: 修复了执行层和驱动层值范围不一致的问题
2026-09-07 chore: 整理了代码文件 - 移除了不必要的部分 - 扁平化了目录结构 - 补充了ps2遥控功能的切换开关 (在main.c顶部) - 添加了Claude.md
    [partitions.csv]
2026-09-07 feat: 速度控制由原先开环设计更换为pid闭环设计 - 功能切换及参数配置见AckermannDrive.h - 需要实际测试pid参数是否可行
2026-09-07 fix: 处理了编译时的警告
2026-09-08 feat: 添加了清屏功能 - 同时优化了串口转发的显示形式
2026-09-08 feat: 添加了对于执行板的串口转发功能
2026-09-08 chore: 初始化容器仓库
2026-09-08 docs: 文档更新 - 更新了各个部分的文档 - 添加了Readme
2026-09-08 fix[Mobile]: 数个连接相关bug修复 - 修复了自动连接在扫描时点击扫描按钮的行为异常bug - 修复了连接中断提示开回响了的bug - 修复了通信方式由BT切换为WS会提示连接断开的bug
    [export_presets.cfg]
2026-09-08 feat[Vision/Mobile]: 优化了程序的wifi/ble切换逻辑 - 修复了ws连接后不停止蓝牙广播的bug - 修复了wifi配置变更后强行重启设备的问题 - 添加了ws的双端保活 (30s无消息且ping不通则判定为断连)
    [Stm32-Vision.ino, app_httpd.cpp, ble.cpp, command.cpp, command.h, wifi_net.cpp, wifi_net.h]
2026-09-08 refactor[Mobile]: 重构ws/ble模块并合并类似功能 - 因为ws/ble本质都用于数据传递，大部分时候没有区分传输通道，合并模块可以简化逻辑和代码结构 - 同时另一个原因是在某些需要重连的情况手机的行为不太理想
2026-09-08 fix[Mobile]: 修复了对于视频帧和文本帧区分存在问题的bug
2026-09-08 fix[Mobile]: 修复了自动重连时的一些bug - 修复了自动重连时不会自动开启图传的bug - 修复了自动重连可能光扫描蓝牙不连接的bug
2026-09-08 perf[Vision]: 优化了图传的画质 - 主要解决了一下传输画质问题 - 画面方面，修复了运动时残影比较严重的问题
    [camera.cpp, camera.h]
2026-09-09 perf[Vision/Mobile]: 优化了图传的延迟 - 通过优化网络层降低图传延迟 (改用udp传输视频帧)
2026-09-09 style[Mobile]: 部分UI组件外观调整 - 修改了控制按钮的样式 - 修改了图片编辑弹窗的大小 - 移除了配置弹窗中的无用组件
2026-09-09 fix[Mobile]: 修复了手机可能传递错误的ip的bug - 要是手机把非同网段的ip发给板子，可能会因为访问不上而无法建立udp连接
2026-09-09 fix[Vision]: AI功能优化: - 修改了部分模块的缓冲区大小 - 给ai添加了等待工具 - 顺手修复了部分情况下蓝牙广播不恢复的bug - 缩短了wifi重连和ws检测的冷却时间 - 修复了ai请求阻塞图传的bug - ai连接改为长连接，避免反复握手 - 通过将上一帧画面传给ai方便其感知物体运动 - 将部分内存申请转移至psram，避免内存碎片化过于严重 - 修复了ai任务循环异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
    [ai_client.cpp, app_httpd.cpp, ble.cpp, wifi_net.cpp]
2026-09-09 docs: 文档更新
2026-09-09 feat[Mobile/Vision]: 聊天区域相关功能优化 - 添加了新的直接根据ip连接小车的指令 resolve #1 - 优化了指令提示的显示数量和匹配问题 resolve #5 - 添加了单独的图片发送候选区并限制了图片发送数量 resolve #2 - 优化了原有指令(ai, ping) 并移除了snapshot指令 - 修复了图传开启状态下仍一直尝试ping板子的bug
    [ai_client.cpp, ai_client.h, app_httpd.cpp, command.cpp, command.h, ping_svc.cpp, ping_svc.h]
2026-09-10 feat[Vision/Mobile]: ai任务循环优化 - 微调了提示词以优化某些行为倾向 - 优化了手机端对于任务状态的获取及控制
2026-09-10 refactor[Vision/Mobile]: 架构重构 - 因为执行板的问题现已砍掉了执行板的部分改由视觉板直接控制 - 修复并校准了小车的移动控制相关代码，机械臂待校准 - 添加了控制车灯的按钮
    [Stm32-Vision.ino, ai_client.cpp, app_httpd.cpp, command.cpp, command.h, direct_exec.cpp, direct_exec.h, nezha_direct.cpp]
2026-09-10 feat[Vision/Mobile]: 使用二连杆模型优化了机械臂的移动控制
2026-09-10 feat[Vision/Mobile]: 添加了原地转向功能
2026-09-10 feat[Vision/Mobile]: 手机端调试优化 - 添加了新的ai_log指令，用于查看ai详细输出 - 添加了默认的日志输出文件 - 修复了部分指令不能通过蓝牙发送的bug - 修复了原地旋转的方向错误及无法停止bug
    [ai_client.cpp, ai_client.h, command.cpp, command.h, direct_exec.cpp, direct_exec.h]
2026-09-10 feat[Vision]: AI循环优化 - 又移除了传输上一帧的设计 - 调整了循环冷却 - 修复了手动控制未接管操作的bug - 提供了量化的移动和转弯指令
    [ai_client.cpp, command.cpp, direct_exec.cpp, direct_exec.h]
2026-09-12 feat[Vision]: AI提示词调优，状态感知优化 - 优化提示词使AI懂得控制视角（画面方位定义、盲区判定、夹取抬臂验证） - 新增 arm home 收臂指令，避免机械臂遮挡视野；AI 可用 arm_pose 一步到位调夹爪位姿 - AI 自行决定是否携带上一帧画面（carry_prev，供前后对比、按需省开销） - 修复机械臂运动不及预期：末端联动步进替代单舵机步进，修正降序标定表反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
    [ai_client.cpp, app_httpd.cpp, camera.cpp, camera.h, direct_exec.cpp, ping_svc.cpp]
2026-09-12 feat[Mobile]: 添加了图传画面的网格标尺指令
2026-09-13 feat[Mobile/Vision]: AI功能相关改进 - 因为摄像头歪了，稍微矫正了坐标映射 - 修复了全局坐标系对于小车转向的错误计算 - 添加了插话功能 - 修复了手机端中止按钮的行为异常情况 - 修复了原地转向不检查转向舵状态的问题
    [ai_client.cpp, ai_client.h, command.cpp, direct_exec.cpp]
2026-09-13 fix[Vision]: 校准了机械臂的运动
2026-09-13 fix[Vision]: 修复了ai请求的截断bug - 同时简化了提示词
    [ai_client.cpp]
2026-09-13 fix[Mobile/Vision]: 修复了蓝牙连接及json传输bug
2026-09-13 fix[Mobile/Vision]: 修正了arm_pose指令的描述及其功能
2026-09-13 refactor[Mobile]: 统一了蓝牙的连接入口 - 启动自动连接现在变为失败后5s会自动重试
2026-09-13 feat[Vision]: 添加了任务列表以便AI确认任务进度
2026-09-13 refactor[Mobile]: 整理了代码文件 合并 - 整理了文件并合并了一些模块 - 拆分了一些模块以保持整体的风格统一 - 合并了部分指令并修复了一些错误
2026-09-13 feat[Vision]: 添加了手机端通过指令调用fold动作的功能
2026-09-14 feat: AI连续性优化 - 用比较规范的方式附加了ai前几轮的历史思考 - 优化了插话的插入位置及退出机制 - 移除了先前的动作记录机制 - 微调了提示词
2026-09-14 refactor[Vision]: 将坐标映射单独拆为一个模块
2026-09-15 fix[Mobile/Vision]: 修复了一些蓝牙相关的错误 - 修复了部分指令无法在仅蓝牙连接状态下使用的bug - 修复了状态同步的问题
    [app_httpd.cpp, ble.cpp, ble.h, command.cpp]
2026-09-15 feat[Vision/Mobile]: 优化机械臂运动曲线，添加了缓动插值 - 同时修复了机械臂移动时的限位异常问题 - 重做了机械臂的移动模型 - 添加了新的调试指令
    [ai_client.cpp, bivar.cpp, bivar.h, command.cpp, direct_exec.cpp, nezha_direct.cpp, nezha_direct.h]
2026-09-16 feat[Vision/Mobile]: 添加了直接移动到指定点的功能 - 给ai添加了快速接近目标的工具 - 添加了移动至指定坐标的指令
2026-09-16 feat[Mobile]: 手机端细节优化 - 添加了直接滑动切换页面的功能 - 修改了指令提示的样式以避免文字显示问题 - 修改了蓝牙扫描页的显示刷新逻辑
2026-09-16 refactor[Mobile/Vision]: 重构了日志模块 - 使用统一的日志模块来路由调试输出
2026-09-16 chore[Vision]: 代码文件整理及模块合并 - 整理了原本平铺在目录内的代码文件 - 将需要手动校准的内容存放到了单独的文件
2026-09-19 fix[Vision]: bug修复 - 修改了i2c的引脚（原本的疑似坏了） - 重新校准了屏幕坐标与实际坐标的转换 - 修复了AI请求时的报错问题
    [partitions.csv]
2026-09-19 fix[Vision]: 稍微修复了机械臂的移动问题
2026-09-19 refactor[Vision]: AI模块重构及优化 - 简化代码拆分模块 - 提示词及规则优化 - 小车状态感知优化 - 画面坐标映射校准
2026-09-20 feat[Vision]: AI模块相关调整 - 调整了提示词, 用逻辑清晰的格式重写了规则 - 调整了历史对话长度 - 修复了一个传输报错bug - 修复了相机抓帧的一个内存溢出问题
    [ai_client.cpp, ai_http.h, ai_mem.h, ai_prompt.cpp, app_httpd.cpp, camera.cpp]
2026-09-21 fix[Vision/Mobile]: 修复了图传异常卡顿及延迟过高的问题 - 修复了TX队列满后直接弃帧导致的帧率低bug (需要设置CONFIG_ESP_WIFI_CACHE_TX_BUFFER_NUM 32 并且重新编译库) - 修复了帧延迟过高的bug
    [app_httpd.cpp]
2026-09-21 feat[Vision]: 添加了ota模块 - 这下不用老是插拔板子了
    [partitions.csv]
2026-09-21 feat[Vision/Mobile]: 调试功能新增 - 添加了一些标识版本的东西 - 添加了软重启指令
2026-09-22 chore[Vision]: 添加了一些调试用工具 - 涵盖ota更新, 日志读取等自动化操作 - 添加了重编库需要的东西
2026-09-22 feat[Vision]: 优化了AI的任务执行能力 - 添加了运动校验模块 - 添加了放大镜工具 - 重新校准了坐标 - 修复了连接链路上的部分问题 - 添加了内部堆/DMA 块水位哨兵(收包红线监测) - 为了配合调试工具做了适当改造 - 添加了 AI 抓帧留档(6 槽 PSRAM 环形) - DIRECT 闭环大幅扩展(zoom/carry_prev/tasks/sanitize/参数校验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
    评论:
    目前ai可算是能tmd跑起来了, 虽然过程中还有很多待优化的地方, 但是也算是取得了一个阶段性的成果
    [Calibration.h, Stm32-Vision.ino, ai_client.cpp, ai_dump.cpp, ai_dump.h, ai_http.cpp, ai_mem.cpp, ai_mem.h]
2026-09-24 feat[Vision]: AI任务相关模块调整 - 移除了部分多余的近场限制 - 优化了放大镜工具, 使其采集真实的清晰画面而不是单纯放大 - 移除了部分多余调试输出并添加了一些利于复盘ai决策的输出 - 修复了灯的初始状态错误bug - ai请求的取帧会等待机械臂移动完毕 - 重新校准了旋转并限制了旋转速度的档位数量
    [Calibration.h, ai_client.cpp, ai_http.cpp, ai_mem.cpp, ai_mem.h, app_httpd.cpp, ble.cpp, board_log.cpp]
2026-09-24 feat[Vision]: AI模块优化 - 重构了系统提示词 - 将部分以用户身份发送的提示词改为以system发送 - 修复了approach的一些行为问题 - 优化了AI对于附加图片的选择和查看能力 - 优化了相机配置切换的AWB问题 - 优化了机械臂的状态显示
    [ai_client.cpp, ai_dump.h, ai_prompt.cpp, ai_prompt.h, camera.cpp, direct_exec.cpp]
2026-09-24 feat[Mobile]: 手机端会在执行/clear时清空本地日志文件内容
2026-09-25 feat[Mobile]: 添加了虚拟按键区的显示开关 - 同时将虚拟按键显示状态, 图传状态和发送的历史文本都持久性保存 - 修复了程序在小窗状态下页面宽度错误的问题 - 修复了部分弹出弹出后页面能够被响应的bug
2026-09-25 feat: AI模块调整 - 扩大了不报坐标的边界 - 继续优化提示词, 提升AI的判定准确性及决策速度 - 又又又又修正了坐标单应表 - 允许AI自己暂停任务并等待用户输入 - 给非用户实际发送的图片内容添加了提醒 - 把部分snprintf换成了直接传指针
    [Calibration.h, ai_client.cpp, ai_mem.cpp, ai_mem.h, ai_prompt.cpp, command.cpp, direct_exec.cpp]
2026-09-25 refactor[Vision]: 重构ai_client.cpp为多个模块 - 同时顺手处理了编译时的多个警告 - 移除了motion_verify模块（感觉除了浪费性能没什么乱用） - 移除了一些死代码和注释 - 提示词微调
2026-09-25 docs: 文档更新 - 代码部分只是轻微调整
2026-09-26 feat[Vision]: 状态显示优化及工具调整 - 把无用的状态字段移除 - 调整了空间提示的样式以及信息 - ai的实际行动会塞回上下文 - 简化了部分工具的使用 - 改了提示词，但是还在改
2026-09-27 refactor[Vision]: 从原本的对话时任务循环重构为agent时的工具调用循环 - 画面或图片查看改为单独的look工具并可自行选择查看的内容，且不再总是以user身份发送 - 小车及机械臂状态行、任务目标、列表及备注改为附加在末尾 - 物体记忆等带有坐标的独立为单独的工具，避免干扰AI决策 - 顺带简化了部分工具的调用, 移除了部分效果不可靠的工具以及基本没用的字段 - 修改了上下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
    评论：
    - 这里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
2026-09-27 feat: AI相关功能优化 - 教会了AI怎么放置方块到指定位置 - 将物体记忆，任务规划，目标状态设置独立为单独的工具避免AI使用时混乱
2026-09-28 feat[Vision/Mobile]: 手机端添加了AI使用工具的提示 - 修复了使用压缩后的图片保留问题 - 处理了AI喜欢英文思考的问题 - 修复了一些校验问题 - say的内容会附加到调用结果
    [ai_prompt.cpp, ai_result.cpp, ai_result.h, ai_round.cpp, ai_validate.cpp, registry.cpp, tool.h]
2026-09-28 perf(Vision): 性能优化 - 简化了一些不必要的内存分配或拷贝 - 重构了AI任务每轮的请求构及发送以避免每轮都要重新构造请求
2026-09-28 refactor[Mobile]: 重构了图片编辑模块 - 把图片编辑从单独的弹窗内编辑改为在图传画面上编辑
2026-09-28 fix[Vision]: 修复了相机配置切换失败不会重试的bug
2026-09-28 fix[Vision]: 优化AI的执行能力
2026-09-28 feat[Mobile/Vision]: 在手机上添加了任务面板以显示相关内容 - 移除了任务相关功能的字数限制 - 添加了提醒避免ai结束任务时忘了说话
2026-09-29 feat[Mobile/Vision]: 添加了会话回放及更全面的状态管理功能，并且微调了UI样式 - 移除了旧的图标素材并用新形式做了图标包 - 添加了记忆作为手机端的画面源，实时监视小车记忆中的物体位置 - 添加了回放功能，在任务结束后可以逐步回放执行过程，便于测试 - clear指令现在会额外执行归档会话的操作了 - 清理了手机端的死代码 - AI任务在被clear前不会主动清理上下文，便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
2026-09-29 fix[Vision]: 修复了发送图片时没有编号导致AI不知道哪个是参考图的问题
2026-09-29 feat[Vision]: 调整了图片质量
2026-09-29 chore[Vision]: 微调了提示词
2026-10-01 feat[Vision/Mobile]: 添加了自动夹取物体的功能 - 手机端添加了相应指令，以及直接在画面标记目标的调试工具 - 手机端在自动夹取期间会使用简略画面 - 板端添加了自动夹取物体的功能
2026-10-02 feat[Vision]: 给AI添加了自动夹起工具
2026-10-02 fix[Vision]: 修复了AI任务与自动夹取相关的bug - 缓解了内部栈空间不足的问题 - 小幅优化了自动夹取功能的准确性
    [Calibration.h, ai_mem.cpp, ai_prompt.cpp, camera.cpp, command.cpp, direct_exec.cpp, grasp.cpp, track.cpp]
2026-10-03 feat[Vision/Mobile]: AI任务与自动夹取功能相关优化 - 优化了自动夹取的跟踪稳定性 - 补上了手机端缺失的会话回放时的跟踪画面 - 优化了AI在执行放置任务时的能力
2026-10-03 feat[Vision]: 添加了新的放置并后撤动作 - 同时调整了提示词
2026-10-03 fix[Mobile]: 修复了回放不显示跟踪画面的问题
2026-10-03 feat[Mobile]: AI模型选择改为自动获取列表 - 至于获取不到列表怎么办, 我只能说暂时懒得做手动输入的
    [export_presets.cfg]
2026-10-03 fix[Vision]: 移除了系统提示中关于小车全局坐标的部分, 避免误导AI
2026-10-03 docs: 文档及readme更新 - 同时补全了缺失的图片
2026-10-04 fix: 修复了画面显示的数个bug - 修复了发送的带有标记的画面会被跟踪的bug - 修复了跟踪框不消失的bug
    [ai_round.cpp, track.cpp]
